KevinQianjin/ASRC_snake_body_design/simulations/u4m2/README.md

# 伸縮後端＋U/M前端：第一輪平面計算

## 結論

固定斜軸後端有穿過底孔及在箱內伸入的幾何空間；較大截面鋁管的理想梁撓度亦可控制在毫米量級。但目前不能確認整機可安裝並帶500 g工作。主要限制是柔性前端的重載下垂、極窄的靜態擺放窗口，以及尚未找到的進入路徑。

在這次有限搜尋中，通過局部穩定、≤5%軸向應變診斷、自包絡及CAD靜態間隙初篩的細網格案例只有U3/M7、20°、上繩8 N：

- 從A孔沿正長度方向送入，接口沿斜軸位置約883.45–884.28 mm；窗口僅0.83 mm。
- 前導向基準在入口沿軸後退200 mm，因此後端外露長約1084 mm，超出原先暫定1000 mm。
- 前端頭部低於接口約350 mm；最大軸向應變約4.55%。5%是診斷門檻，並非實測允許變形。
- 前端及頭部暫用32 mm膠囊包絡，與CAD實體要求5 mm間隙；該案例在最窄處只比此間隙要求多約0.1 mm。
- 保持同一已載荷形狀沿軸送入時會碰撞。沒有求解主動改變前端形狀的完整插入路徑，不能把這項失敗當成所有部署方式都不可行的證明。
- 此靜態幾何初篩先將後端視為剛性；另算的後段理想梁下垂約0.83 mm，尚未迭代耦合到前端與間隙，接頭與公差也未計入。因此不把該窄窗口當成可用設計。

若限制後端從前導向基準至接口最多1000 mm，本輪搜尋未找到通過上述低應變靜態診斷篩選的姿態。未證明全控制域無解。

## 輸入與假設

| 項目 | 本輪設定 |
|---|---|
| 油箱來源 | Google Drive `Fuel Tanke Setup 2nd design.step`，2026-10-22版本 |
| 原檔連結 | https://drive.google.com/file/d/1ddxQdy7Ntn-YRJYCHj-clbpXVldIivso/view |
| CAD處理 | 選取油箱子樹，剔除外部測試架；保留本體與五金 |
| 平面座標 | 長度=-原X，高度=原Y；寬度=-原Z，單位mm |
| 切面 | 寬度648 mm主截面；632/664 mm前端側切面；628/668 mm後端側切面 |
| 前端 | 10節×48 mm=480 mm柔性段＋20 mm無質量剛性接口；未縮放原模組物性 |
| 配比與排列 | U3/M7、U5/M5、U7/M3，U在近端，M在遠端 |
| U安裝 | 高剛度Y彎曲平面對應本輪垂直平面；未驗證左右能力 |
| 頭部 | 500 g集中力，幾何包絡暫按直徑32 mm，無偏心力矩 |
| 繩索 | 四繩、導孔半徑13 mm、原有PA6實心代理EA與線密度、無摩擦；錨定頭部 |
| 後端幾何 | 箱外固定套管50 mm；活動段採保守40 mm全長截面包絡；額外間隙5 mm |
| 後端結構 | 40×40×2與30×30×2鋁方管分段梁；另算單30×30×2對照 |
| 鋁材假設 | E=69 GPa，密度2700 kg/m³；240 MPa僅為未選定材料的強度假設，不作採購或額定依據 |
| 支承 | 最前導向基準在入口中心沿軸後退200 mm；箱外固定套管長暫300 mm |
| 伸縮接頭 | 梁計算先忽略接頭柔度與間隙；不是實際伸縮接頭驗證 |

實際頭部外形、質量分布、接頭重疊、電機、支架與線管尚未確定。五個離散寬度切面不是完整三維掃掠。

## 計算範圍與解讀

1. `cad_sections.py`以OCP對真實CAD零件與平面做Boolean交集，保留截面面域與孔。曲線離散弦高0.1 mm；皮板／孔框面積與原CAD面積核對。五截面沒有Boolean或離散失敗；中心面一個小五金件的0.007 mm端點誤差以明列0.02 mm容差連接。
2. 後端軸線幾何掃描兩個入口、兩個伸入方向、5–30°（1°步長）；孔內接口位置0–1000 mm。另列被強制保持直線的500 mm前端幾何，該直線不是500 g力學解。
3. 柔性前端採幾何非線性、可軸向伸縮桿及真實端盤導孔。10/15/20°完成612次力控制嘗試；25/30°另補60次上繩力控制。數值界限與力網格詳各程式／JSON，均不是硬體額定值或材料強度。
4. 15組穩定且≤5%應變的最大前伸代表狀態做同張力4→8單元／節加密；頭部最大差約0.106 mm。這是同張力比較，並非相同捲筒指令比較。
5. 初始10 mm位置網格之外，對低應變候選用連續高度優化與0.25 mm間隙補查，再以邊界求根核對窄窗口。最終以`adaptive_summary.json`及`study_validation.json`為準；`planar_summary.json`只記錄原粗網格。
6. 固定形狀的插入檢查另以2 mm位移步長檢查碰撞，沒有把靜態通過當成部署通過。
7. 端部固定繩長穩定性是局部平面診斷；另加1 m自由繩長只做不變姿態／張力下的切線剛度敏感性，沒有求解相同winch指令的新姿態。

## 圖片（全英文）

- `results/planar_installation.png`：強制幾何姿態與載荷平衡的實際CAD截面比較。
- `results/front_and_geometry_limits.png`：U/M重載形狀及不同斜角的幾何伸入限制。
- `results/rear_beam_screen.png`：理想後段管體的撓度與名義應力。
- `results/deployment_path.png`：保持載荷形狀送入時的碰撞檢查。

## 重算

保留原有模型與結果，本研究全部另存。主要入口：

```powershell
python simulations/u4m2/cad_sections.py
python simulations/u4m2/rear_beam.py
python simulations/u4m2/front_solver.py
python simulations/u4m2/refine_front.py
python simulations/u4m2/front_angle_extension.py
python simulations/u4m2/planar_clearance.py
python simulations/u4m2/adaptive_screen.py
python simulations/u4m2/verify_study.py
python simulations/u4m2/render_results.py
```

為節省空間，已按使用者要求移除大型隔離CAD執行庫與安裝暫存；已有結果、圖片、程式及STEP來源仍保留。重新擷取CAD截面或執行間隙／繪圖程式前，需重新安裝依賴：

```powershell
python -m pip install --target simulations/u4m2/_cad_runtime --no-deps -r simulations/u4m2/requirements-cad.txt
```

數值計算另需NumPy、SciPy、Matplotlib。原始STEP及原有力學kernel雜湊保存在驗證JSON中。

## 下一步應先驗證什麼

先釐清500 g頭部真實外形，以及插入時是否允許導向輔具或主動改變前端形狀。後續應先解部署路徑與帶載前端控制，再定後端行程與接頭設計。現階段不建議僅憑理想梁的小應力就製作整機。

## 補查：插入張力與增加U

依使用者新指示，`insertion_tension_study.py`另計U7/M3、U8/M2、U9/M1及全U對照，根部仰角15/20/25°，上繩差動張力0–200 N有限網格，四繩共同基準0或2 N。U的高剛度彎曲平面始終朝向重力造成的彎曲；此取向在前一輪也已採用。

912次嘗試中752筆收斂。未找到同時符合暫定接近直線條件（最大軸線偏差10 mm、切線誤差5°、軸向投影至少475 mm，以及5%應變診斷門檻）的案例；這些指標不是經使用者核准的正式驗收值。12個低應變代表姿態做8單元／節加密。大拉力下可能出現大壓縮或回折，不能將較小的軸線距離直接當成拉直。

此補查仍沿用四繩全部錨在頭部，沒有求解隨插入深度改變張力的完整避障軌跡，也沒有重算CAD間隙。結果於`results/insertion_tension_*`，圖中文字全英文；不需要重新安裝CAD依賴即可執行本項補查。

## 補查：分段錨定與局部路徑

`segmented_tendon_study.py`比較U8/M2、U9/M1，仰角20°、頭重500 g；單一頭部錨定、U/M交界兩組錨定、三組錨定及每節錨定對照。各組繩索均從基部經真實端盤到達自身錨點，沒有假設虛構的局部致動器或不受壓前端；遠端繩索仍壓縮近端模組。每組按四條繩索計質量，本平面只優化上繩。增加錨點需要改導孔與布線，既有四個導孔不能視為已能容納新增拉索。

最佳已找到局部解的8單元／節診斷（不是全域最優）：

| U9/M1架構 | 最大軸線偏差 mm | 沿軸投影 mm | 最大絕對軸向應變 | 局部穩定診斷 |
|---|---:|---:|---:|---|
| 單組 | 406.4 | 101.5 | 17.5% | 通過 |
| 兩組 | 245.1 | 310.2 | 7.4% | 未通過 |
| 三組 | 26.4 | 450.3 | 12.2% | 通過 |
| 每節一組（10組） | 2.44 | 459.3 | 13.9% | 通過 |

U9/M1每節錨定解的最大壓縮發生在第1節U；U8/M2對照最大壓縮則在第9節M，達28.3%。因此更多分段控制能改善曲線，卻沒有消除軸向承載問題。所有大應變結果仍是原線性EA外推，不是塑性、壓屈或實際模組耐久預測。10組錨定是複雜度對照，不是已選定的製作方案。

另以粗網格軸向應變≤5%作限制進行局部優化（`--low-strain`），未找到接近直線的解；同張力加密後應變約5.03–5.23%，因此也不能將粗網格邊界解當作嚴格5%通過。求解器的變形界限與每組250 N張力上限只是明示數值界限，並非材料／致動器額定能力。

`lightweight_path_check.py`直接用已保存的CAD多邊形及NumPy計算間隙，不需重新安裝CAD庫；與先前OCP/Shapely參考間隙的差小於1e-6 mm。U9/M1的10組錨定高應變診斷形狀，在頭部已先進入後，接口位置s=-180至400 mm（2 mm步長）的局部伸入路徑未碰撞，前端包絡最小間隙約24.52 mm。這沒有驗證最初將頭部送入、伸縮套管內部收納／布線、實際大應變行為或完整三維部署。

新圖：`results/segmented_tendon_comparison.png`及`results/segmented_insertion_path.png`，全部英文。新增程式與數據保持小型，未安裝新的CAD執行庫。
