KevinQianjin/ASRC_snake_body_design/simulations/u4m2/backbone_20261108/README.md

## Position-controlled round-trip study (11 November 2026)

See [the generated report](length_cycle_results/REPORT.md) for the forward-solved
12-rope length-control cycle, full-tank sampled clearance, consistent elastic-rope
stability and one-factor sensitivity cases. This extends the earlier force-based
sweeps; it does not establish hardware performance or continuous collision safety.

- `length_cycle.py`: straighten from a defined slackened equilibrium, enter,
  right/return, left/return and withdraw; 8 cells/module.
- `summarize_length_cycle.py`: acceptance failures, provenance and comparison plot.
- `test_length_cycle.py`: numerical energy/gradient/Hessian and mesh-query checks.
- `length_cycle_results/`: per-step CSV/JSON, states and aggregate report.

# M module with 1.8 mm NiTi backbone: straightening and steering

2026-11-08 · 63 mm · 24 mm tendon radius · 500 g head · follow-up to `../m_axial_sweep_20261108`

This study adds a central Ø1.8 mm NiTi rod to every M module, including its mass, and re-runs two of the 2026-11-06 studies:

- the planar active-straightening study (U4+M2, U6+M3 and U8+M4 at 15°, 20° and 25°);
- the spatial steering and held-elevation study (U4+M2).

The physical build and test plan is in [`M_BACKBONE_TEST_PLAN.md`](M_BACKBONE_TEST_PLAN.md).

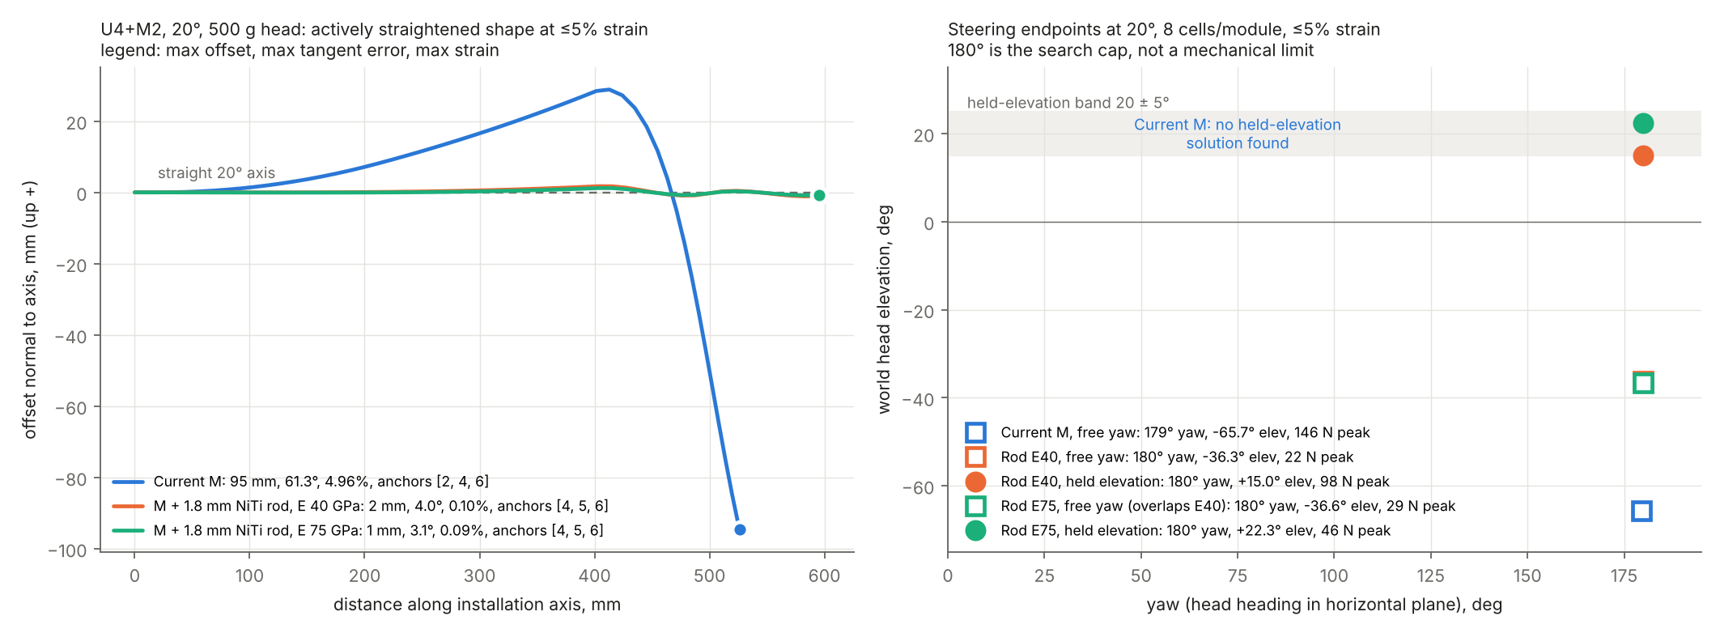
[picture p1: simulations/u4m2/backbone_20261108/results/backbone_results.png]
Backbone results


## Rod model

| | M (database) | + rod, E = 40 GPa | + rod, E = 75 GPa |
|---|---:|---:|---:|
| EA, N | 166.7 | 101,954 | 191,018 |
| EI, N·m² (both planes) | 0.0441 | 0.0647 | 0.0828 |
| Module torsion, N·m/rad | 0.437 | 0.599 | 0.740 |
| Mass per M module, g | 23.948 | 25.524 | 25.524 |

- The rod is modelled as central, bonded to the module end disks and bending with the module, so its stiffness adds to the module's.
- E = 40 GPa represents a martensite or low-modulus lower bound; 75 GPa represents austenite. Torsion uses ν = 0.33.
- Rod end fittings and guides are not included in the mass. Neither are friction, NiTi phase transformation or contact.
- All other inputs are identical to the 2026-11-06 studies. The kernels are reused through `backbone.py` and are not modified.

## 1. Planar active straightening (`backbone_planar.py`)

The best stable result at ≤5% strain at 8 cells per module is shown below. "Pass" means all straightness checks pass: offset ≤ 10 mm, tangent error ≤ 5°, axial projection ≥ 95%, strain ≤ 5%, and stable.

| Configuration | Pitch | Current M | Rod, E = 40 GPa | Rod, E = 75 GPa |
|---|---:|---|---|---|
| U4+M2 | 15° | 89.7 mm / 57.5° — fail | **1.8 mm / 4.1° / 0.10% — pass** | **1.2 mm / 3.2° — pass** |
| U4+M2 | 20° | 94.7 mm / 61.3° — fail | **1.7 mm / 4.0° / 0.10% — pass** | **1.2 mm / 3.1° — pass** |
| U4+M2 | 25° | 99.1 mm / 64.9° — fail | **1.7 mm / 3.7° / 0.09% — pass** | **1.2 mm / 3.0° — pass** |
| U6+M3 | 20° | 176.8 mm / 87.2° — fail | 10.5 mm / 15.1° — fail | 9.6 mm / 10.5° — fail |
| U8+M4 | 20° | 278.0 mm / 98.1° — fail | 135.2 mm / 102.5° — fail | 19.2 mm / 29.9° — fail |

- **U4+M2 passes at all three pitches**, with anchors [4,5,6]. At 20° and E = 40 GPa, the top-rope tensions are 91.5, 21.4 and 8.5 N.
- **U6+M3 and U8+M4 do not pass** with three or fewer anchor sets. A search of every three-set layout with one set at the head (28 for U6+M3 and 55 for U8+M4, each at both moduli, 20°, `--all-three`) found no passing case. The closest was U6+M3 with anchors [7,8,9], at 5.04° tangent error but a 24.5 mm offset. Their M sections are longer, and gravity bending between anchor disks grows with the length of each span.
- The current-M (no rod) column reproduces the 2026-11-06 report values, for example 94.68 mm at 20° for U4+M2.

## 2. Spatial steering and held elevation, U4+M2 (`backbone_steering.py`, `refine_backbone_steering.py`)

The procedure, bounds and acceptance rules follow 2026-11-06:

- tendon tension 0–250 N;
- coarse strain bound ±4.75%;
- 180° angle search cap;
- geometry, capsule and fixed-winch stability checks.

Candidates start at 2 cells per module and are refined to 4 and then 8. A candidate is reported only if it passes at 8 cells. "Held elevation" means yaw with the world head elevation within base pitch ± 5°.

| Variant | Pitch | Free yaw (elevation, peak N) | **Yaw with held elevation** (elevation, peak N) | Up / down |
|---|---:|---|---|---|
| Current M | 20° | 179.4° (−65.7°, 146.5 N) | **none found** | −56.6° / 113.8° |
| Rod, E = 40 GPa | 15° | 180°* (−33.3°, 24.4 N) | **165°** (+10.0°, 56.5 N)† | 180°* / 180°* |
| Rod, E = 40 GPa | 20° | 180°* (−36.3°, 22.2 N) | **180°*** (+15.0°, 98.3 N) | 180°* / 180°* |
| Rod, E = 40 GPa | 25° | 180°* (−39.5°, 21.1 N) | **180°*** (+30.0°, 246.9 N) | 180°* / 180°* |
| Rod, E = 75 GPa | 20° | 180°* (−36.6°, 29.3 N) | **180°*** (+22.3°, 46.2 N) | 180°* / 180°* |

\* Reaches the 180° search cap. This is not a demonstrated mechanical limit.
† At 15°, no 180° held state survived the 8-cell check: it was unstable at +10° elevation. The largest lower cap that passed was 165°.

- The no-rod control reproduces the 2026-11-06 results exactly at 8 cells: 179.42°, −65.67°, 146.48 N, and no held-elevation solution.
- **With the rod, the head can be swept through the full ±180° yaw search range while held near the working elevation**, at well under 1% strain. This was the main unsolved problem (priority 2) in the 2026-11-06 report.
- Strain is no longer limiting: it stays at or below 0.62% everywhere. The constraints that now decide the result are tension, stability and the elevation band.
- **The tensions are one allocation found by the optimizer, not minimum-force solutions.** The 8-cell re-optimization maximizes angle only, so tensions can rise during refinement: at 20° and E = 40 GPa, the 2-cell candidates needed about 33 N, while the 8-cell result needs 98 N. The 25° held case sits near the 250 N bound and at the edge of the elevation band. Minimum-tension allocation is a recommended next step.
- "Up 180° at elevation = −pitch" means the head has turned over the top and points back. Whether the intermediate postures form a continuous controllable path is not established.
- Full tension sets for every endpoint are in `results/steering_summary_8cell.json`. Each row is one anchor set, in the order [up, right, down, left], in N.

## 3. Tank entry screen with the straight low-strain shape (`entry_screen.py`, 2026-11-09)

This re-runs the 2026-11-06 front-only entry screen, reusing `path_check()` from `../stiffness_63mm_20261106/postprocess.py` unchanged. The best stable shape at ≤5% strain is held at fixed tension and translated along the installation axis through the bottom opening at x = 449 mm. The run starts with the whole front and head outside the tank and steps 4 mm, then 2 mm. Pass requires:

- the 63 mm envelope stays at least 5 mm clear of the five saved CAD width sections (628–668 mm) along the whole path;
- the front ends fully inside the sampled cavity.

Passing shapes are re-solved at 16 cells per module with the same tensions and re-checked. As a control, the 2026-11-06 U4+M2 20° shape-only result (62.06 mm) is reproduced exactly.

| U4+M2 | Pitch | Strain | Min gap, 8 cell | Min gap, 16 cell | Final clamp s | Result |
|---|---:|---:|---:|---:|---:|---|
| Current M | 15° / 20° / 25° | 4.96% | hits the tank at s ≈ −336 mm | — | — | fail |
| Rod, E = 40 GPa | 15° | 0.10% | 44.5 mm | 44.3 mm | 114 mm | **pass** |
| Rod, E = 40 GPa | 20° | 0.10% | 64.3 mm | 64.0 mm | 90 mm | **pass** |
| Rod, E = 40 GPa | 25° | 0.09% | 16.6 mm | 16.9 mm | 78 mm | **pass** (tight) |
| Rod, E = 75 GPa | 15° / 20° / 25° | 0.09% | 44.6 / 64.6 / 16.1 mm | 44.5 / 64.4 / 16.2 mm | 114 / 90 / 78 mm | **pass** |

- **This is the first low-strain shape to pass the entry screen.** On 2026-11-06, only shapes at 17% or more strain passed; every low-strain shape sagged into the tank.
- The margins match the 2026-11-06 high-strain straight shapes (44 / 62 / 20 mm), so the rod gives the same geometry at about 1/170 of the strain.
- **Where the limit is:**
  - At 15° and 20°, the tightest point is the distal M section passing internal structure just after the head enters, at clamp s ≈ −355 mm.
  - At 25°, crossing the opening is comfortable (about 50 mm), but at the final placement the head is only about 19 mm below the roof. 20° remains the preferred installation angle.
- U6+M3 with the E = 75 GPa rod passes only at 15° (40 mm). It fails at 20° and 25°, and every U8+M4 case fails. U4+M2 remains the development length.

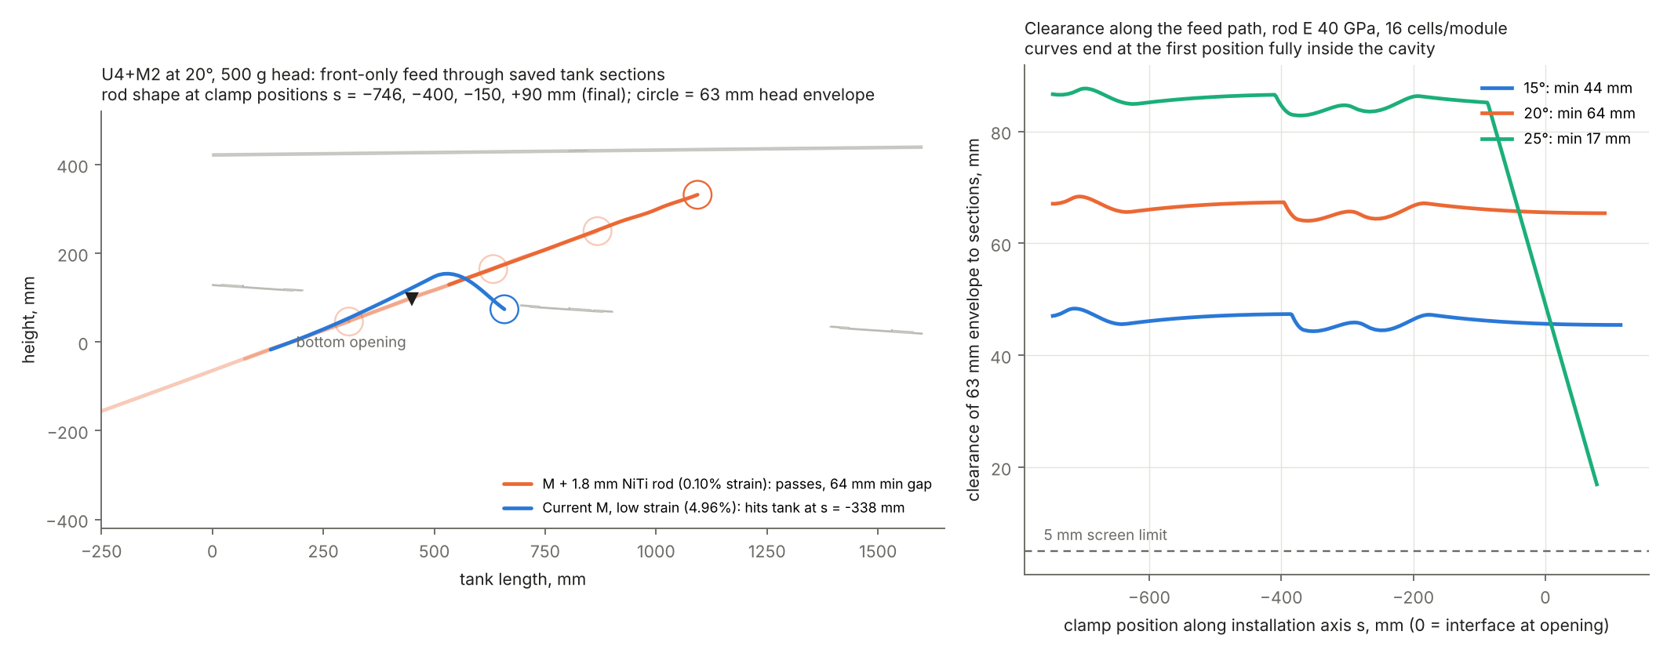
[picture p2: simulations/u4m2/backbone_20261108/results/entry_screen.png]
Entry screen


**Limits, unchanged from 2026-11-06:**

- Planar sweep of a fixed shape with a translating clamp.
- The five width planes do not cover the full 616.5–679.5 mm band of a 63 mm front.
- Not included: sleeve or guide contact, rear storage, rope take-up, retraction, tension changes during feed, and real head CAD.

This is a geometric screen, not a validated deployment.

## 4. 3D stability needs pretension on every rope (`pretension_recheck.py`, 2026-11-09)

The straightened states in sections 1 and 3 tension only the up ropes. They pass the planar stability check, but **in the 3D model they are laterally unstable** under the fixed-winch check (minimum eigenvalue −0.20 to −0.50), because the 2D model cannot see sideways buckling.

A **1 N pretension on all four ropes of every anchor set** stabilises every case. The straightening was then re-optimised with this pretension:

| U4+M2, anchors [4,5,6], +1 N on all ropes | 15° | 20° | 25° |
|---|---|---|---|
| E = 40 GPa: offset / tangent / strain | 1.86 mm / 4.2° / 0.11% | 1.82 mm / 4.0° / 0.11% | 2.00 mm / 3.5° / 0.10% |
| E = 40 GPa: top-rope tensions, N | 95.1, 21.8, 8.7 | 92.7, 21.2, 8.5 | 89.5, 20.5, 8.2 |
| E = 75 GPa: offset / tangent / strain | 1.28 mm / 3.3° / 0.10% | 1.25 mm / 3.1° / 0.10% | 1.21 mm / 3.0° / 0.10% |
| All straightness checks, 3D stable | yes | yes | yes |
| Tank entry minimum gap, E = 40 / 75 GPa | 44.6 / 44.7 mm | 64.2 / 64.6 mm | 17.2 / 16.1 mm |

The conclusions of sections 1 and 3 stand **with a minimum 1 N pretension on every rope**. This should become a control rule.

## 5. Minimum tendon force for held-elevation yaw (`min_force_sweep.py`, 2026-11-09)

**Method.** The yaw target is stepped from 0° to 180° by continuation, each step seeded from the previous solution. At each step the optimiser minimises the **largest single rope tension** subject to:

- equilibrium;
- yaw equal to the target;
- world head elevation within pitch ± 5°, or held exactly at pitch;
- the 2026-11-06 geometry and projection constraints;
- strain within ±4.75%;
- 1–250 N per rope.

Each state is solved at 4 cells per module, then re-solved at 8 cells (re-optimised if needed). It is accepted with the unchanged 2026-11-06 rules, including fixed-winch stability, and must be within 1° of the target yaw. An optional penalty on changing tensions between steps (`--smooth`) selects a smooth allocation among the many allocations with nearly the same peak.

| Run (elevation held exactly at pitch, 5° steps) | Passing states (8 cell) | Peak rope tension | Largest change per step |
|---|---|---|---|
| E = 40 GPa, 20°, anchors [4,5,6], smooth | 36/37 (0–175°) | **7.1–14.8 N** | 5.1 N |
| E = 40 GPa, 20°, anchors [4,5,6] | 37/37 (0–180°) | 7.0–14.8 N | 13.8 N (allocation jumps) |
| E = 40 GPa, 20°, anchors [4,6] | 36/37 (0–175°) | 13.3–22.0 N | 20.9 N |
| E = 75 GPa, 20°, anchors [4,5,6], smooth | 37/37 (0–180°) | 9.8–14.6 N | 4.4 N (10 N at the 180° step) |
| E = 40 GPa, 25°, anchors [4,5,6] | 37/37 (0–180°) | 6.7–13.3 N | 12.3 N |

Runs with the elevation anywhere in the ±5° band (15° steps) also pass at every step: E = 40 GPa at 15°, 20° and 25°, and E = 75 GPa at 20°; 7–21 N peak.

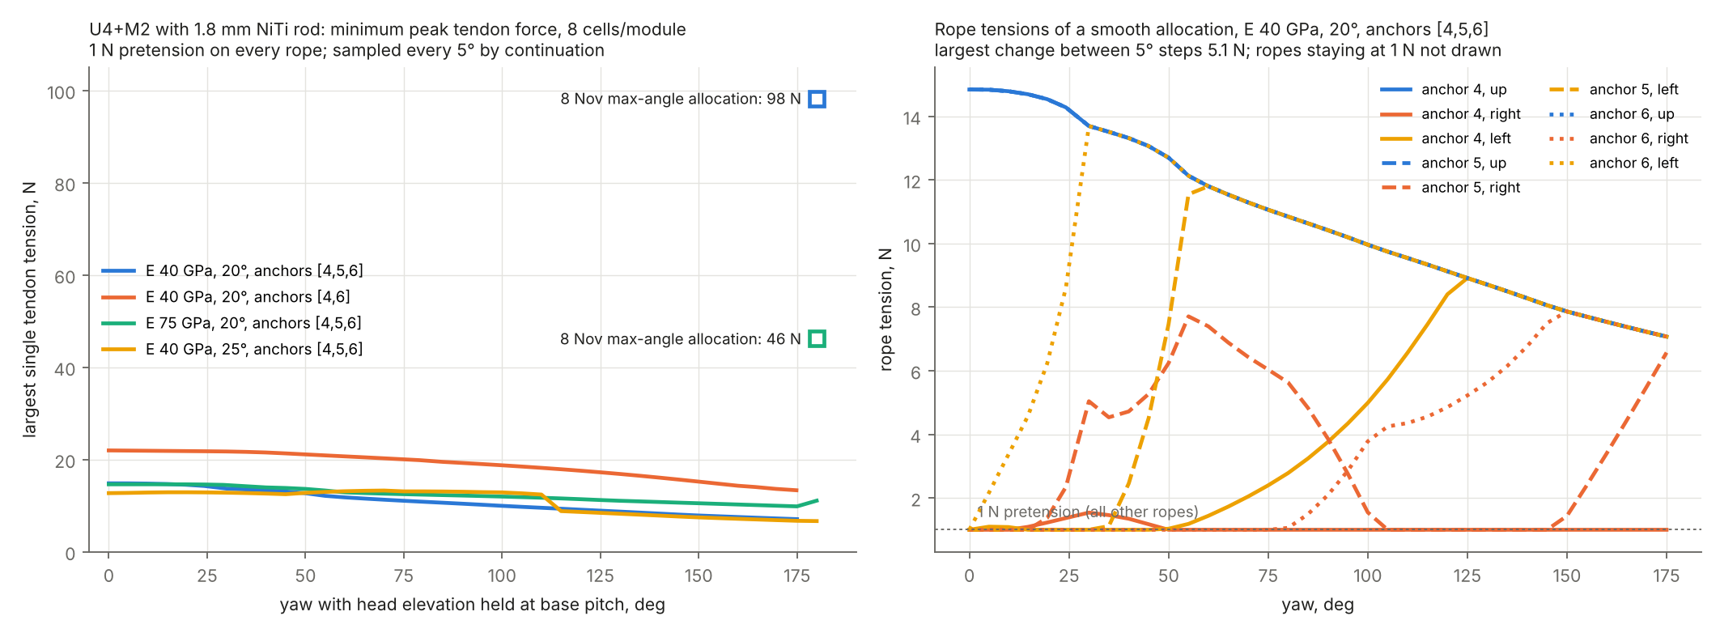
[picture p3: simulations/u4m2/backbone_20261108/results/minforce_results.png]
Minimum tendon force


- **Peak tendon force drops from 46–247 N (2026-11-08 allocations, which maximised angle only) to about 7–15 N** with anchors [4,5,6] and 13–22 N with [4,6]. Strain stays at or below 0.09%, and every reported state is stable.
- **Continuity.** With elevation held exactly at 20°, consecutive 5° states move the head at most 33–56 mm, consistent with yaw swept by the front. The smooth allocation changes no rope by more than 5.1 N per step (E = 40 GPa). This is strong evidence of a continuous quasi-static path from 0° to 175°, but sampled states do not prove one.
- **How the posture works.**
  - Mid-range yaw (30–90°) uses sideways M bending together with **30–55° of material twist** along the front.
  - Yaw near 180° is reached by curling M **up and back over itself** (about 140° of upward bend). The head ends up looking back toward the base at 20° elevation, about 270 mm above the interface.
  - Hardware must confirm that twist is acceptable, and the up-and-over posture must be checked against the tank roof, which was not part of this free-space study.
- The minimum-peak objective is degenerate: many allocations share the same peak. Without smoothing, the optimiser re-allocates freely between steps. Use the smooth allocation as the control reference.
- These are local optima, not proven global minima. The 1 N pretension and the 250 N bound are numerical choices, not hardware ratings.

## 6. Full 3D tank clearance (`tank3d_screen.py`, 2026-11-09)

**Method.**

- All 362 solids of the named tank subtree in `../../../cad/tank/tank-v2.step` (external frame excluded) are triangulated: 461,524 triangles at 0.5 mm deflection, cached in `_cache/`, not committed.
- Clearance is the exact distance from the front centreline to that surface, minus the 31.5 mm envelope radius. The minimum is found by a 20 mm pass refined at 2 mm near the closest region; this matches brute-force sampling exactly.
- The insertion plane is width 648 mm, the centre of the 2026-11-06 section band. The insertion point and axis are those of the 2D entry screen.
- Control: points on the boundaries of the five saved 2D sections lie within 0.23 mm of the 3D mesh.

**Entry path, full 3D, straight shape with 1 N pretension.** Minimum clearance up to the first fully-inside clamp position:

| Pitch | 2D sections (5 planes) | Full 3D |
|---:|---:|---:|
| 15° | 44.6 mm | 46.8 mm |
| 20° | 64.2 mm | 64.6 mm |
| 25° | 17.2 mm | 19.3 mm |

The full-width 3D result confirms the 2D screen. The 2D values were slightly conservative because they measured in-plane distance to planes up to 20 mm away sideways. **This closes the "5 planes do not cover the full 63 mm width" limitation of the 2026-11-06 entry screen.**

**Held-elevation yaw sweep in the tank.** The minimum-force states of section 5 were placed with the clamp held at depth s, yawing both right and left; the tank is not symmetric about the insertion plane.

| 20°, anchors [4,5,6], head held at 20° | s = 0 mm | s = 30 mm | s = 60 mm | s = 90 mm |
|---|---|---|---|---|
| E = 40 GPa, right (0–175°) | all clear, min 22.4 mm | all clear, min 12.6 mm | 33/36, min 2.8 mm | 26/36: clear to 130° |
| E = 40 GPa, left (0–175°) | all clear, min 30.9 mm | all clear, min 20.9 mm | all clear, min 11.0 mm | 33/36: clear to 160° |
| E = 75 GPa, right (0–180°) | all clear, min 23.5 mm | all clear, min 13.6 mm | 35/37, min 3.7 mm | 25/37 |
| E = 75 GPa, left (0–180°) | all clear, min 30.1 mm | all clear, min 20.1 mm | all clear, min 10.2 mm | 34/37 |

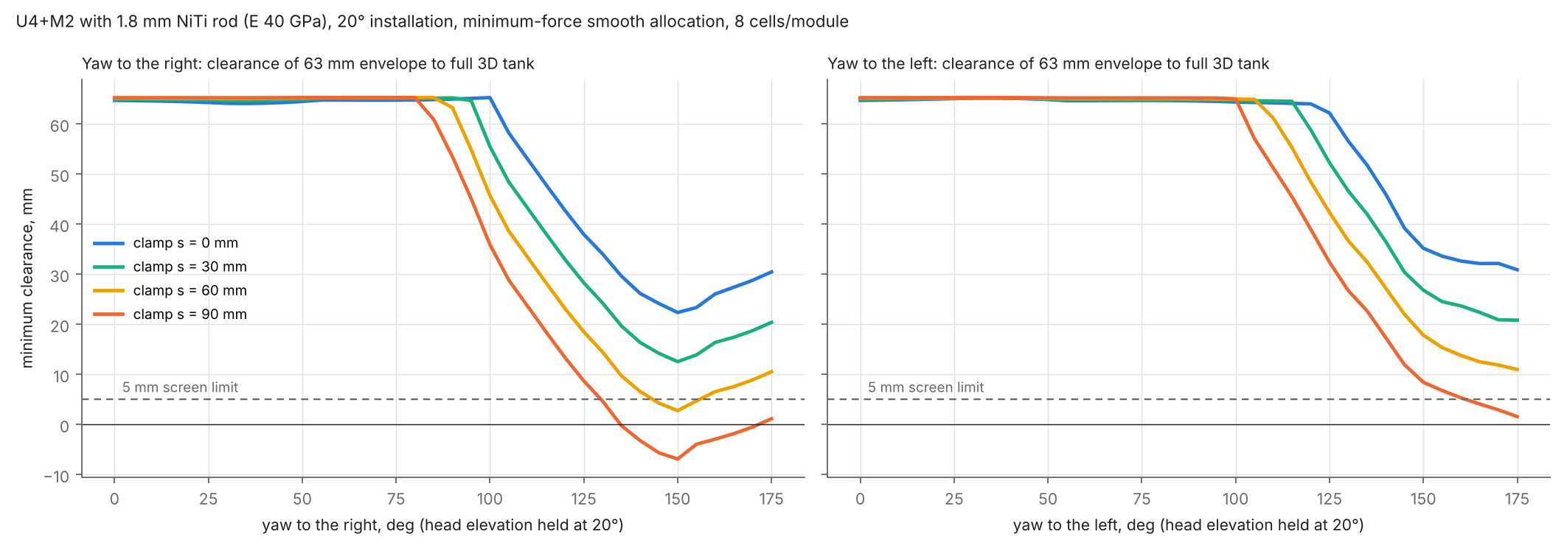
[picture p4: simulations/u4m2/backbone_20261108/results/tank3d_sweep.png]
3D tank clearance


- **At 20° with the clamp at s = 0–30 mm, the whole held-elevation sweep (0–175°/180°, both sides) clears the full 3D tank by at least 12.6 mm.** Clearance up to about 85° yaw stays at about 65 mm. It drops only for the up-and-over posture beyond about 100°, and the limit is always the **tank roof**, near height 365–430 mm.
- Pushing deeper (s ≥ 60 mm) raises the base and brings the curled M section into the roof. Recommended steering depth: **s ≈ 0–30 mm**, with the interface at or just past the opening.
- **25° fails** at every depth tested (s = 0–300 mm; at most 15 of 37 states clear). The front sits too close to the roof. **20° is the recommended installation angle.**
- Not included: the actual sensor head shape (a 63 mm envelope is assumed), cables and ropes outside the front, tolerances, dynamics, and contact with any sleeve. The steering states are free-space minimum-force equilibria placed in the tank, not tank-aware optimised postures.

## 7. Horizontal flexibility: yaw vs side-rope pull (`side_pull.py`, 2026-11-09)

**Start pose:** the straight held front at 20° (anchors [4,5,6], straightening tensions on the up ropes, 1 N on every rope).

**Test:** only the right rope is pulled — at anchor 6 (tip), 5, 4, or all three together. Each step is solved from the previous state at 8 cells per module, in free space; the left side is the mirror image.

**Two control modes:**

- **Tension control:** rope forces are prescribed.
- **Winch control** (realistic): rope lengths are set by the winches. Each rope is an elastic PA6 line (EA = 10.4 kN) with 1 m of free length, and the right rope is reeled in 0.25 mm per step.

**Finding 1: tension control is unsafe for the straight pose.**

- Under constant tensions the straight held front is laterally unstable (constant-tension eigenvalue −0.51 at E = 40 GPa, −0.28 at 75 GPa). Adding 0.5 N to the tip's right rope makes the head **snap 258 mm** to 124° yaw.
- Under winch control the same pose is stable (fixed-winch eigenvalue +0.73 / +0.76), because the elastic ropes resist the motion.
- **Rope length (position) control, or fast feedback, is required.** Tension-only control must not be used to hold the straight front.

**Finding 2: winch-controlled side pull**

| Pulled rope | Initial gain | Yaw while head stays in 20 ± 5° | Maximum yaw reached (head elevation) | Limit | Largest head jump per step |
|---|---|---|---|---|---|
| Anchor 6 right, E = 40 GPa | 1.27°/mm | **18.6°** (14 mm, 37 N) | 58.5° (−41°), 27 N | no further equilibrium | 1.0 mm |
| Anchor 6 right, E = 75 GPa | 1.23°/mm | **20.2°** (16 mm, 43 N) | 76.1° (−49°), 39 N | bend radius / capsule | 1.0 mm |
| All three right, E = 40 / 75 GPa | 1.36 / 1.35°/mm | 16.9° / 18.7° (65–71 N) | 27–30° (−17 to −25°), 142–163 N | bend radius / capsule | 4.3 mm |
| Anchor 5 right | 0.12–0.14°/mm | 8° | 34–39° (−34 to −40°) | bend radius / capsule | 1.6 mm |
| Anchor 4 right | ≈ 0 | 3–4° | 9–12° at 288–364 N | — | 1.3 mm |

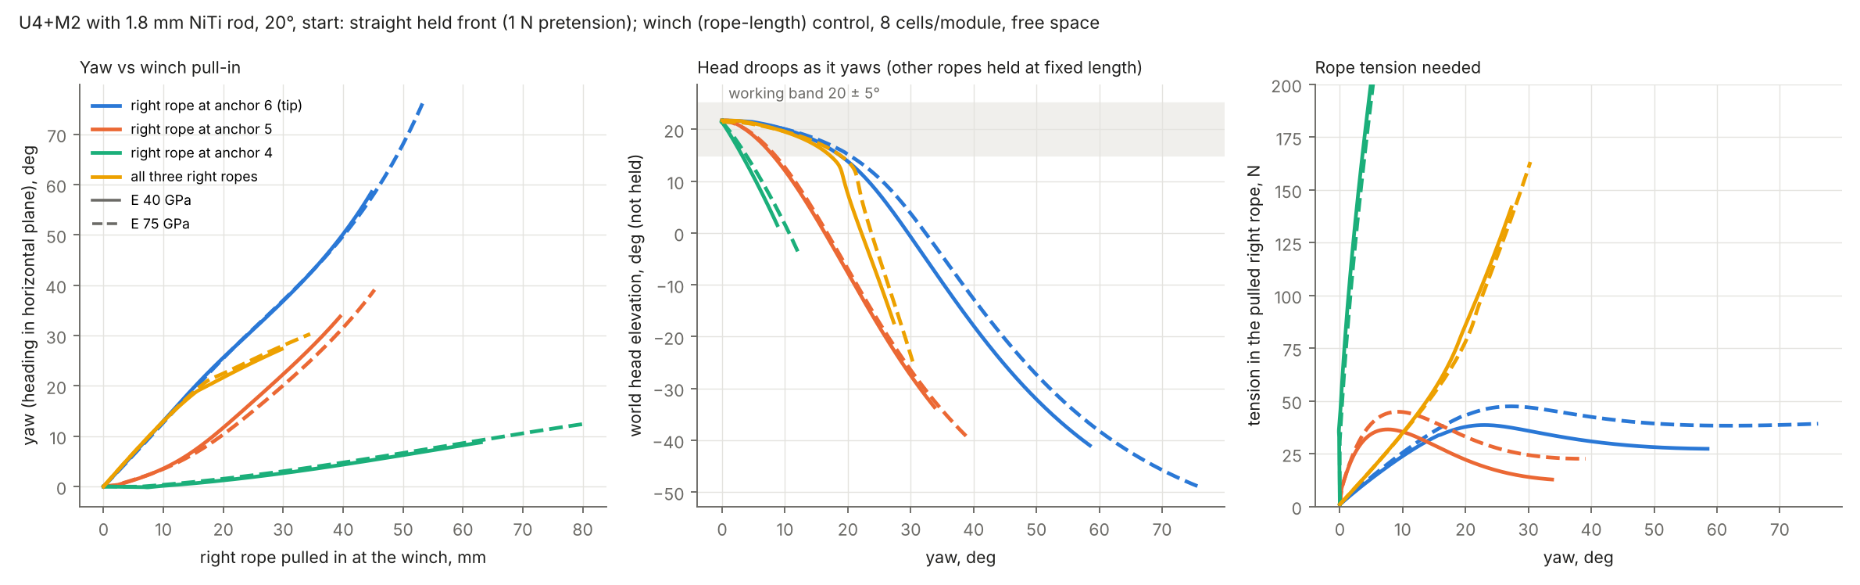
[picture p5: simulations/u4m2/backbone_20261108/results/sidepull.png]
Side pull


- **The tip rope (anchor 6) is the effective yaw actuator.** It gives about 1.25° of yaw per mm of pull-in, roughly 2 N per degree at small angles. The motion is smooth and stable at every step.
- Anchors 4 and 5 are ineffective for yaw. The U section barely bends sideways and the force goes into compressing the front: up to 364 N for 12° at anchor 4. Pulling all three right ropes adds force without adding yaw.
- **Pulling only the side rope makes the head droop.**
  - The head stays in the 20 ± 5° band only up to about **±19–20° yaw**. Beyond that the head drops below horizontal while the up-rope lengths stay locked; at the maximum yaw of 58–76° it points 41–49° downward.
  - To yaw further at the working elevation, the up ropes must be reeled in together with the side rope. Section 5 shows that coordinated tensions reach 0–175° at only 7–15 N; up to about 60° that motion stays close to a horizontal sweep (section 5 posture table).

**Not modelled:** the rope stiffness depends on the assumed 1 m free length (shorter ropes give a stiffer, more precise response). Rope friction, winch backlash, NiTi hysteresis and the tank are not included.

## 8. Coordinated winch control between poses (`coordinated_winch.py`, 2026-11-10)

This test combines sections 5 and 7. It settles the open question of what happens **between** the 5° poses when the ropes are driven by length.

**Method.**

- For every stored 8-cell minimum-force pose (head held at 20°, anchors [4,5,6], 1 N pretension), the winch length of each of the 12 ropes is computed with the fixed-winch rope model of section 7 (elastic PA6 line, 1 m free length).
- All 12 winch lengths are then moved **together**, linearly from one pose's values to the next, in 20 sub-steps per 5° segment. Each equilibrium is solved from the previous state. The result is the quasi-static motion a length-controlled drive would produce.
- The sweep is run forward and backward.

| Check | Rod E = 40 GPa (0–175°) | Rod E = 75 GPa (0–180°) |
|---|---|---|
| States solved, forward | 701, no failure | 721, no failure |
| Stable (fixed winch) and within geometry limits | all (minimum eigenvalue 0.148) | all (minimum eigenvalue 0.260) |
| World head elevation between poses | 19.15–20.08° | 19.82–20.10° |
| Yaw vs commanded (linear between poses) | monotonic, within 0.78° | monotonic, within 0.90° |
| Head movement per sub-step (0.25° of yaw) | median 0.62 mm, max 1.68 mm | median 0.62 mm, max 2.53 mm |
| Rope tension | 0.71–14.9 N, no slack rope | 0.90–14.7 N, no slack rope |
| Each segment ends on the stored pose | head within 0.00002 mm | head within 0.00002 mm |
| Backward sweep vs forward sweep | identical (head ≤ 0.00004 mm, tension ≤ 0.00001 N) | identical |
| 3D tank clearance of in-between states, clamp s = 0 / 30 mm | all clear, minimum 22.4 / 12.6 mm | all clear, minimum 23.2 / 13.4 mm |
| Strain / twist | ≤ 0.06% / ≤ 55° | ≤ 0.07% / ≤ 50° |

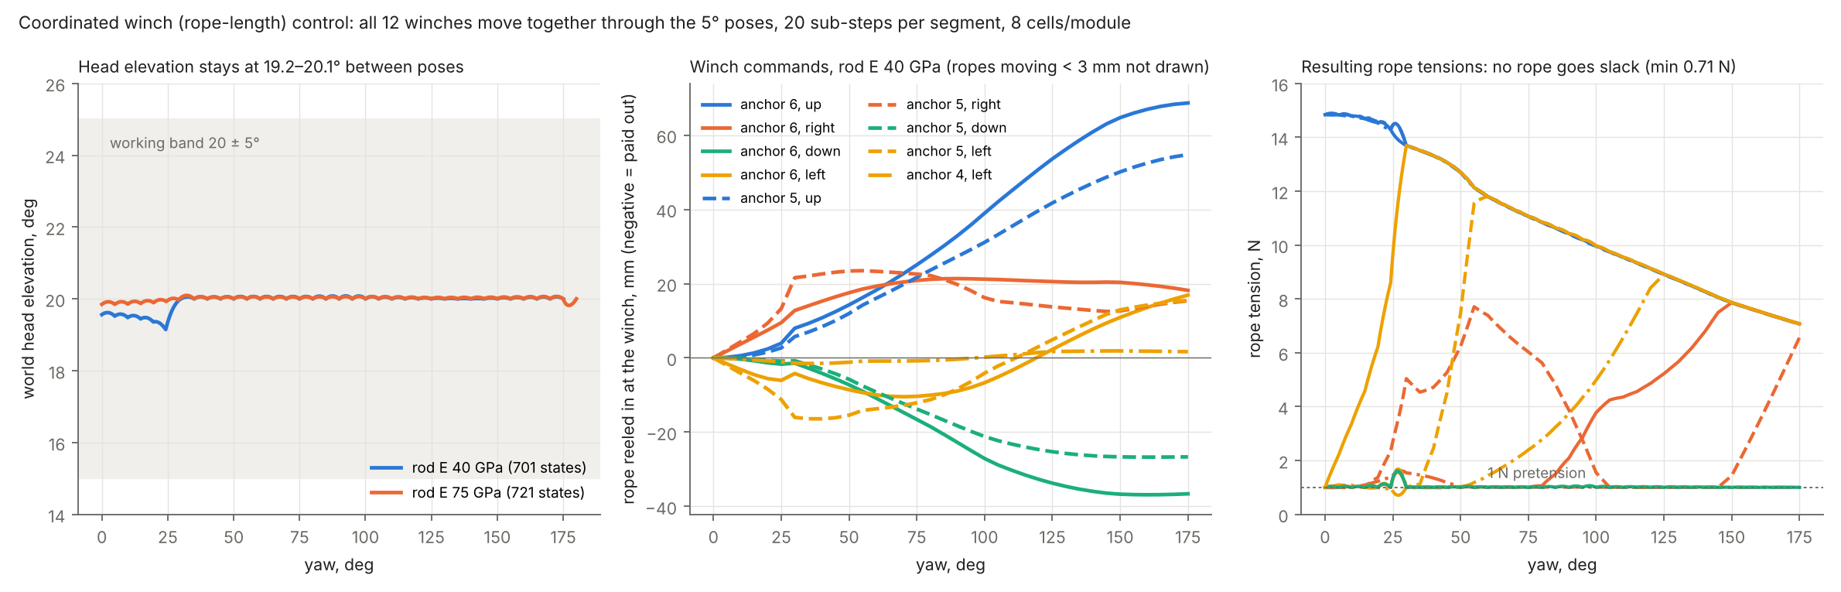
[picture p6: simulations/u4m2/backbone_20261108/results/coordwinch.png]
Coordinated winch


- **Under coordinated rope-length control the head moves smoothly and reversibly through the whole sweep at the 20° working elevation.** There is no snap, no unstable state and no slack rope at any of the 701 / 721 states, and the in-between states clear the 3D tank with the same margins as the poses. This closes the "motion between poses" question for the quasi-static model.
- **Winch requirements (E = 40 GPa).**
  - The largest travel is 68.6 mm, on the tip's up rope.
  - The fastest winch moves 1.67 mm per degree of yaw.
  - The anchor-4 ropes move less than 3.5 mm over the whole sweep. For steering they could be held at fixed length; they are only needed for straightening.
- The command table is saved in `results/coordwinch_E40_winch_table.csv` and `results/coordwinch_E75_winch_table.csv`: pull-in in mm for each rope at each 5° pose, relative to the straight pose, with the expected tension.
- **Not covered:**
  - winch position errors and rope stretch calibration, which are a sensitivity study still to do;
  - friction, dynamics and NiTi hysteresis;
  - the assumed 1 m free rope length; a different length rescales the pull-in values.

## 9. Winch position error and rope stretch sensitivity (`winch_sensitivity.py`, 2026-11-10)

**Method.** At seven poses of the coordinated sweep (yaw 0–175°, or 0–180° for E = 75 GPa; head held at 20°), using the full nonlinear model at 8 cells per module:

- Each of the 12 winch lengths was offset by ±0.5 and ±1 mm, one at a time, and the equilibrium re-solved: 336 solves per rod.
- From these, a sensitivity matrix (degrees and mm per mm of winch error) was built. It was used to predict 2,000 random cases with all 12 winches wrong at once (independent, uniform within ±e) and the worst case.
- The 10 worst predicted 1 mm cases per pose were re-solved with the full model; the linear prediction is within 1.2°.
- Rope stretch calibration: rope EA ±10% on all ropes, with the winch commands unchanged.

| Rod E = 40 GPa (E = 75 GPa similar or smaller) | yaw 0° | 60° | 120° | 150° | 175° |
|---|---|---|---|---|---|
| One winch off by 1 mm: largest head angle error | 1.7° | 1.8° | 1.4° | 2.3° | 3.2° |
| All 12 random ±1 mm (99%): yaw / elevation | 1.9° / 1.9° | 2.3° / 2.5° | 2.6° / 3.2° | 4.3° / 3.3° | 6.3° / 2.1° |
| All 12 random ±1 mm (99%): head position | 6 mm | 7 mm | 9 mm | 15 mm | 20 mm |
| **Winch accuracy for ±1° (99%)** | ±0.51 mm | ±0.41 mm | ±0.32 mm | ±0.23 mm | **±0.16 mm** |
| Winch accuracy for ±2° (99%) | ±1.03 mm | ±0.81 mm | ±0.63 mm | ±0.47 mm | ±0.32 mm |
| Winch accuracy for ±1° (worst case) | ±0.41 mm | ±0.22 mm | ±0.17 mm | ±0.13 mm | ±0.10 mm |

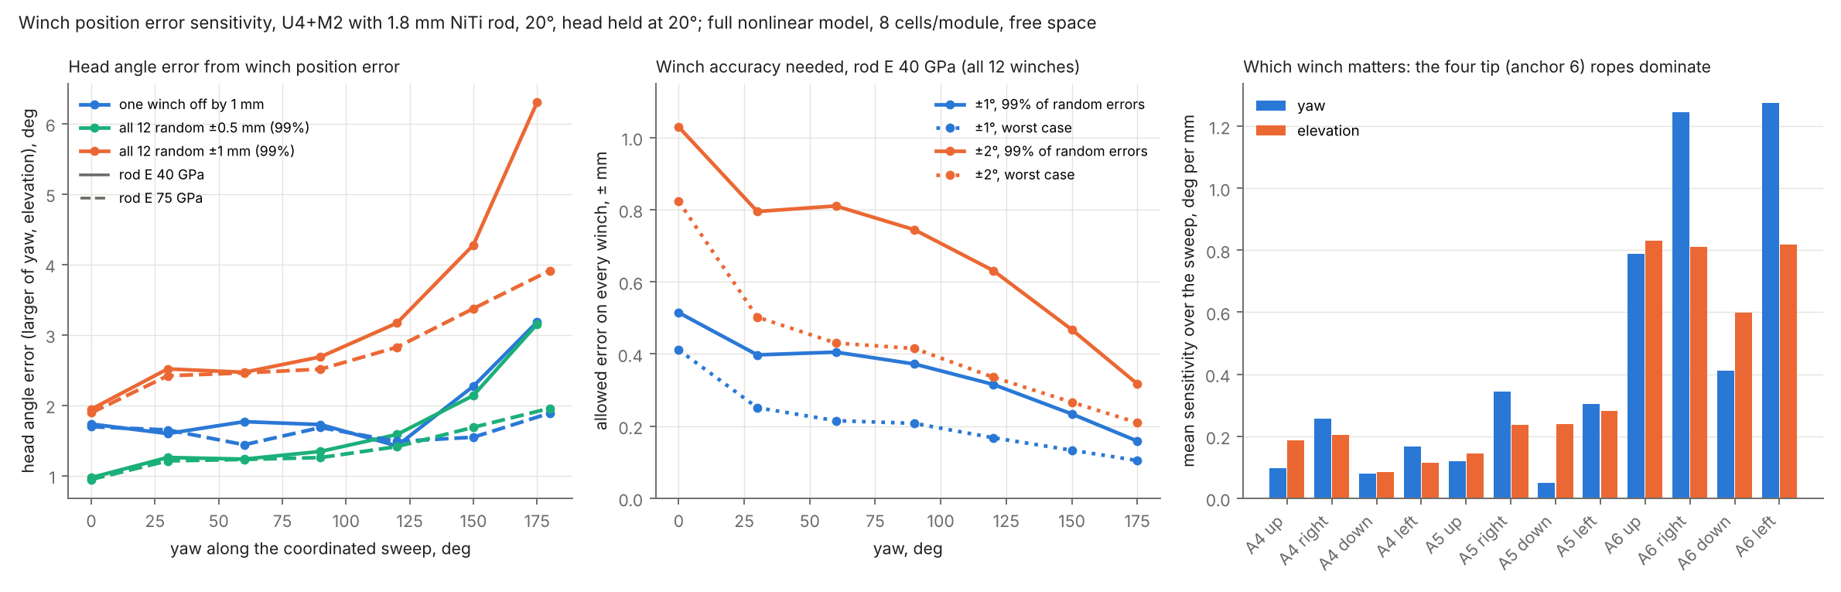
[picture p7: simulations/u4m2/backbone_20261108/results/winch_sensitivity.png]
Winch sensitivity


- **Required accuracy.** Open-loop length control needs about **±0.2–0.5 mm on every winch for ±1° of head angle**, tightening to ±0.16 mm near 175°, where the front curls up. ±2° roughly doubles these values. The 75 GPa rod is slightly less sensitive at large yaw (±0.26 mm at 180°).
- **The four tip ropes (anchor 6) dominate:** 0.4–1.3° per mm. Anchor 4 and 5 ropes are 0.05–0.35° per mm. Precision is needed mainly on the four tip winches.
- **Rope stretch calibration is not critical:** a ±10% error in rope EA moves the head by at most 0.42°.
- **Robustness.**
  - All 672 single-winch cases and all 140 combined-error checks (both rods) stay stable and within geometry limits; none fails to converge.
  - However, a rope at the 1 N pretension stretches only about 0.15 mm, so a payout error above that leaves it **slack**. This happened in 58 of 168 single 0.5 mm cases (E = 40 GPa) and in most combined cases. Stability held in every case tested, but the margin is small.
- **Recommendations.**
  1. Close the loop on head angle, for example with an IMU or encoder in the head, at least for the four tip winches; ±0.2 mm on rope length through guides is unlikely in open loop once friction and creep are included.
  2. Test a higher pretension (3–5 N) to keep ropes taut under winch error. This trades a few newtons of peak force for robustness and has not been simulated yet.
  3. Use winches with encoder resolution well below 0.1 mm. For a 10 mm drum radius, 0.1 mm is 0.6° of drum rotation.
- **Not covered:** friction and stick-slip in the guides, winch dynamics, rope creep and temperature, NiTi hysteresis, and the 1 m free-rope assumption (a shorter rope is stiffer, which reduces the slack problem).

## 10. Round-trip cycle with 3 N pretension and a stable startup (2026-11-11)

This repeats the 11 November length-controlled round trip (`length_cycle.py`; straighten, insert, sweep right and back, sweep left and back, withdraw) with **the same model parameters** (`model_data/MODEL_DATA.md`; continuous 96 mm modules, full-length 1.8 mm rod, E = 40 GPa, 500 g head, 1 m free rope). Only the rope-length commands change:

- **Pretension floor of 3 N on every rope** in the reference poses (`min_force_sweep.py --pretension 3 --seed-startup ...`), instead of 1 N.
- **Stable startup** (`startup_sweep.py`), instead of paying out the upper ropes 10 mm and reeling in. The front starts in natural sag with every rope at 3 N (head at −57°). The head is then raised in 2.5° steps to 20° through held states with all ropes ≥ 3 N. All 32 states are stable at 8 cells (minimum eigenvalue 0.685; peak rope 17.4 N).
- The yaw sweep starts from the startup's end state, so the two connect.

The acceptance checks are unchanged (rope 0.95–250 N, stable, clearance ≥ 5 mm after a 1.5 mm allowance, yaw error ≤ 1°, elevation 20 ± 5°), and so are the five sensitivity cases. Results are in `length_cycle_results_pre3/` (report: [`REPORT.md`](length_cycle_results_pre3/REPORT.md)).

| Case (identical open-loop commands) | 11 Nov: 1 N, 10 mm payout start | **3 N, stable startup** | Remaining failure type |
|---|---|---|---|
| Nominal | 56 of 1,033 fail (13 unstable, tension) | **0 of 1,069 fail**; 0–175° both sides | — |
| Rope EA −20% | all fail (tension, unstable) | **0 of 1,071 fail** | — |
| Free rope 1.5 m | all fail | 543 of 1,070 fail | rope tension 0.77–0.95 N, mainly insertion and withdrawal |
| Rod E = 75 GPa | all fail | 318 of 1,063 fail; clean to ±32.5° | yaw > 1°, elevation > 5° only |
| Head 550 g | all fail | 262 of 1,067 fail; clean to ±78° | yaw > 1°, elevation > 5° only |

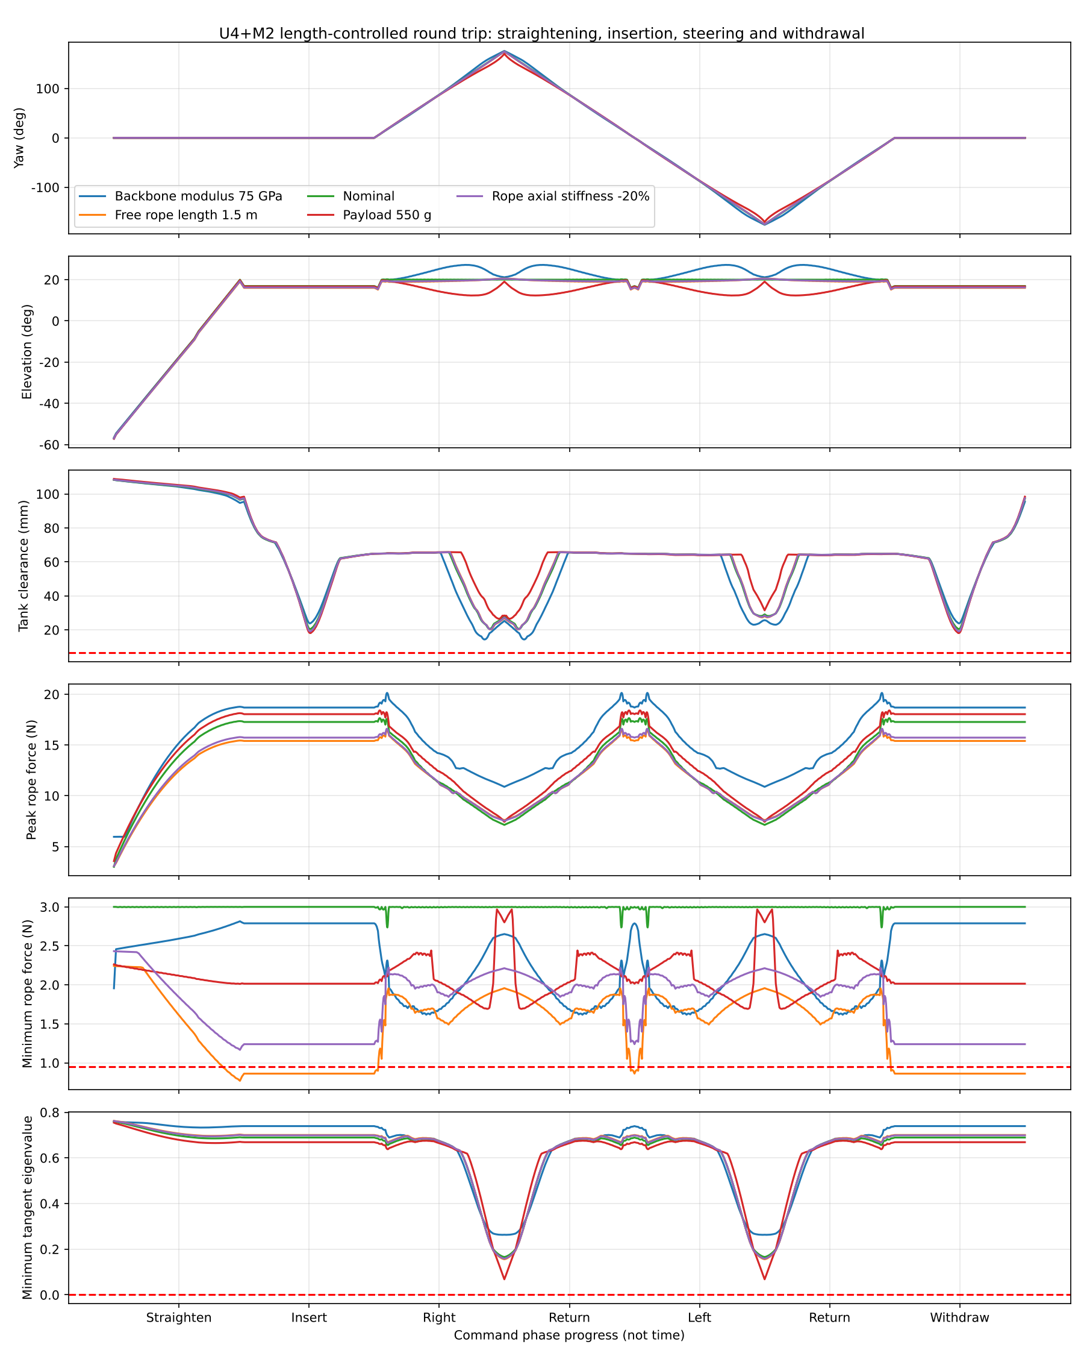
[picture p8: simulations/u4m2/backbone_20261108/length_cycle_results_pre3/cycle_comparison.png]
Cycle comparison, 3 N


- **Nominal cycle passes every check.**
  - Rope tension stays ≥ 2.74 N with a 17.6 N peak.
  - Minimum stability eigenvalue is 0.166, and tank clearance is ≥ 20.5 mm (19.0 mm after the allowance).
  - Yaw error is ≤ 0.24°, and the head returns to its start within 0.0001 mm.
- **No unstable state and no rope below 0.95 N** occurs in four of the five cases. The startup and stability problems of 11 November are removed.
- **What remains is open-loop calibration.**
  - A stiffer rod or heavier head moves the head off target (6.3° / 9.0° yaw at worst).
  - A longer free rope gives less tension for the same commands.
  - These need head-angle and rope-tension feedback, or commands recalibrated to the measured parameters, not more pretension.
- **More pretension is not automatically better.** With a 5 N floor (`length_cycle_results_pre5/`), the nominal cycle has 48 failures. All of them are between 51.9° and 53.9° yaw, where the 5 N pose sequence re-allocates 13.4 N between the 50° and 55° poses; linear length interpolation cannot follow that. The 3 N sequence changes at most 5.8 N between poses. The 5 N case could be fixed with finer pose spacing, but 3 N already passes, so **3 N is the recommended floor**.
- **Known imperfection.** During insertion and withdrawal the head sits at about 17°, not 20°. The 0° pose of the 3 N sweep was accepted on the 8-cell mesh within the ±5° band. This produces the 3.9° maximum elevation error in the nominal case, which is within the acceptance limit. Requiring exact elevation at 8 cells, as `startup_sweep.py` now does, would remove it.

Reproduction:

```bash
python startup_sweep.py --pretension 3
python min_force_sweep.py --exact --step 5 --smooth 1 --pretension 3 --variant niti18_E40 --pitch 20 --anchors 4 5 6 --seed-startup results/startup_niti18_E40_p20_pre3_states.npz
python length_cycle.py --source results/minforce_niti18_E40_p20_a456_pre3_exact_smooth1_fromstartup_states.npz --startup results/startup_niti18_E40_p20_pre3_states.npz --out length_cycle_results_pre3
python summarize_cycle_run.py length_cycle_results_pre3 --source results/minforce_niti18_E40_p20_a456_pre3_exact_smooth1_fromstartup_states.npz --startup results/startup_niti18_E40_p20_pre3_states.npz --pretension 3
```

## 11. Output-feedback round-trip study

The [closed-loop report](closed_loop_results/REPORT.md) compares open-loop replay
with nominal-model output feedback on the same 1,069 reference samples.
The controller uses ideal simulated head-angle and 12-rope tension measurements; plant
stiffness, payload and rope-response perturbations are not used in its gains.

All five cases complete 1,069 reference samples with zero failed settled-state
checks at the 1-degree angle tolerance. The worst settled angle error is 0.699
degrees (550 g payload); all other cases stay below 0.2 degrees. Output-based
step damping resolves the large-yaw failure of the initial undamped controller.
Some arrival states still fall below 0.95 N (minimum 0.568 N), and the corrected
path needs refinement to satisfy the earlier 5 mm displacement sampling bound.
These results do not establish a passing complete control sequence.

- `closed_loop_cycle.py`: nominal gain preparation and forward-solved feedback cycles.
- `render_closed_loop.py`: English comparison report, plots, MP4 and GIF animations.
- `test_closed_loop.py`: sensitivity, command-bound and solver-consistency checks.
- `validate_closed_loop_results.py`: exported-data and numerical-contract checks.

The exploratory feedback target is 1.5 N, below the preceding 3 N feedforward
pretension floor; maintaining a 3 N operating floor is not established here.

Reference and settled-state checks are reported separately from every applied
feedback correction. Animations show paired settled states, not physical
transients. This remains a quasi-static ideal-sensing study; it does not validate
sensor noise, latency, motor dynamics or continuous swept-volume safety.

## 12. Closed-loop round trip v2: operating pretension and refined path (`closed_loop_v2.py`, 2026-11-12)

This addresses the two open items of section 11: tension during command transitions, and node movement above the 5 mm sampling bound. It uses the **same model, reference cycle (3 N stable startup), nominal gains and five plant cases**. The controller still observes only head yaw/elevation and the 12 rope tensions, and plant parameters are not used. Only the control sequence changes:

1. **Operating tension.** The correction keeps every predicted rope tension at or above **3 N** (was 1.5 N). A sample is settled at an angle error ≤ 0.2° **and** a measured minimum tension ≥ **2.5 N**.
2. **Tension-aware arrival.** Before each new feedforward command, tensions are predicted from the **measured** tensions and the nominal tension gains. If any would fall below 3 N, a pre-correction (≤ 0.5 mm per rope, within the 5 mm offset budget) is added that disturbs the head angles as little as possible.
3. **Refined path.** Every transition, including feedforward command changes with clamp travel and every correction, is applied in sub-steps of ≤ 0.25 mm of rope. Each sub-step is halved until no centreline node moves more than **4.5 mm**. Every intermediate state is solved from the previous one and checked (stability, tension, geometry, strain, 3D tank clearance) and recorded, 3,600–4,100 states per case.

Intermediate states are checked against the angle target interpolated along the move, so commanded progress is not counted as error. The pre-control sag at the very start (before the first correction) is reported separately.

| Case | v1: min tension / states < 0.95 N / states < 2.5 N | **v2** | Largest node move v1 → v2 | Settled angle error v1 → v2 | v2 unstable | v2 min tank clearance | v2 peak tension | v2 max offset |
|---|---|---|---|---|---:|---:|---:|---:|
| Nominal | 0.93 N / 1 / 1577 of 1709 | **2.73 N / 0 / 0 of 3604** | 5.25 → **2.74** mm | 0.200° → **0.199°** | 0 | 21.7 mm | 27.1 N | 2.89 mm |
| Rod E 75 GPa | 0.57 N / 3 / 1321 of 1941 | **2.62 N / 0 / 0 of 3840** | 5.45 → **2.50** mm | 0.200° → **0.199°** | 0 | 19.7 mm | 27.3 N | 3.39 mm |
| Head 550 g | 0.84 N / 1 / 1896 of 2465 | **2.76 N / 0 / 0 of 4093** | 6.82 → **4.49** mm | 0.699° → **0.200°** | 0 | 20.7 mm | 27.1 N | 3.74 mm |
| Free rope 1.5 m | 0.91 N / 2 / 1493 of 1775 | **2.72 N / 0 / 0 of 3628** | 5.09 → **2.50** mm | 0.199° → **0.200°** | 0 | 22.3 mm | 25.1 N | 3.62 mm |
| Rope EA −20% | 0.96 N / 0 / 1493 of 1772 | **2.73 N / 0 / 0 of 3627** | 5.20 → **2.62** mm | 0.200° → **0.200°** | 0 | 21.9 mm | 26.3 N | 3.66 mm |

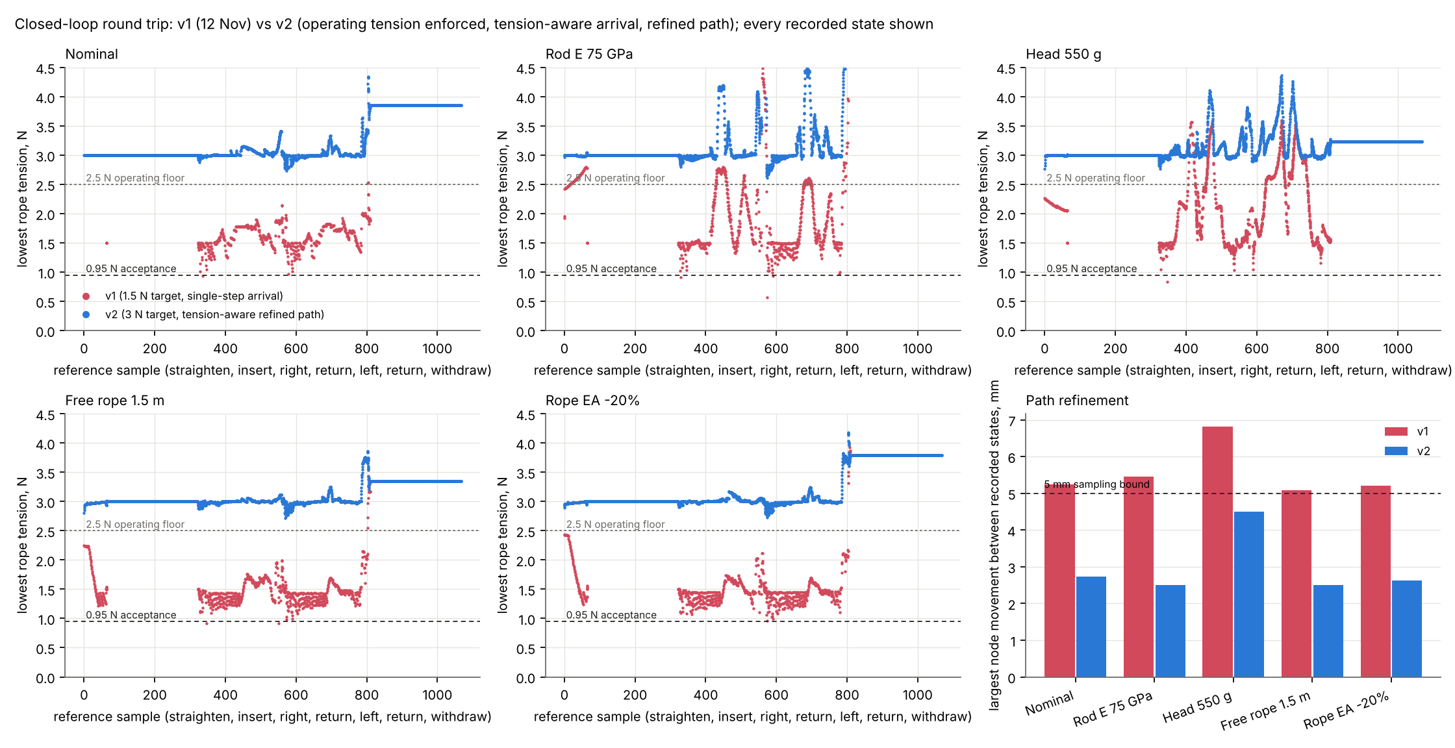
[picture p9: simulations/u4m2/backbone_20261108/closed_loop_v2_results/v1_v2_comparison.png]
v1 vs v2


- **Operating pretension is now held throughout the control sequence.**
  - Every recorded state of every case, including arrivals, intermediate sub-steps and corrections, stays at **≥ 2.62 N**.
  - In v1, 1,321–1,896 recorded states per case were below 2.5 N, and 0–3 arrivals were below 0.95 N (minimum 0.57 N).
- **The path is refined below the sampling bound.** The largest node movement between recorded states is 2.5–4.5 mm (v1: 5.1–6.8 mm).
- **No unstable state, and no geometry, strain or tank-clearance failure,** in any recorded state of any case. Every sample settles within 0.2° and at ≥ 2.5 N, including the 550 g head (v1: one sample at 0.70°).
- **Cost.** Peak rope tension is 25–27 N (v1: up to about 20 N), and the accumulated correction reaches 2.9–3.7 mm of the 5 mm budget.
- **What still fails a check: temporary angle error during motion only.**
  - **All cases:** 5–6 states at the straighten-to-insertion hand-off (sample 64, up to 3.3°). The 3 N reference holds about 17° during insertion while the target is 20° (known imperfection, section 10), so the controller corrects about 3° there.
  - **550 g head:** 83 states during steering at 155–175° yaw (up to 2.85°), where each new command arrives off target before the correction catches up.
  - Nominal steering stays within 1.03° during motion.
  - These states pass every tension, stability and clearance check; the settled samples all pass.
- **Not covered:** quasi-static (no motor dynamics, sensing noise or delay, friction, backlash, hysteresis). Results for the five cases are not an independent validation set. Positive static stiffness does not establish dynamic closed-loop stability.

Results: `closed_loop_v2_results/` (per-sample JSON/CSV, full trace of every recorded state, summaries, states, `comparison_v1_v2.json`). Tests: `test_closed_loop_v2.py` (QP tension and bounds, infeasibility reporting, arrival pre-correction, path subdivision).

```bash
python closed_loop_v2.py --case nominal     # also E75, payload550g, free1500mm, ropeEA80pct (about 20-25 min each)
python summarize_closed_loop_v2.py
python -m unittest test_closed_loop_v2.py -v
```

## 13. Exact 20° reference and correction during moves (closed loop v3, 2026-11-12)

This follows up the two remaining items of section 12.

**1. Exact 20° reference.**

- The 0° and 5° poses of the 3 N yaw sweep had been accepted on the 8-cell mesh at 16.9° and 16.1°: the acceptance allowed ±5°, and the same-tension re-solve had sagged.
- `min_force_sweep.py --elev-tol 1` now requires the 8-cell elevation to be within 1° of 20°, forcing an 8-cell re-optimisation. All 36 poses (0–175°) are now at 20.0°.
- The open-loop reference cycle was rebuilt from them (`length_cycle_results_pre3_tol1/`). The nominal case passes all 1,072 samples, and the largest elevation error falls from 3.93° to 0.18°.
- The nominal gains were recomputed for this reference (`closed_loop_v2.py --prepare-gains`).

**2. Correction during moves** (`closed_loop_v2.py --mid-tol 0.5`).

- After each feedforward sub-step, if the head is more than 0.5° from the target interpolated along the move, up to 4 corrections are applied before the next sub-step.
- A correction is kept only if the measured error decreases; otherwise the rope lengths are returned and correction stops for that move.
- The first version without this guard oscillated at 159–175° yaw with the 550 g head (872 states above 1°, up to 6.8°). It is kept in `closed_loop_v3_results/first_attempt_no_revert/`.

**Results** (every recorded state; states above 1° during motion / largest angle error during motion):

| Case | v2 | **v3** | Lowest tension v2 → v3 | Peak tension v2 → v3 | Accumulated correction v2 → v3 | v3 largest node move |
|---|---|---|---|---|---|---:|
| Nominal | 5 / 3.08° | **0 / 0.18°** | 2.73 → 2.98 N | 27.1 → 17.7 N | 2.89 → 0.05 mm | 2.50 mm |
| Rod E 75 GPa | 6 / 3.18° | **0 / 0.61°** | 2.62 → 2.92 N | 27.3 → 22.5 N | 3.39 → 3.00 mm | 2.50 mm |
| Head 550 g | 87 / 3.01° | **202 / 3.79°** | 2.76 → 2.76 N | 27.1 → 23.7 N | 3.74 → 3.26 mm | 4.49 mm |
| Free rope 1.5 m | 6 / 3.26° | **0 / 0.25°** | 2.72 → 2.81 N | 25.1 → 18.0 N | 3.62 → 0.90 mm | 2.50 mm |
| Rope EA −20% | 6 / 3.10° | **0 / 0.28°** | 2.73 → 2.89 N | 26.3 → 17.9 N | 3.66 → 0.72 mm | 2.50 mm |

| Head 550 g, three versions | States above 1° during motion | Largest |
|---|---:|---:|
| v2 (old reference) | 87 | 3.01° |
| v3: fixed reference only (`closed_loop_v3_results/fixed_reference_only/`) | 115 | 3.13° |
| v3: fixed reference + guarded correction during moves | 202 | 3.79° |

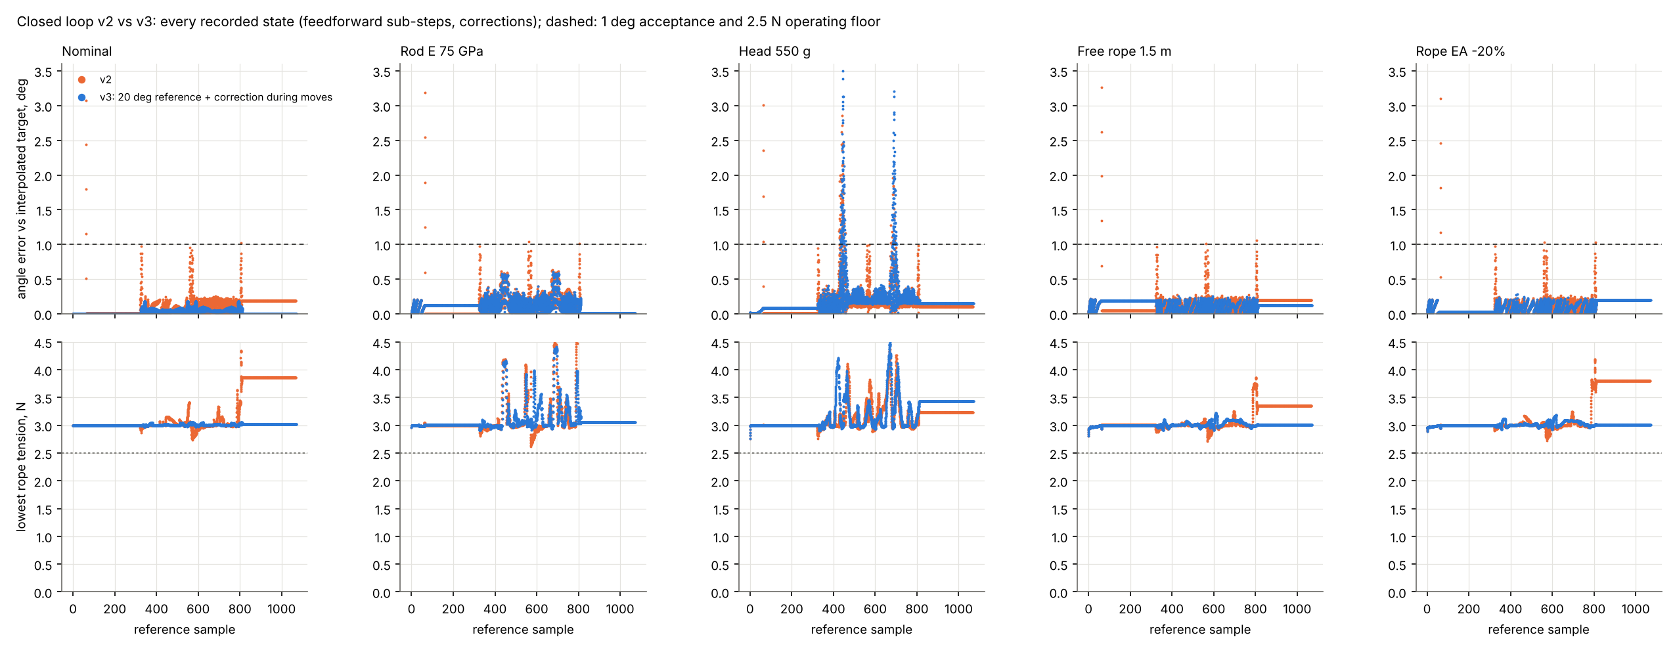
[picture p10: simulations/u4m2/backbone_20261108/closed_loop_v3_results/v2_v3_comparison.png]
v2 vs v3


- **The exact 20° reference fixes four of the five cases completely.** Nominal, 75 GPa rod, 1.5 m free rope and rope EA −20% pass **every check in every recorded state**:
  - angle error during motion ≤ 0.18–0.61°;
  - rope tension ≥ 2.81 N;
  - node move ≤ 2.5 mm per step;
  - no unstable, geometry, strain or clearance failure.

  Because the controller no longer fights a wrong reference, peak rope tension falls from 25–27 N to 17.7–22.5 N, and the accumulated correction from 2.9–3.7 mm to 0.05–3.0 mm.
- **The 550 g head still has temporary angle error at 155–175° yaw** (87–202 states above 1°, up to 3.1–3.8°), whichever version is used. Every one of these states passes the tension, stability, geometry and clearance checks, and every sample settles within 0.2°.
  - The cause is that the nominal gains have the wrong sign in this region for the heavier head: a correction sized for a 0.2° error moves the head about 1° the other way.
  - Correcting more often does not help, so **correction during moves is not recommended**. The fixed reference without it is the preferred configuration.
- **Suggested next step:** update the controller gains online from measured responses (compare the measured head-angle change after each command with the predicted change, for example with a Broyden rank-one update). This uses only measured data and targets the large-yaw, off-nominal-payload region.

```bash
python min_force_sweep.py --exact --step 5 --smooth 1 --pretension 3 --variant niti18_E40 --pitch 20 --anchors 4 5 6 --seed-startup results/startup_niti18_E40_p20_pre3_states.npz --elev-tol 1
python length_cycle.py --cases nominal --source results/minforce_niti18_E40_p20_a456_pre3_exact_smooth1_fromstartup_tol1_states.npz --startup results/startup_niti18_E40_p20_pre3_states.npz --out length_cycle_results_pre3_tol1
python closed_loop_v2.py --case nominal --prepare-gains --ref length_cycle_results_pre3_tol1 --out closed_loop_v3_results
python closed_loop_v2.py --case nominal --ref length_cycle_results_pre3_tol1 --gains closed_loop_v3_results/nominal_gains.npz --out <folder>   # add --mid-tol 0.5 for correction during moves
python summarize_closed_loop_v2.py v3
```

## 14. Separate rope lanes — moved

The rope-lane study (13 November 2026) now has its own folder: [`../lanes_20261113/`](../lanes_20261113/README.md). It reuses the scripts in this folder unchanged.

## Conclusions

1. A Ø1.8 mm NiTi backbone in M resolves both blocking problems for **U4+M2** in the simulation: straightening within the strain limit, and loaded head recovery at the working elevation. This holds at 15–25° and for both moduli. The straight low-strain shape also passes the front-only tank entry screen at 15–25° (2026-11-09).
2. **U4+M2 remains the only viable length** with three or fewer anchor sets. Longer fronts would need more anchor sets inside M, or a stiffer M again.
3. **Every rope needs at least about 1 N pretension** for 3D lateral stability (section 4). With that, holding the head near 20° while sweeping yaw needs only about 7–15 N peak tendon force (section 5).
4. With separate rope lanes ([`../lanes_20261113`](../lanes_20261113/README.md)) everything still passes, at about 1 N lower peak tension. However, the M5 rope chords exceed the strip clearance beyond about 15° yaw unless the M modules get intermediate rope guides.
5. The conclusions now depend on the rod's real EI, its end attachment and its buckling between guides. Run the physical tests in `M_BACKBONE_TEST_PLAN.md` before any further simulation refinement.

## Limitations

- Linear-elastic constant EA and EI.
- Frictionless tendons.
- No contact, NiTi hysteresis or fatigue.
- Local optimization only.
- Free-space steering with no tank geometry.
- The rod is assumed perfectly bonded and guided.

The 5% strain value, 250 N bound and 180° cap are numerical diagnostics, not hardware ratings.

## Reproduction

The commands below take about 10 minutes in total on 4 cores.

```bash
python backbone_planar.py --u 4 --m 2
python backbone_planar.py --u 6 --m 3
python backbone_planar.py --u 8 --m 4
python backbone_planar.py --u 6 --m 3 --all-three --pitches 20 --variants niti18_E40 niti18_E75
python backbone_planar.py --u 8 --m 4 --all-three --pitches 20 --variants niti18_E40 niti18_E75
python summarize_planar.py
python backbone_steering.py validate
python backbone_steering.py run --variant niti18_E40 --pitch 20
# repeat for: --variant niti18_E75 --pitch 20 ; --variant none --pitch 20 ; --variant niti18_E40 --pitch 15 / 25
python refine_backbone_steering.py --variant niti18_E40 --pitch 20
# same set; for 15 deg add: --top 4 --maxiter8 150
python plot_backbone.py
python entry_screen.py   # tank entry screen (needs ../results/cad_sections.json)
python plot_entry.py
python pretension_recheck.py
python min_force_sweep.py --exact --step 5 --smooth 1 --variant niti18_E40 --pitch 20 --anchors 4 5 6   # ~10 min; see summarize_minforce.py for all runs
python summarize_minforce.py
python plot_minforce.py
python tank3d_screen.py entry          # needs cadquery-ocp + vtk + trimesh + rtree; builds _cache/ mesh
python tank3d_screen.py sweep --run 0  # runs 0-2; add --depths 0 30 60 for shallower clamp positions
python plot_tank3d.py
python side_pull.py --pull a6               # winch control; --pull a5/a4/all, --variant niti18_E75, --mode tension
python summarize_sidepull.py
python plot_sidepull.py
python coordinated_winch.py --case E40            # also --case E75, --reverse
python coordinated_winch_tank.py --case E40       # 3D tank clearance of in-between states
python coordinated_winch_table.py                 # winch command tables (CSV)
python plot_coordwinch.py
python winch_sensitivity.py --case E40          # also --case E75 --yaws 0 30 60 90 120 150 180
python summarize_winch_sensitivity.py
python plot_winch_sensitivity.py
```
