KevinQianjin/ASRC_snake_body_design/reports/weekly/Weekly_report_2026_11_10.pptx

## A NiTi backbone makes the U4+M2 front work

ASRC fuel tank inspection robot · Simulation results, 6–9 November 2026

Notes: This deck summarises three days of simulation work on the flexible front of the fuel tank inspection robot. The headline: adding a thin NiTi rod down the centre of the soft M modules turns a front that could not hold itself straight into one that straightens, enters the tank and steers at the working angle with small rope forces. Everything shown is simulation; the physical module tests are next.

## One design change fixes both blocking problems

0.1%

axial strain to hold the front straight (was 17%)

180°

yaw with the head held at the 20° working angle (was none)

7–15 N

peak rope force for that sweep, smooth 5° steps

≥ 12.6 mm

clearance to the full 3D tank during the sweep

The change: a 1.8 mm superelastic NiTi rod down the centre of each M module (+1.6 g per module).

Rules that come with it: install at 20°, keep ≥ 1 N on every rope, control rope length (not tension). All results are simulations with calculated rod properties; module tests are next.

Notes: Four numbers summarise the result. Before the change, the front needed 17 percent axial strain to straighten, far beyond the 5 percent diagnostic, and it could not hold the head near the working angle at all. With the rod, straightening needs about 0.1 percent strain; the head can be swept through 180 degrees of yaw while held at 20 degrees; the largest rope force in that sweep is 7 to 15 newtons; and the whole sweep stays at least 12.6 mm clear of the real 3D tank. Three operating rules come with it, which I will explain.

## Concept: a tendon-driven front fed through the tank floor

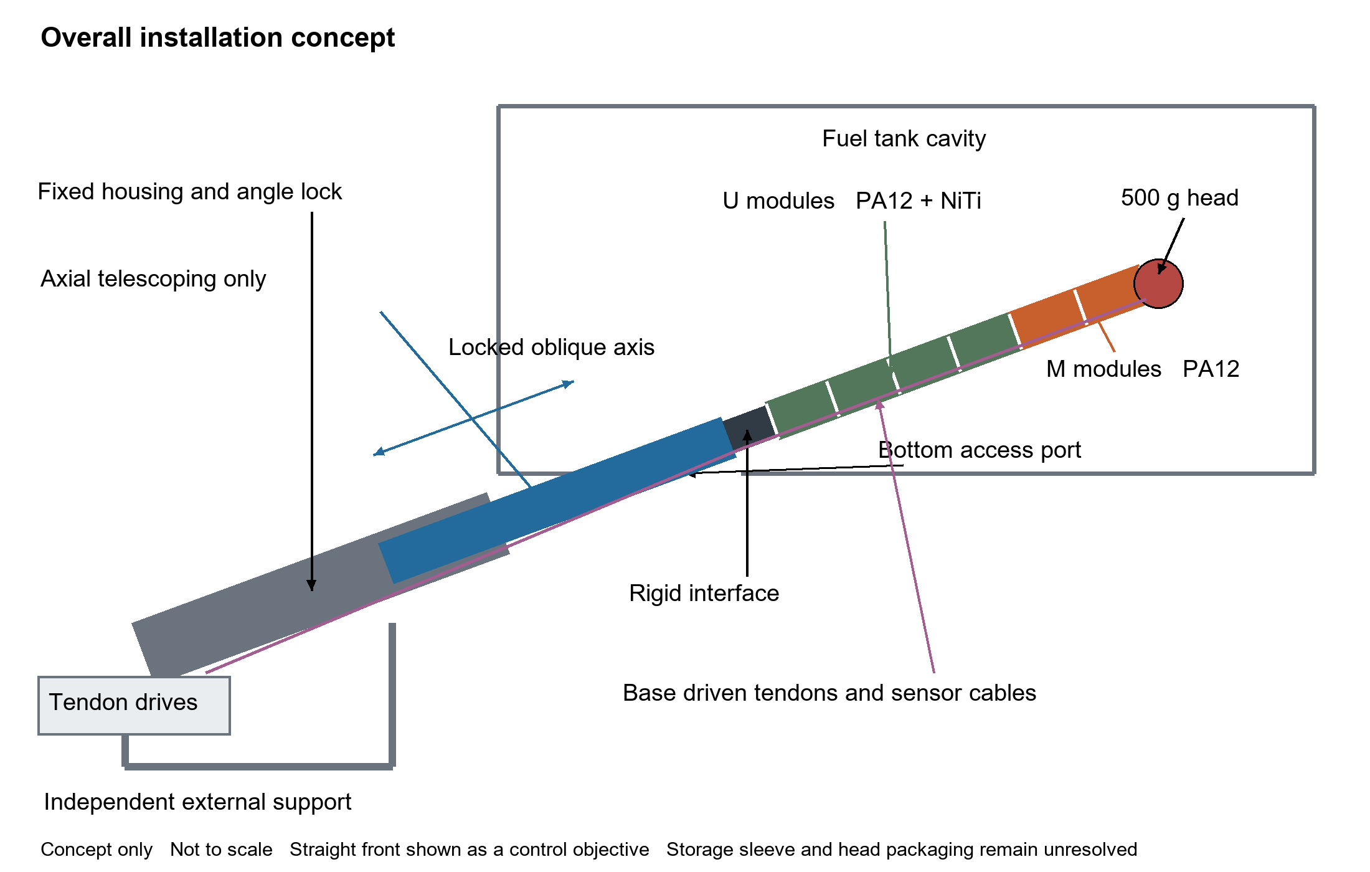
[picture p21: figure]
installation concept

- Targets: 500 g camera + thermography head, ~1.5 m reach, Ø < 100 mm
- Front: U4+M2, Ø63 mm, 96 mm modules
- U modules: PA12 + NiTi, stiff against gravity
- M modules: PA12, compliant for steering
- Actuation: up to 3 anchor sets × 4 ropes, 24 mm from the axis, driven from the base
- Rear: telescopic, axial motion only, locked angle

Notes: The robot is mounted outside the tank on an independent stand. A telescopic rear feeds the flexible front through a bottom access opening along a locked oblique axis. The front is four stiff U modules followed by two compliant M modules, 63 mm diameter, steered by ropes anchored at module ends and driven from the base. The head is a 500 g sensor package.

## 6 November: the front could not hold the head up

17%

axial strain needed to straighten the front; the diagnostic limit is 5%

−66°

head elevation at maximum yaw: the head points down, not at the target

770×

U module axial stiffness relative to M (128,122 N vs 167 N)

Why: ropes that lift the head also compress the M modules. At 5% strain an M module carries only about 8 N, while holding the head up needs about 39 N of rope force. Every lifting rope compress M instead of lifting the head.

Source: Report 6 November 2026, U4+M2 at 20°, 500 g head.

Notes: On 6 November we found two blocking problems. Straightening the front needed 17 percent axial strain, and when steering, the best low-strain pose had the head pointing 66 degrees down. Both trace to one number: the M module is about 770 times softer axially than the U module. Ropes pull along the outside of the modules, so lifting the head also compresses M, and M simply collapses.

## Stiffening M axially alone is not enough

EA EI sweep figure

- Axial stiffness alone straightens the front but leaves a 7° angle error: between anchors, the head weight bends each soft M module.
- First combination that passes: M axial stiffness ×5 (≈ 830 N) and bending stiffness ×1.25 (≈ 0.055 N·m²), anchors at modules 4, 5, 6.

Notes: To find what M actually needs, we scaled only the M module stiffness in the existing solver. Raising axial stiffness alone gets the offset down to 3 mm but leaves a 7 degree angle error that never goes away, because between anchor points the head weight bends the soft M module. A hand calculation gives the same 7 degrees. The first combination that passes every check is five times the axial stiffness plus 25 percent more bending stiffness.

## The fix: a 1.8 mm NiTi rod down the centre of each M module

Property (per M module) | Current M | M + rod, E 40 GPa | M + rod, E 75 GPa | Needed
Axial stiffness EA, N | 167 | 101,954 | 191,018 | ≥ 833
Bending stiffness EI, N·m² | 0.044 | 0.065 | 0.083 | ≥ 0.055
Mass, g | 23.9 | 25.5 | 25.5 | —

E 40–75 GPa brackets the uncertain NiTi phase (martensite to austenite). Values calculated, not measured.

The rod raises axial stiffness about 600× while adding only 50–90% bending stiffness, so M stays steerable.

Guides every 24 mm

Rod buckles at 353 N (40 GPa) vs a 248 N design load

Rod ends carry load

End fittings must pass 250 N into the anchor disks without slip

Small penalty

+1.6 g per module; surface strain 1.5% at a 180° bend

Notes: The proposed implementation is a superelastic NiTi rod of 1.8 mm diameter down the centre of each M module, fixed to the module end disks. It meets both requirements with margin: hundreds of times the needed axial stiffness and 50 to 90 percent more bending stiffness. It needs internal guides every 24 mm to stop it buckling, and the rod end joints become critical parts. A 1.5 mm rod would be marginal at the low modulus.

## Straight at 0.1% strain, and it now enters the tank

entry screen figure

1–2 mm

offset from the straight axis at 15–25°

0.1%

axial strain (current M: 17%)

47 / 65 / 19 mm

entry clearance in full 3D tank at 15 / 20 / 25°

Notes: With the rod, the front holds itself straight with 1 to 2 mm offset at only 0.1 percent strain, at all three installation angles. Fed through the bottom opening, the straight shape now clears the tank; every low-strain shape on 6 November hit the tank. The left plot shows the rod shape at four feed positions in orange and the old shape hitting the tank in blue. The clearances were confirmed against the full 3D tank model.

## Two control rules from the 3D stability checks

Keep ≥ 1 N on every rope

With only the up ropes pulled, the straight front can buckle sideways in 3D; the 2D model could not see this. A 1 N pretension on all ropes makes every case stable, and straightening and entry still pass.

unstable → stable

with 1 N pretension

Control rope length, not tension

With fixed rope tensions the straight front is unstable: adding 0.5 N to one rope makes the head snap 258 mm. With winch (length) control the ropes act as springs and the same pose is stable.

258 mm

snap under tension control

Notes: Two operating rules came out of the 3D checks. First, the straight front with only the up ropes tensioned is laterally unstable in 3D, a mode the 2D model cannot show. One newton of pretension on every rope fixes it. Second, if the drives control rope tension directly, the straight pose is unstable: half a newton on one rope makes the head snap 258 mm. Under winch length control the same pose is stable. So the drives must be position-controlled, or use fast feedback.

## Full yaw at the working angle needs only 7–15 N

7–15 N

peak rope force with anchors at modules 4, 5, 6 (8 Nov allocation: 46–98 N)

- Yaw 0° → 175° in 5° steps, each solved from the previous pose
- Rope changes ≤ 5 N and head moves ≤ 56 mm per step: no jumps
- Up to ~60° the head pans almost horizontally; beyond ~90° the front curls up and over

Notes: Holding the head at exactly 20 degrees while stepping yaw from 0 to 175 degrees needs a largest rope force of only 7 to 15 newtons with anchors at modules 4, 5 and 6. Yesterday's allocations needed 46 to 98 newtons only because they maximised angle without minimising force. Each pose is solved from the previous one; rope tensions change by at most 5 newtons per step and the head moves smoothly. Up to about 60 degrees the head pans nearly horizontally; larger yaw is reached by curling the M section up and over.

## The whole sweep fits inside the real 3D tank

≥ 12.6 mm

clearance on both sides with the clamp 0–30 mm past the opening

- All 362 tank solids meshed from the STEP model (461,524 triangles)
- Deeper clamping lifts the curled front into the tank roof
- 25° installation hits the roof at every depth: use 20°

Notes: We then placed every pose of that sweep inside the full 3D tank model, all 362 solids from the STEP file, and measured the gap to the 63 mm envelope. With the base clamp 0 to 30 mm past the opening, every pose clears by at least 12.6 mm on both sides. Clamping deeper lifts the curled front into the roof, which is the only limiting surface. At 25 degrees installation the sweep hits the roof at every depth, so 20 degrees is the angle to use.

## Side ropes: the tip rope steers, but alone the head droops

side pull figure

1.25°/mm

yaw per mm of tip rope reeled in, smooth and stable

±20°

yaw before the head leaves 20 ± 5° when only one rope moves

≈ 0

useful yaw from anchors 4 and 5 (they just compress the front)

Notes: Here we started from the straight front and reeled in only one right-side rope with a winch. The rope at the tip is the effective actuator: about 1.25 degrees of yaw per millimetre, smooth and stable. But with the other ropes locked, the head droops; it leaves the working band after about 20 degrees. Larger yaw at the working angle needs the up ropes reeled in together, which is exactly what the coordinated sweep on the previous slides does. Ropes at modules 4 and 5 hardly turn the head.

## What is not yet proven

Rod properties

Stiffness, buckling and joint strength are calculated. NiTi phase state, hysteresis and fatigue are not modelled.

Motion between poses

Poses are checked every 5°. States in between and real winch dynamics are not yet simulated.

Head and cables

The 500 g head is a point mass with a 63 mm envelope. Real head CAD and cable routing are missing.

Twist and friction

Mid-range yaw uses 30–55° of twist along the front. Rope friction is not modelled.

Notes: To be clear about the evidence: everything is simulation with calculated rod properties. We have checked poses every 5 degrees but not the transitions or the winch dynamics. The head is a point mass with a provisional envelope, and mid-range yaw relies on 30 to 55 degrees of twist that hardware must confirm.

## Decisions and next steps

Decisions

- Develop U4+M2 with a 1.8 mm NiTi rod in each M module
- Install at 20°; steer with the clamp 0–30 mm past the opening
- Keep ≥ 1 N on every rope; drive ropes by length (winch position)
- Longer fronts (U6+M3, U8+M4) are not viable with ≤ 3 anchor sets

1

Build and test the rod M module

stiffness, buckling, joint slip

2

Coordinated winch-control test

smooth 0–175° at 20° between poses

3

Tank-aware steering, twist limits

optimise poses with the tank as a constraint

4

Head CAD, entry, storage, rear

then integrated validation

Notes: We propose to adopt the NiTi rod design for U4+M2, install at 20 degrees, keep pretension on every rope and use length-controlled winches. Longer fronts are off the table for now. The physical rod module tests are the gate: if measured bending stiffness falls short, the fallback is a 2 mm rod or closer guides. In parallel we will simulate the coordinated winch motion between poses and add the tank as a constraint on steering.
