KevinQianjin/ASRC_snake_body_design/ASRC_kevin/four_rope_inverse_5_to_11/METHODS.md

四繩計算方法

本程式計算垂直對稱平面的幾何非線性靜力，根部位置與方向固定。模組長48 mm，模組類型的順序固定為high、uni-d、directional、low；前兩類有鋼芯，後兩類無鋼芯。模組的EI、EA與質量直接讀取inputs/craft_data.py，不作全PLA或尺寸換算。

單元未知量為端點絕對轉角及軸向應變。中心線滿足 r′=(1+ε)[cosθ,sinθ]，每單元以4點Gauss積分。總勢能為彎曲能、軸向能、均布自重位能，以及ΣTᵢLᵢ。對所有自由度取一階導數為零，聯立頭尾同高或前端轉角條件，解出形狀及上下繩張力差。沒有加入使圓弧保持形狀的支撐反力。

導孔只設在真實模組端盤，沿機身的間隔為48 mm。端盤相對中心偏移半徑13 mm，各繩在相鄰導孔間沿直線行進；增加有限元網格不會增加導孔。無摩擦時同一根繩全長張力相同。零張力繩可鬆弛；繩索自重依原長均勻轉移到機身，不模擬鬆繩懸鏈線。

在垂直對稱平面，使用三個控制參數：上下張力差D、上下共同張力A≥0、左右共同張力S≥0。按上／右／下／左順序，T=[max(D,0)+A/2,S/2,max(-D,0)+A/2,S/2]。實際直線繩段的上下共同模式與左右共同模式不假定等價。主要掃描先搜尋A=0分支；check_opposing_pairs.py再對全部配置補查A>0及A、S共同作用。這是有限範圍內找到的最低值，沒有完整三維或所有分支的全域最小證明。

主要掃描採每節4單元，選定狀態再加密至每節8單元；對拉補查及相鄰配置延續在每節8單元進行。主要網格與搜尋上限見results/run_settings.json，上下對拉網格見check_opposing_pairs.py。數值應變及張力上限是搜尋界限，不是實物承載額定值。

頭尾同高只要求末端高度為0及側向偏移為0，不要求整機水平或頭部朝向水平。半圓則還要求前端相對轉角±180°及中心線最大圓弧偏差≤1 mm。圓弧從實際後段／前段界面出發，使用該處實際切線；半徑是變形後前端中心線長度除以π。沿變形後弧長比例比較相同進度的中心線點。僅滿足180°轉角的狀態存作診斷，不能視作成功半圓。

張力轉換為一組繩長指令：受拉繩原長L₀=L/(1+T/EA)。零張力繩另放出1 mm，這只是非唯一的鬆繩指令。固定繩長的局部平面穩定性，使用幾何剛度加受拉繩EA/L₀乘繩長雅可比外積，檢查最小縮放特徵值。未驗證扭轉、平面外失穩與實際控制系統穩定性。

鋼芯參考應力包含軸向及彎曲，並由端盤處的遠端重量與切斷繩索力矩平衡回復截面作用力，避免以第一單元平均曲率低估根部應力。205 MPa僅為既有材料目錄參考值。模組使用線性EA，超過5%應變另設旗標；5%不是論文給出的失效界限。尼龍EA與線密度來自既有PA6實心材料代理值，仍需實際繩索量測。

驗證包括非零四繩張力下的能量梯度與Hessian、頭部雅可比、導孔與繩索虛功、零繩索極限對原自重程式、原論文參數與後段鋼芯質量、繩長回代，以及最終全部保存狀態的平衡殘差核對。H8/U12代表狀態另由8加密至16單元／節。最終檢查保存在results/final_numerical_audit.json。

有限元／幾何非線性建模方法參考：[Li等（2022）Geometrically Exact Finite Element Formulation for Tendon-Driven Continuum Robots](https://yuan.mae.sustech.edu.cn/pdf/2022Li-acta-mechanics.pdf)。本程式為獨立的平面實作，沒有宣稱重現該文完整三維模型。
