KevinQianjin/ASRC_snake_body_design/cad/simulation_reference/u4m2_500g/nominal_reference.png

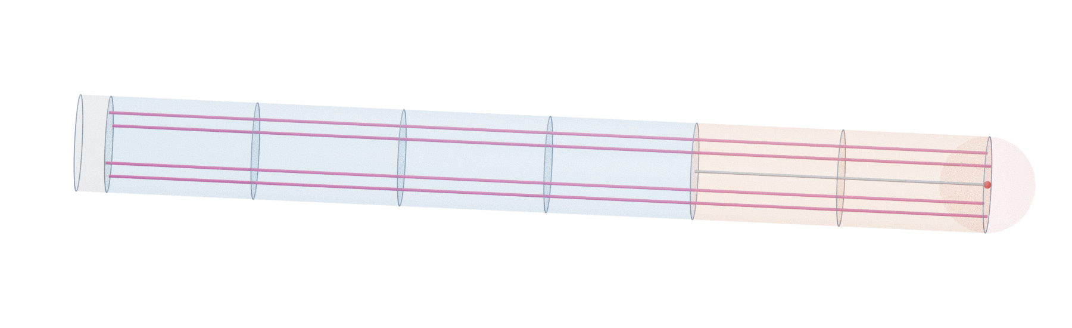
cad/simulation_reference/u4m2_500g/nominal_reference.png
