KevinQianjin/ASRC_snake_body_design/cad/simulation_reference/u4m2_500g/simulation_reference.png

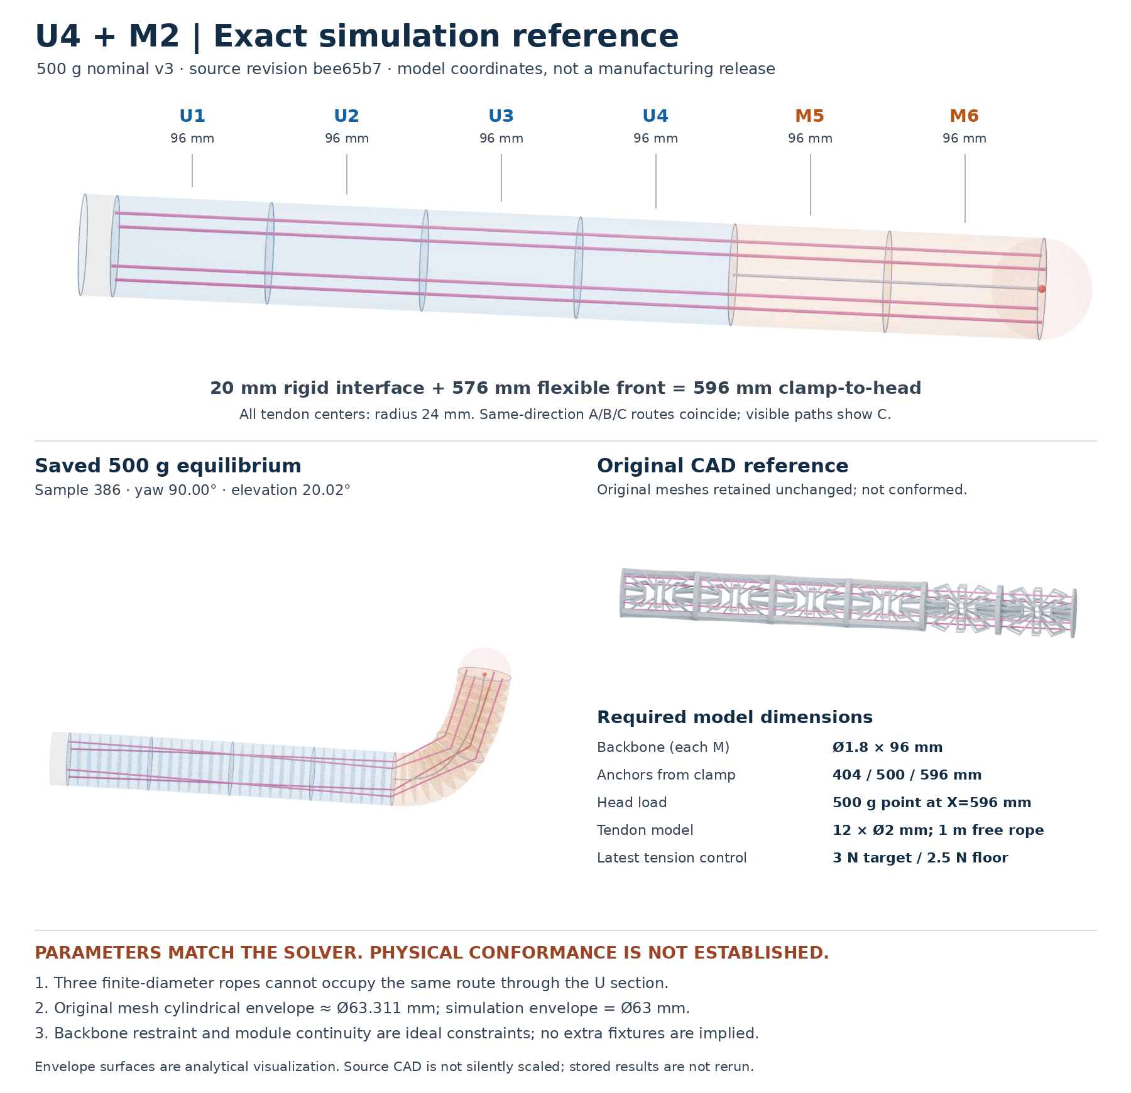
cad/simulation_reference/u4m2_500g/simulation_reference.png
