KevinQianjin/ASRC_snake_body_design/cad/tank/reference_images/tank-access-plan.png

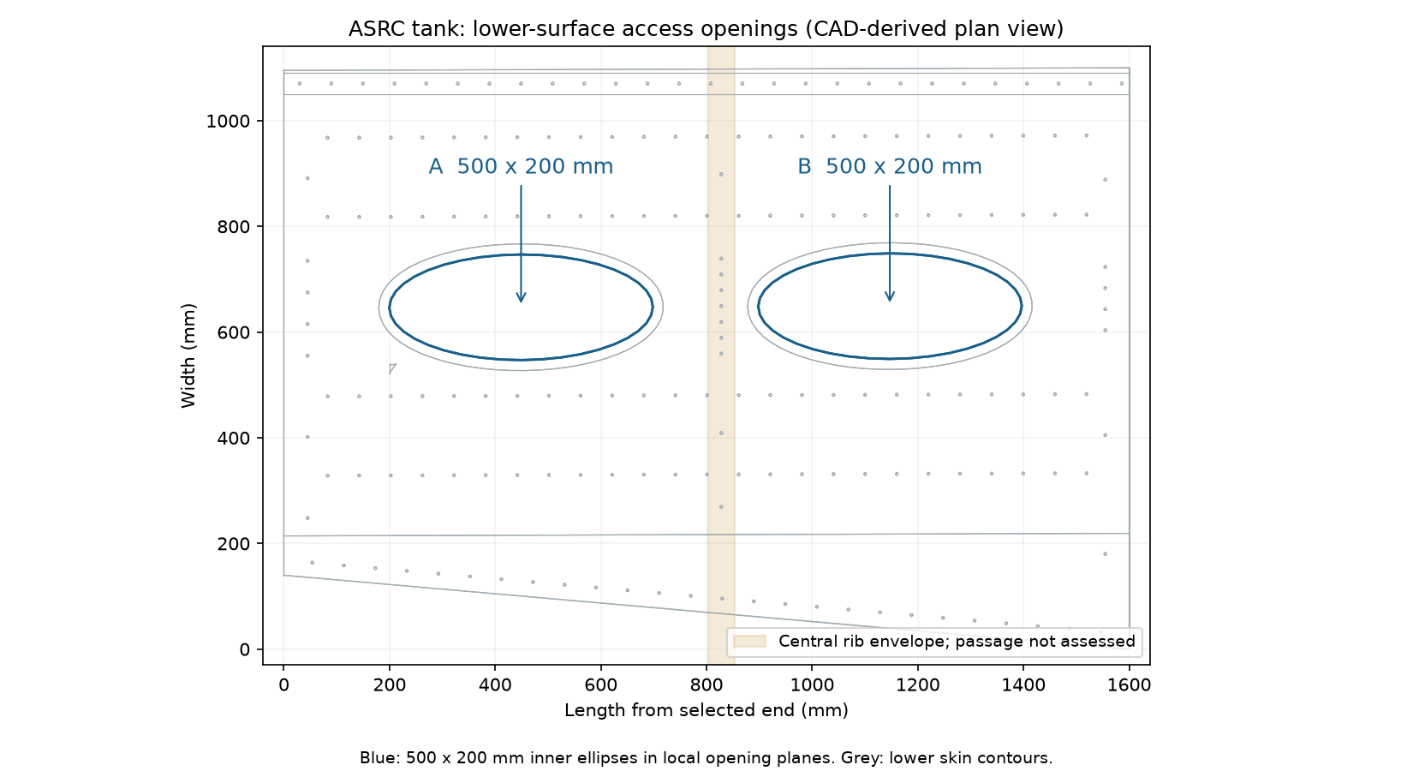
cad/tank/reference_images/tank-access-plan.png
