KevinQianjin/ASRC_snake_body_design/cad/tank/reference_images/tank-cad-views.png

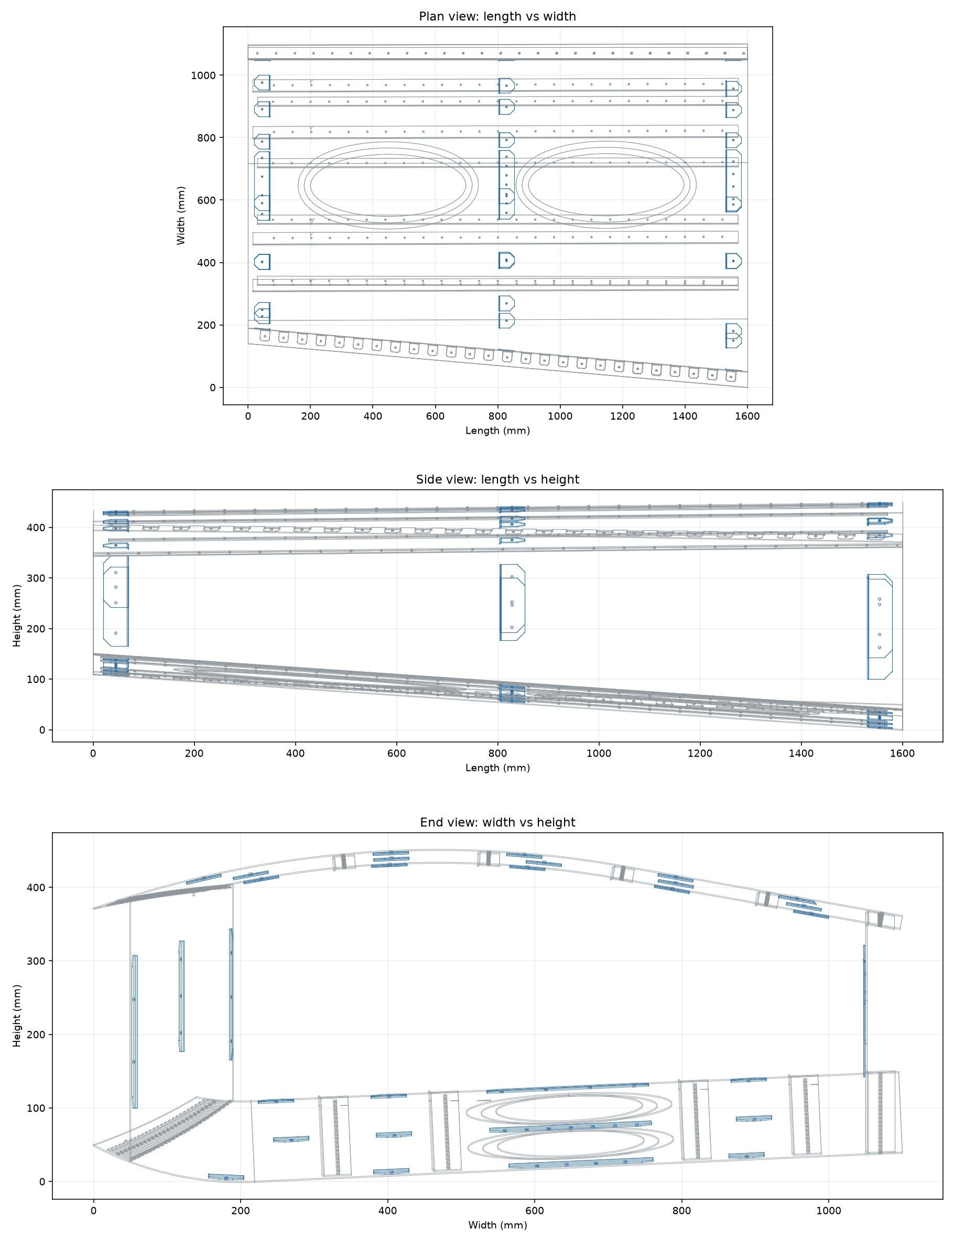
cad/tank/reference_images/tank-cad-views.png
