KevinQianjin/ASRC_snake_body_design/cad/tank/reference_images/tank-entry-details.png

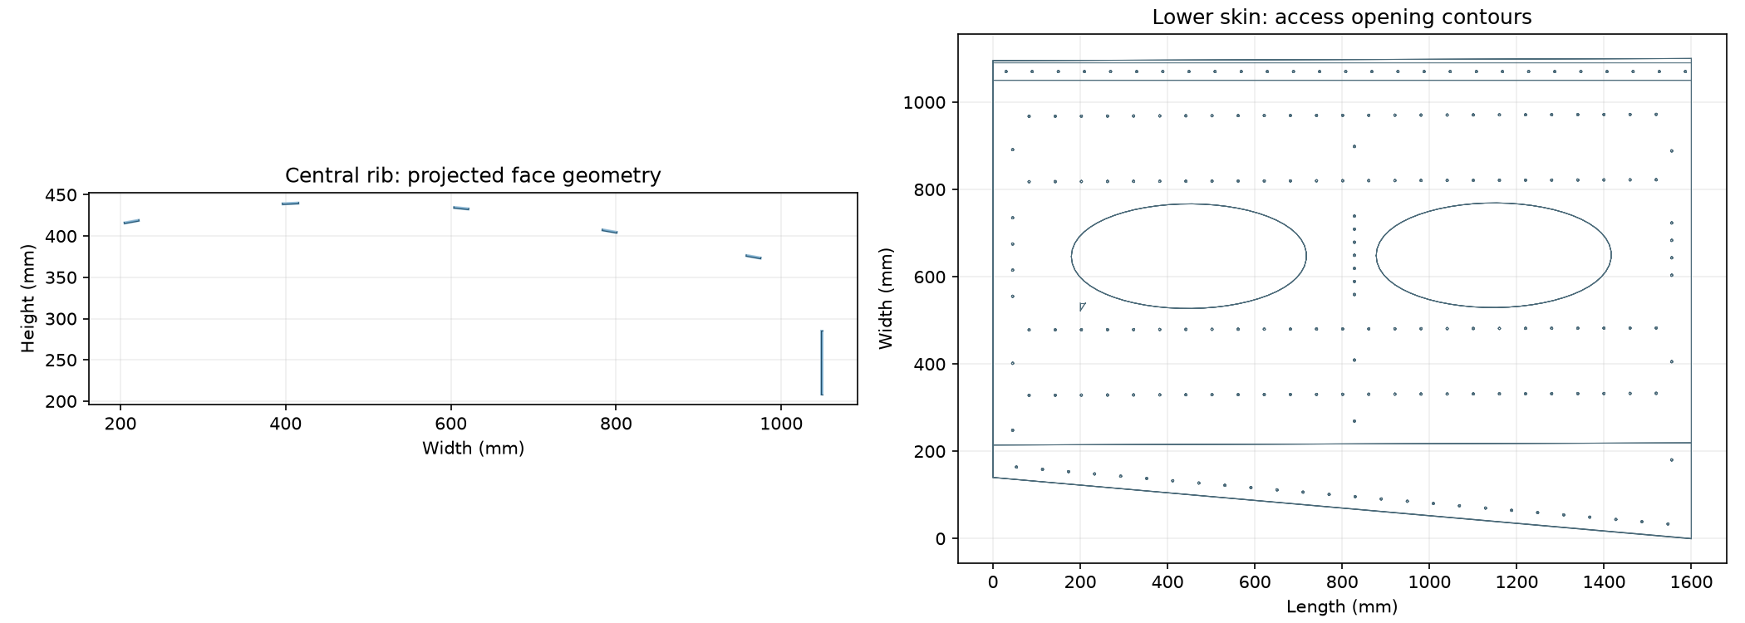
cad/tank/reference_images/tank-entry-details.png
