KevinQianjin/ASRC_snake_body_design/reach_extension_results/reference_stack_candidates.csv

combination | n_high | n_uni | n_directional | n_low | rear_modules | front_modules | total_modules | rear_length_mm | front_length_mm | total_length_mm | module_mass_g | backbone_mass_g | total_mass_g | tip_drop_mm | tip_x_mm | converged | residual_nm | module_data_mode | cells_per_module | front_compliance_gravity_deg_per_nmm | rear_compliance_gravity_deg_per_nmm | front_compliance_zero_g_deg_per_nmm | rear_compliance_zero_g_deg_per_nmm | rear_interface_angle_deg | rear_drop_mm | front_relative_angle_deg | root_reaction_moment_nm | max_core_stress_mpa | core_reference_yield_ratio | passes_reference_yield_screen | capsule_horizontal_span_mm | capsule_vertical_span_mm | capsule_width_mm | passes_empty_box_envelope_screen | passes_combined_screen | passes_reach_target_screen | backbone_diameter_mm | tip_payload_g | total_system_mass_g | envelope_length_mm | envelope_width_mm | envelope_height_mm | tendons_included | reference_front_stack | reference_rear_split | extended_reference_stack
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
H8-U19-D8-L3 | 8 | 19 | 8 | 3 | 27 | 11 | 38 | 1296.0 | 527.9999999999999 | 1823.9999999999998 | 157.70000000000002 | 514.6381155922197 | 672.3381155922198 | 655.2208927523099 | 1320.3922577327394 | True | 3.1731561822567755e-13 | paper_original | 8 | 0.532466954016709 | 2.7257407779921596e-12 | 9.72391229450597 | 0.0018442296653023802 | -9.040392542827403 | 139.3425934085701 | -80.95960734541111 | 10.971685066608373 | 218.1228594754017 | 1.064013948660496 | False | 1352.3922577327392 | 687.2208927523102 | 32.0 | False | False | False | 8.0 | 500.0 | 1172.3381155922198 | 1600.0 | 830.0 | 300.0 | False | True | True | True
