KevinQianjin/ASRC_snake_body_design/ASRC_kevin/rope_results_level/inverse_summary.csv

material | scenario_name | target_mode | search_parameterization | status | target_reached | within_reference_model_range | hardware_limits_calibrated | stop_reason | accepted_control_steps | forward_trial_count | payload_kg | reference_length_mm | target_tip_y_mm | target_tip_z_mm | target_tip_x_mm | target_tolerance_mm | target_angle_tolerance_deg | minimum_tip_x_mm | initial_tip_x_mm | initial_tip_y_mm | tip_x_mm | tip_y_mm | tip_z_mm | forward_ratio | target_error_mm | max_rope_strain_fraction | max_joint_angle_deg | max_centerline_height_mm | max_centerline_transverse_mm | rms_centerline_transverse_mm | max_link_tilt_from_horizontal_deg | tip_tilt_from_horizontal_deg | equilibrium_moment_residual_nm | equilibrium_axial_residual_n | min_stability_eigenvalue | warnings | tension_top_n | take_up_top_mm | tension_right_n | take_up_right_mm | tension_bottom_n | take_up_bottom_mm | tension_left_n | take_up_left_mm
al1100_o | D_tip500g_inverse_level | level_tip | winch_length | target_not_reached | False | False | False | trial budget exhausted | 22 | 400 | 0.5 | 1488.0000000000005 | 0.0 | 0.0 |  | 1.0 |  | 1339.2000000000005 | 190.40227562678862 | -1437.0389725635703 | 198.50676116088414 | -1207.0532225326278 | -2.1240630630368405e-06 | 0.13340508142532534 | 1660.7704679333854 | 0.007471015743926587 | 65.38157970343917 | 1295.7037897931625 | 1295.7037897931625 | 835.7264804082424 | 145.04906323455623 | 145.04906323455623 | 2.551340578804684e-07 | 0.00025338109903763465 | 0.0252490077723677 | large bending per module: refine discretization / verify guide geometry | 77.45393098071237 | 37.99999999999999 | 0.0 | -5.063213490633358 | 24.88925571962915 | -22.86555005423047 | 0.0 | -5.063213490633358
cu110_o60 | D_tip500g_inverse_level | level_tip | winch_length | target_not_reached | False | False | False | trial budget exhausted | 27 | 400 | 0.5 | 1488.0000000000005 | 0.0 | 0.0 |  | 1.0 |  | 1339.2000000000005 | 316.35424221274445 | -1447.2849525875426 | 324.9622904954381 | -1140.0896004287501 | 2.697062147601646e-05 | 0.2183886360856438 | 1525.9365741690738 | 0.012232147764182572 | 66.33713654693331 | 1244.261797498098 | 1244.2617974980985 | 821.5786998086318 | 152.55606879517723 | 152.55606879517723 | 4.5482625610215877e-07 | 0.0006793752499097339 | 0.043246115695502844 | large bending per module: refine discretization / verify guide geometry | 126.81380432681657 | 49.999999999999986 | 0.0 | -4.817308512943103 | 20.564320979311173 | -29.896487625505703 | 0.0 | -4.817308512943103
ss304_annealed | D_tip500g_inverse_level | level_tip | winch_length | target_not_reached | False | False | False | trial budget exhausted | 34 | 400 | 0.5 | 1488.0000000000005 | 0.0 | 0.0 |  | 1.0 |  | 1339.2000000000005 | 596.8466390632993 | -1356.1374013080874 | 751.5244617451469 | -864.7353349756195 | -4.516524763439875e-06 | 0.5050567619255019 | 1045.5284490718216 | 0.024180105241971093 | 49.86410421261107 | 1007.431875219476 | 1007.431875219476 | 681.8405134241806 | 152.71317626284758 | 152.71317626284758 | 3.8547581096559647e-07 | 0.0007594617925605414 | 0.07137882810280168 | rope strain exceeds the configured small-strain screening threshold; large bending per module: refine discretization / verify guide geometry | 250.68133527097459 | 67.99999999999999 | 0.0 | -7.285115236596375 | 10.967501844753635 | -31.468497083218175 | 0.0 | -7.285115236596375
