KevinQianjin/ASRC_snake_body_design/ASRC_kevin/rope_results_target_position/inverse_summary.csv

material | scenario_name | target_mode | search_parameterization | status | target_reached | within_reference_model_range | hardware_limits_calibrated | stop_reason | accepted_control_steps | forward_trial_count | payload_kg | reference_length_mm | target_tip_y_mm | target_tip_z_mm | target_tip_x_mm | target_tolerance_mm | target_angle_tolerance_deg | minimum_tip_x_mm | initial_tip_x_mm | initial_tip_y_mm | tip_x_mm | tip_y_mm | tip_z_mm | forward_ratio | target_error_mm | max_rope_strain_fraction | max_joint_angle_deg | max_centerline_height_mm | max_centerline_transverse_mm | rms_centerline_transverse_mm | max_link_tilt_from_horizontal_deg | tip_tilt_from_horizontal_deg | equilibrium_moment_residual_nm | equilibrium_axial_residual_n | min_stability_eigenvalue | warnings | tension_top_n | take_up_top_mm | tension_right_n | take_up_right_mm | tension_bottom_n | take_up_bottom_mm | tension_left_n | take_up_left_mm
al1100_o | D_tip500g_inverse_target_xyz | tip_position | winch_length | target_not_reached | False | False | False | trial budget exhausted | 18 | 400 | 0.5 | 1488.0000000000005 | 0.0 | 0.0 | 1488.0 | 1.0 |  |  | 190.40227562678862 | -1437.0389725635703 | 212.59692061023742 | -1220.7477462131696 | 2.4642414584911668e-05 | 0.14287427460365412 | 1765.468231037144 | 0.0067220107324954 | 65.01259752927318 | 1304.354922731522 | 1304.3549227315223 | 839.1099443528591 | 128.66548770847436 | 128.66548770847436 | 1.758760082015698e-08 | 1.6151236808213936e-05 | 0.02525559494491447 | large bending per module: refine discretization / verify guide geometry | 69.68880446404566 | 34.0 | 0.0 | -2.0264161193935024 | 11.41027772111359 | -22.026416119393915 | 0.0 | -2.0264161193939048
cu110_o60 | D_tip500g_inverse_target_xyz | tip_position | winch_length | target_not_reached | False | False | False | trial budget exhausted | 23 | 400 | 0.5 | 1488.0000000000005 | 0.0 | 0.0 | 1488.0 | 1.0 |  |  | 316.35424221274445 | -1447.2849525875426 | 340.8484110347385 | -1155.0091259931778 | -2.989767685384757e-06 | 0.22906479236205537 | 1627.8829347324238 | 0.01148687709963139 | 66.47529116985754 | 1260.988531908944 | 1260.988531908944 | 826.2165331062876 | 137.02934150322656 | 137.02934150322656 | 2.6665270957959564e-07 | 0.00025875685707563433 | 0.040601081999832776 | large bending per module: refine discretization / verify guide geometry | 119.08739273933963 | 45.99999999999999 | 0.0 | -1.5754445926958387 | 6.82141314491522 | -28.96892633383218 | 0.0 | -1.5754445926963208
ss304_annealed | D_tip500g_inverse_target_xyz | tip_position | winch_length | target_not_reached | False | False | False | trial budget exhausted | 22 | 400 | 0.5 | 1488.0000000000005 | 0.0 | 0.0 | 1488.0 | 1.0 |  |  | 596.8466390632993 | -1356.1374013080874 | 847.4992210568212 | -1122.4967960257754 | 4.178723821316553e-06 | 0.569555928129584 | 1292.377771750563 | 0.024636055215674756 | 50.12341520633392 | 1148.90439677688 | 1148.90439677688 | 740.3823954892412 | 63.05949830956375 | 32.61600247027614 | 1.8356964989255212e-07 | 0.00025709184404899523 | 0.07204506613561601 | rope strain exceeds the configured small-strain screening threshold; large bending per module: refine discretization / verify guide geometry | 255.40828526068785 | 43.999999999999986 | 0.0 | -7.541091700476801 | 0.0 | -9.402242640402669 | 0.0 | -7.5410917004776135
