KevinQianjin/ASRC_snake_body_design/cad/lanes_u4m2/guides_v2/M5_lane_anchorB.stl

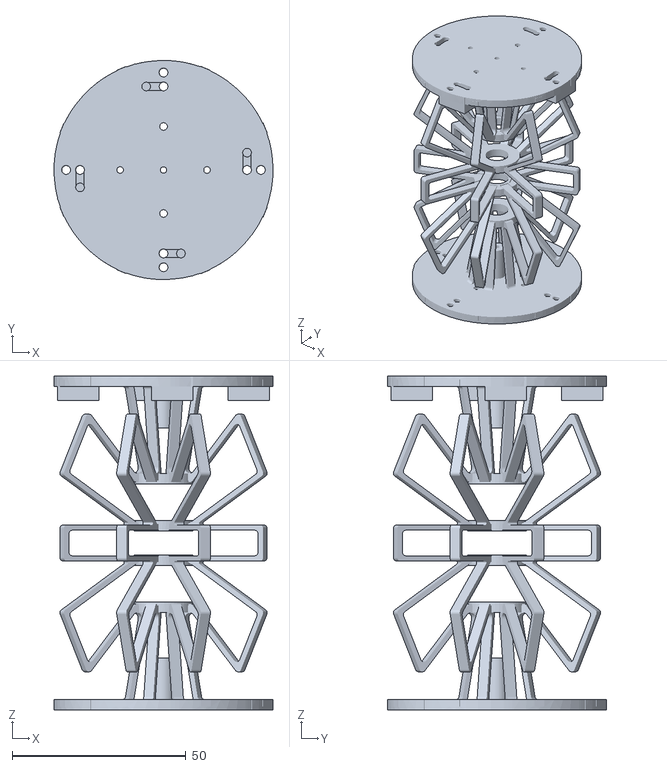
[picture p51: CAD file, 2026-11-14]
cad/lanes_u4m2/guides_v2/M5_lane_anchorB.stl
62.9 x 62.9 x 96.0
