KevinQianjin/ASRC_snake_body_design/cad/lanes_u4m2/U_lane_pass.stl

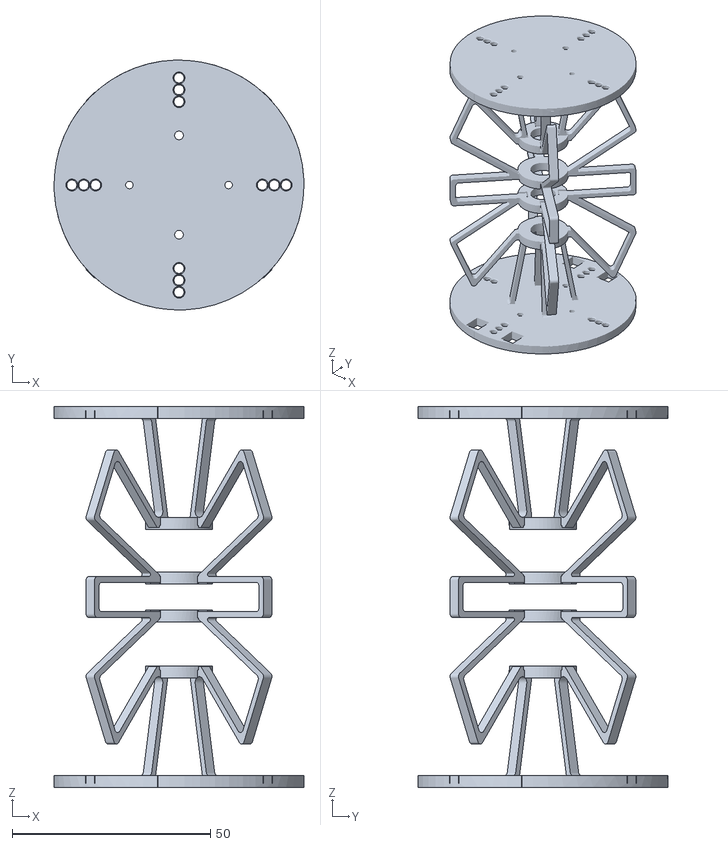
[picture p52: CAD file, 2026-11-13]
cad/lanes_u4m2/U_lane_pass.stl
63.0 x 63.0 x 96.0
