KevinQianjin/ASRC_snake_body_design/cad/modules/UniDirectional_96.step

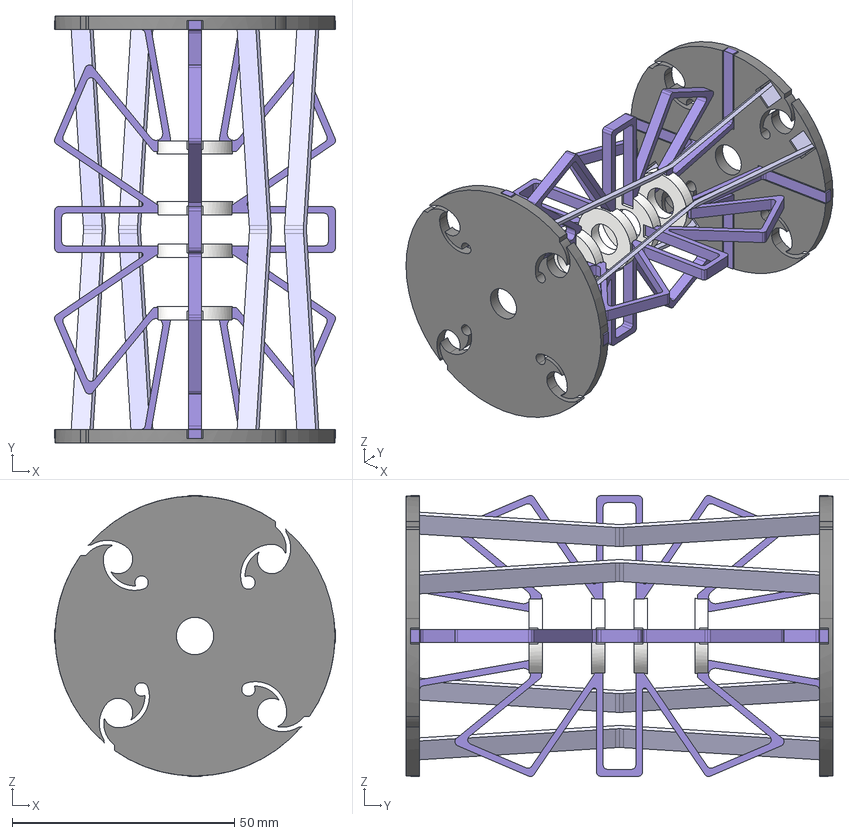
[picture p53: CAD file, 2026-11-10]
cad/modules/UniDirectional_96.step
63.2 x 96.0 x 63.2 mm
Inner Ring:1
NPJ_Wing v7:1
NPJ_Wing v7:2
NPJ_Wing v7:3
NPJ_Wing v7:4
Disk (1):1
Leaf Spring:1
