KevinQianjin/ASRC_snake_body_design/cad/previews/u4m2/UniDirectional_96_part_05.stl

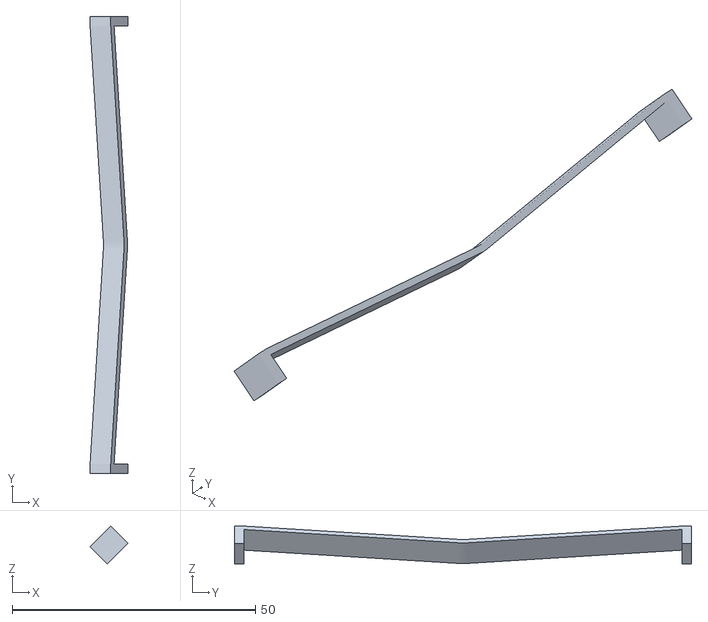
[picture p54: CAD file, 2026-11-10]
cad/previews/u4m2/UniDirectional_96_part_05.stl
7.78 x 94.0 x 7.78
