KevinQianjin/ASRC_snake_body_design/cad/tank/tank-v2.step

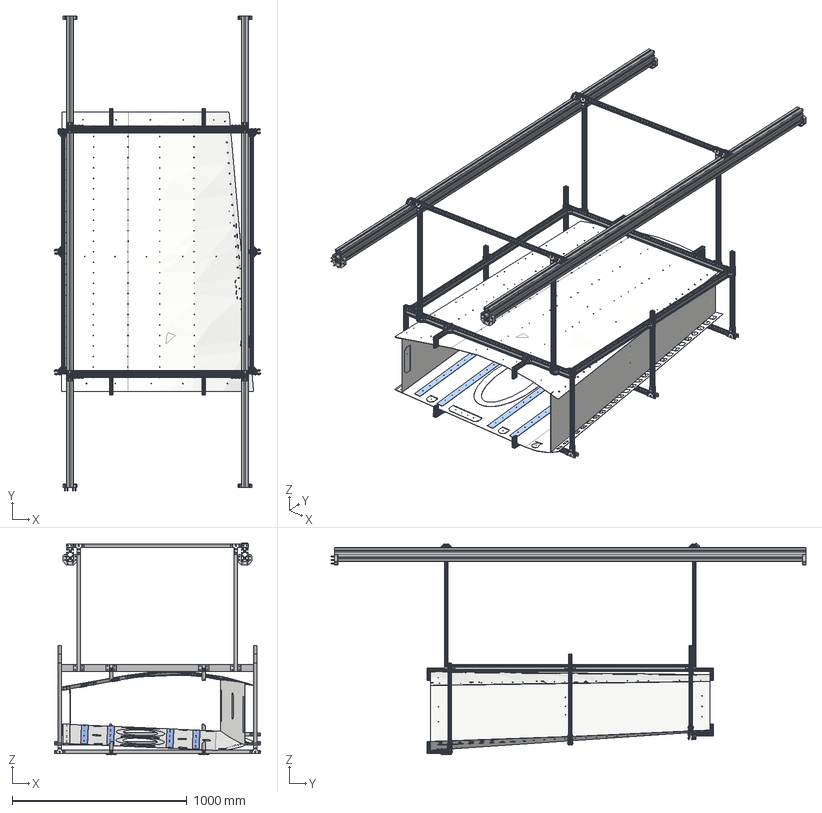
[picture p55: CAD file, 2026-11-05]
cad/tank/tank-v2.step
1180.2 x 2720.4 x 1211.7 mm
6575N413_T-Slotted Framing Rail x 2
ISO 10642 - M6 x 40 Steel 8.8 Plain x 6
FT P1
FT P5 x 2
FT P4 x 2
HL NUT x 381
FT P2
FT P3 x 2
FT P6 x 4
5537T9_T-Slotted Framing x 8
5537T9_T-Slotted Framing_1 x 8
6575N409_T-Slotted Framing Rail_1 x 2
6575N409_T-Slotted Framing Rail x 2
5537T9_T-Slotted Framing_2 x 3
5537T9_T-Slotted Framing_3 x 6
5537T9_T-Slotted Framing_4
6575N401_T-Slotted Framing Rail
5537T663_T-Slotted Framing
5537T663_T-Slotted Framing_1 x 5
5537T663_T-Slotted Framing_2
5537T663_T-Slotted Framing_3 x 11
5537T663_T-Slotted Framing_4 x 3
5537T663_T-Slotted Framing_5 x 4
5537T663_T-Slotted Framing_6 x 4
5537T663_T-Slotted Framing_7 x 11
6575N401_T-Slotted Framing Rail_1
3136N917_Silver Flush Tee Bracket for 20mm High Rail T-Slotted Framin g
3136N917_Silver Flush Tee Bracket for 20mm High Rail T-Slotted Framin g_1
3136N917_Silver Flush Tee Bracket for 20mm High Rail T-Slotted Framin g_2 x 14
3136N917_Silver Flush Tee Bracket for 20mm High Rail T-Slotted Framin g_3
3136N917_Silver Flush Tee Bracket for 20mm High Rail T-Slotted Framin g_4 x 4
3136N917_Silver Flush Tee Bracket for 20mm High Rail T-Slotted Framin g_5
3136N917_Silver Flush Tee Bracket for 20mm High Rail T-Slotted Framin g_6
3136N917_Silver Flush Tee Bracket for 20mm High Rail T-Slotted Framin g_7
5537T9_T-Slotted Framing_5
6575N401_T-Slotted Framing Rail_2
6575N401_T-Slotted Framing Rail_3
