KevinQianjin/ASRC_snake_body_design/simulations/u4m2/lanes_20261113/guided_validation_20261114/candidate/mount_audit/bent_M5_z-12_overlap.stl

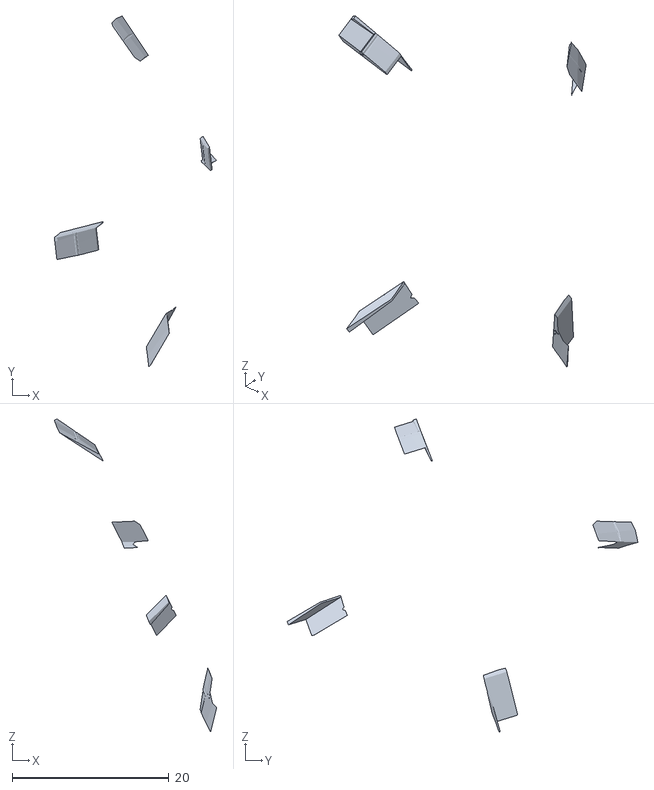
[picture p56: CAD file, 2026-11-14]
simulations/u4m2/lanes_20261113/guided_validation_20261114/candidate/mount_audit/bent_M5_z-12_overlap.stl
20.7 x 44.8 x 40.0
