KevinQianjin/ASRC_snake_body_design/cad/lanes_u4m2/guides_v2/M6_z+24_guide.stl

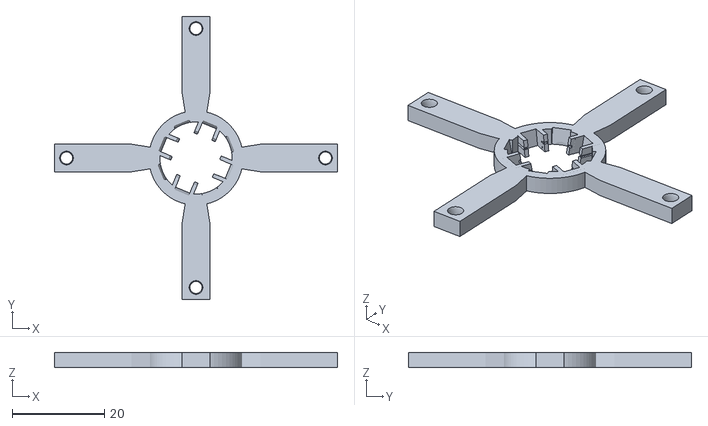
[picture p57: CAD file, 2026-11-14]
cad/lanes_u4m2/guides_v2/M6_z+24_guide.stl
61.2 x 61.2 x 3.24
