KevinQianjin/ASRC_snake_body_design/cad/lanes_u4m2/U4_lane_anchorA.stl

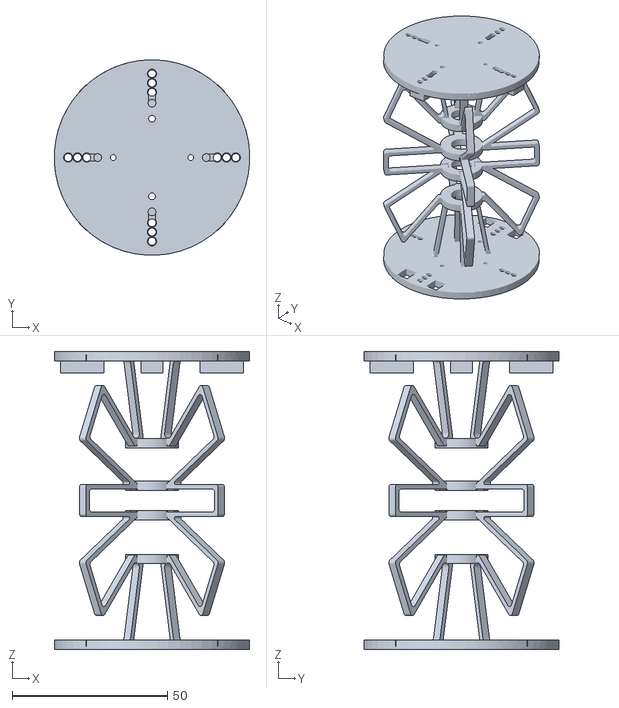
[picture p58: CAD file, 2026-11-13]
cad/lanes_u4m2/U4_lane_anchorA.stl
63.0 x 63.0 x 96.0
