KevinQianjin/ASRC_snake_body_design/cad/modules/Medium_Stiffness_96.step

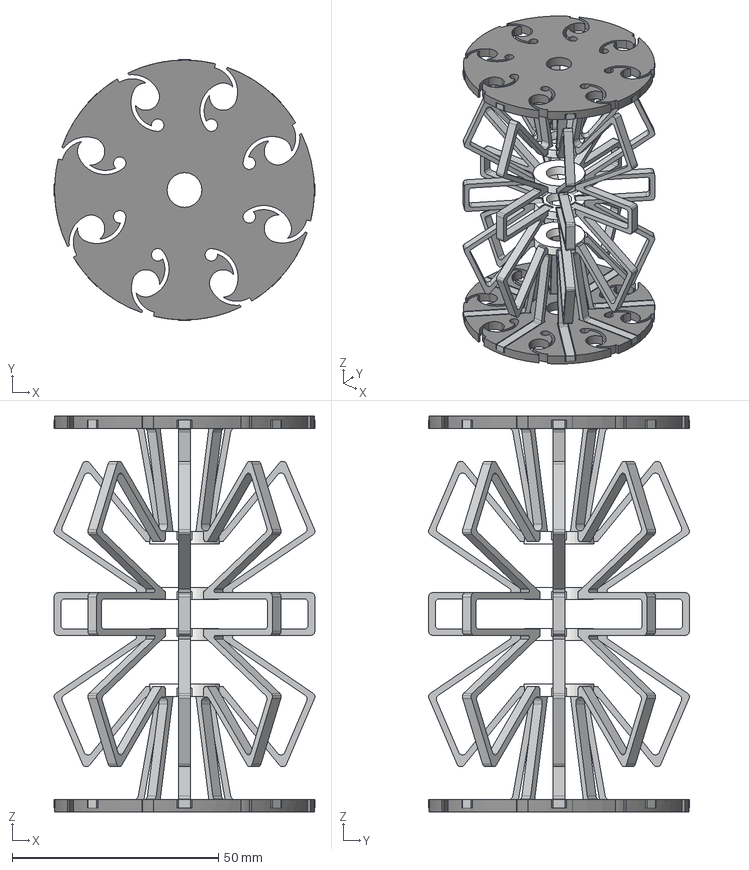
[picture p59: CAD file, 2026-11-10]
cad/modules/Medium_Stiffness_96.step
63.2 x 63.2 x 96.0 mm
NPJ_Wing v7:1
NPJ_Wing v7:2
NPJ_Wing v7:3
NPJ_Wing v7:4
NPJ_Wing v7:5
NPJ_Wing v7:6
NPJ_Wing v7:7
NPJ_Wing v7:8
Inner Ring:1
Disk (1):1
