KevinQianjin/ASRC_snake_body_design/simulations/u4m2/lanes_20261113/guided_validation_20261114/candidate/mount_audit/bent_M5_body.stl

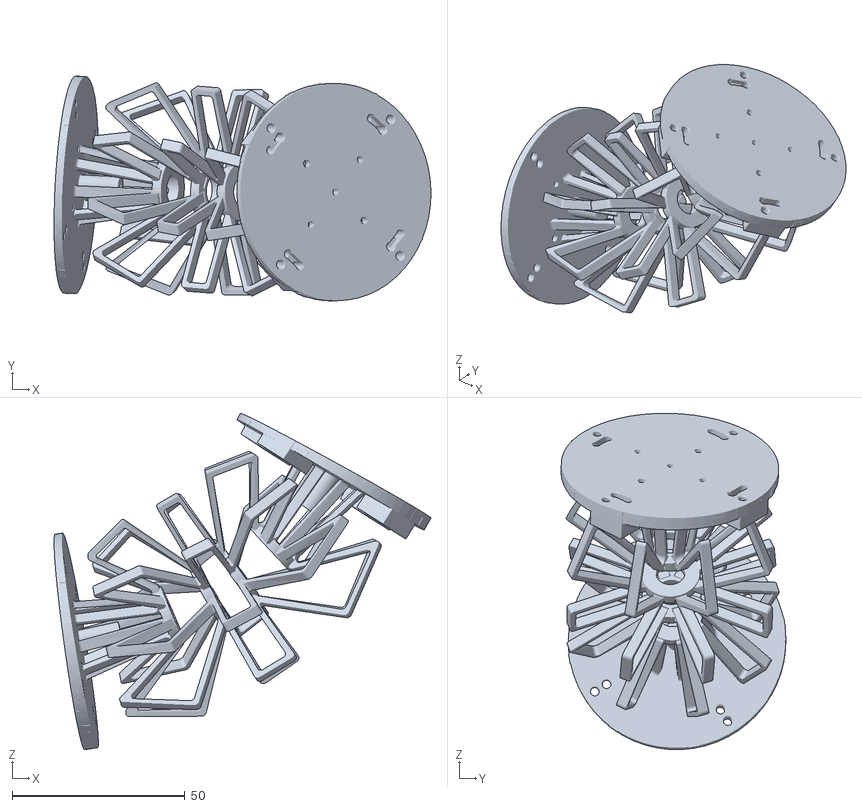
[picture p60: CAD file, 2026-11-14]
simulations/u4m2/lanes_20261113/guided_validation_20261114/candidate/mount_audit/bent_M5_body.stl
109.2 x 65.1 x 97.4
