KevinQianjin/ASRC_snake_body_design/simulations/u4m2/lanes_20261113/guided_validation_20261114/candidate/mount_audit/bent_M5_z-12_guide.stl

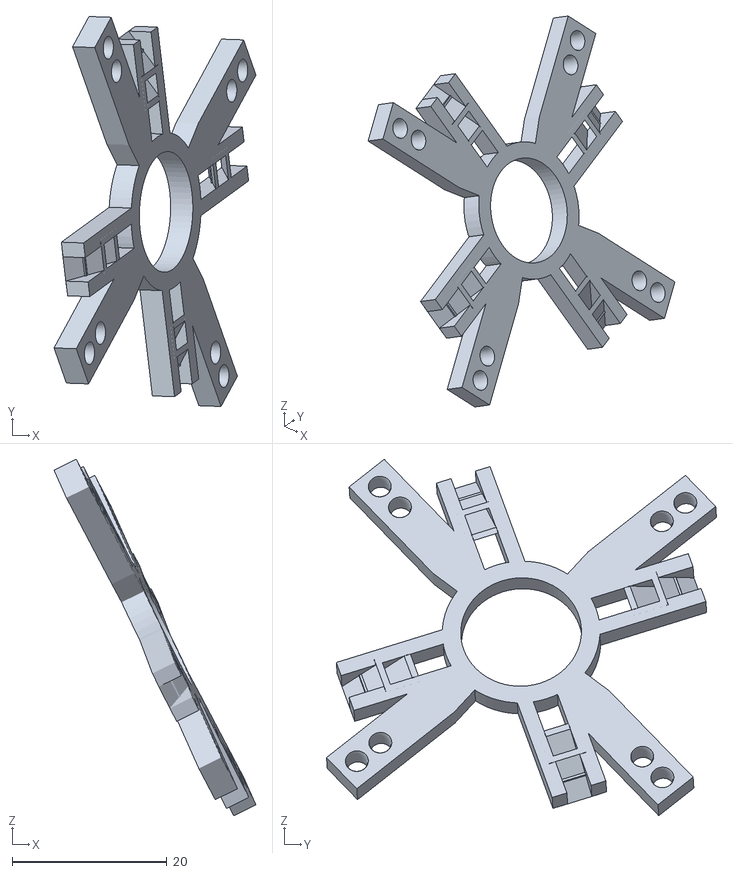
[picture p62: CAD file, 2026-11-14]
simulations/u4m2/lanes_20261113/guided_validation_20261114/candidate/mount_audit/bent_M5_z-12_guide.stl
26.1 x 50.4 x 46.0
