KevinQianjin/ASRC_snake_body_design/cad/lanes_u4m2/base_interface.stl

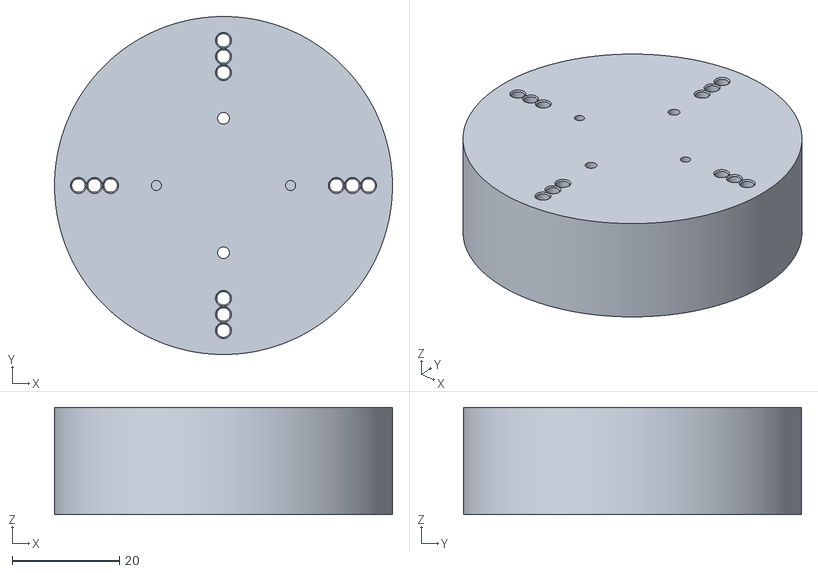
[picture p63: CAD file, 2026-11-13]
cad/lanes_u4m2/base_interface.stl
62.9 x 62.9 x 20.0
