KevinQianjin/ASRC_snake_body_design/cad/lanes_u4m2/guides_v2/M6_z+24_wire_envelope.stl

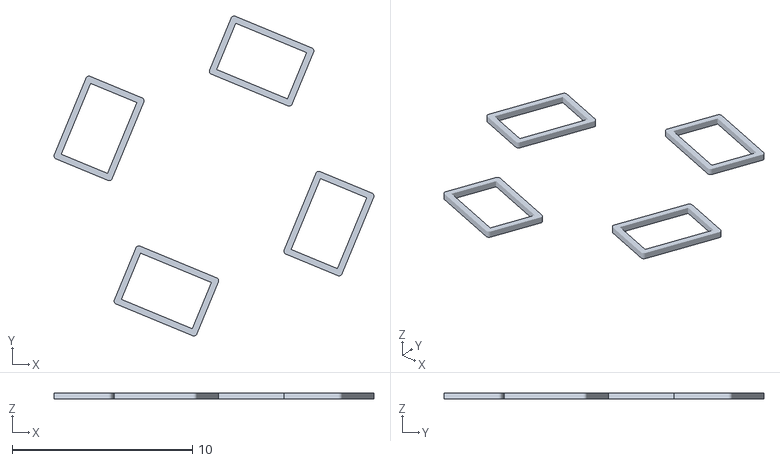
[picture p64: CAD file, 2026-11-14]
cad/lanes_u4m2/guides_v2/M6_z+24_wire_envelope.stl
17.7 x 17.7 x 0.35
