KevinQianjin/ASRC_snake_body_design/cad/lanes_u4m2/guides_v2/M6_z+12_wire_envelope.stl

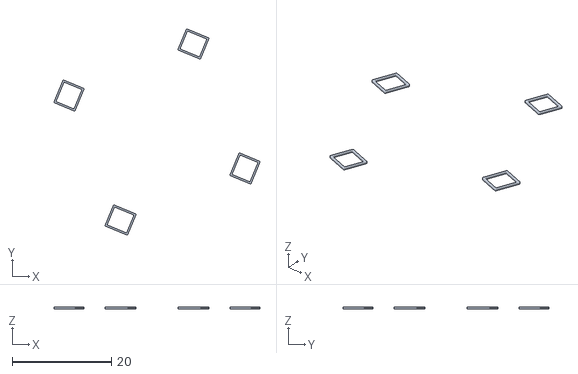
[picture p65: CAD file, 2026-11-14]
cad/lanes_u4m2/guides_v2/M6_z+12_wire_envelope.stl
41.6 x 41.6 x 0.35
