KevinQianjin/ASRC_snake_body_design/cad/lanes_u4m2/guides_v2/M6_z+12_caps.stl

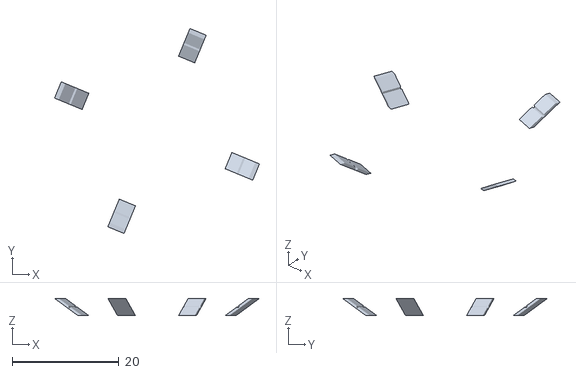
[picture p66: CAD file, 2026-11-14]
cad/lanes_u4m2/guides_v2/M6_z+12_caps.stl
38.5 x 38.5 x 3.24
