KevinQianjin/ASRC_snake_body_design/cad/lanes_u4m2/guides_v2/M5_preview_cutaway.stl

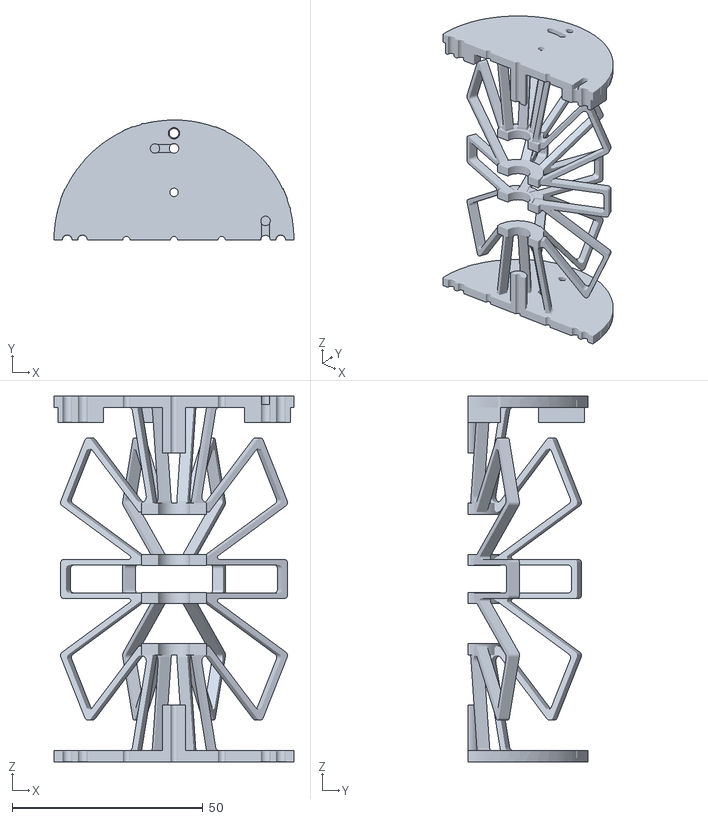
[picture p67: CAD file, 2026-11-14]
cad/lanes_u4m2/guides_v2/M5_preview_cutaway.stl
62.9 x 31.5 x 96.0
