KevinQianjin/ASRC_snake_body_design/cad/lanes_u4m2/guides_v2/M6_z+24_caps.stl

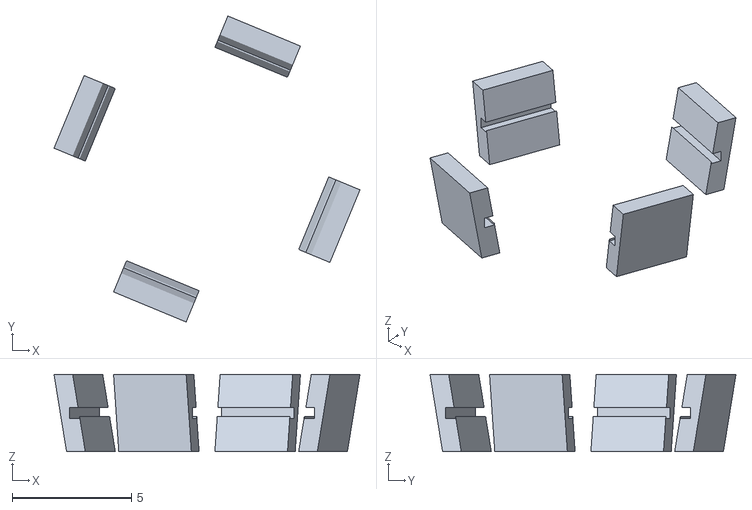
[picture p68: CAD file, 2026-11-14]
cad/lanes_u4m2/guides_v2/M6_z+24_caps.stl
12.8 x 12.8 x 3.24
