KevinQianjin/ASRC_snake_body_design/cad/lanes_u4m2/guides_v2/head_adapter.stl

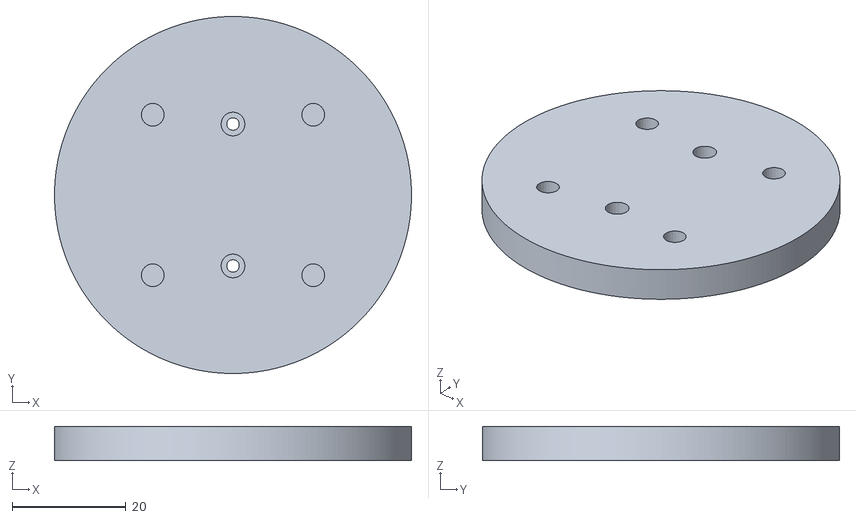
[picture p70: CAD file, 2026-11-13]
cad/lanes_u4m2/guides_v2/head_adapter.stl
62.9 x 62.9 x 6.00
