KevinQianjin/ASRC_snake_body_design/cad/lanes_u4m2/guides_v2/U_leaf_springs.stl

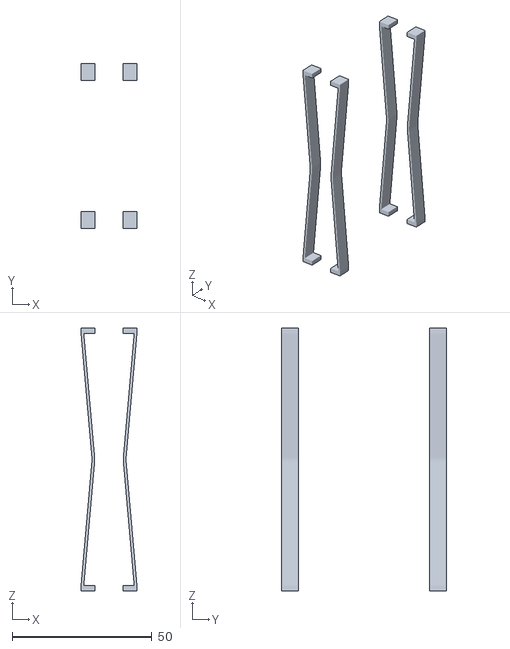
[picture p71: CAD file, 2026-11-13]
cad/lanes_u4m2/guides_v2/U_leaf_springs.stl
20.0 x 58.8 x 94.0
