KevinQianjin/ASRC_snake_body_design/(list of files, cad)

Other CAD files:
cad/previews/u4m2/UniDirectional_96_part_04.stl
cad/lanes_u4m2/M6_lane_anchorC.stl
cad/previews/u4m2/UniDirectional_96_part_03.stl
cad/lanes_u4m2/guides_v2/U4_lane_anchorA.stl
cad/previews/u4m2/UniDirectional_96_part_01.stl
cad/lanes_u4m2/guides_v2/M6_lane_anchorC.stl
cad/lanes_u4m2/M5_lane_anchorB.stl
cad/previews/u4m2/UniDirectional_96_part_02.stl
cad/lanes_u4m2/guides_v2/U_lane_pass.stl
cad/previews/u4m2/Medium_Stiffness_96.stl
cad/lanes_u4m2/guides_v2/base_interface.stl
cad/lanes_u4m2/guides_v2/M5_z+12_guide.stl
ASRC_kevin/moving_prototype/full_length/01_U1_base.scad
ASRC_kevin/moving_prototype/full_length/02_U2.scad
ASRC_kevin/moving_prototype/full_length/03_U3.scad
ASRC_kevin/moving_prototype/full_length/04_U4.scad
ASRC_kevin/moving_prototype/full_length/05_M1.scad
ASRC_kevin/moving_prototype/full_length/06_M2_tip.scad
ASRC_kevin/moving_prototype/full_length/07_base_interface.scad
ASRC_kevin/moving_prototype/full_length/08_head_placeholder.scad
ASRC_kevin/moving_prototype/full_length/module_common.scad
ASRC_kevin/moving_prototype/full_length/U4M2_backbone_assembly.scad
archive/superseded_cad/full_length/01_U1_base.scad
archive/superseded_cad/full_length/02_U2.scad
archive/superseded_cad/full_length/03_U3.scad
archive/superseded_cad/full_length/04_U4.scad
archive/superseded_cad/full_length/05_M1.scad
archive/superseded_cad/full_length/06_M2_tip.scad
archive/superseded_cad/full_length/07_base_interface.scad
archive/superseded_cad/full_length/08_head_placeholder.scad
archive/superseded_cad/full_length/U4M2_backbone_assembly.scad
archive/superseded_cad/full_length/module_common.scad
cad/lanes_u4m2/guides_v2/M5_z-12_caps.stl
cad/lanes_u4m2/guides_v2/M5_z-12_guide.stl
cad/lanes_u4m2/guides_v2/M5_z-24_caps.stl
cad/lanes_u4m2/guides_v2/M5_z-24_guide.stl
cad/lanes_u4m2/guides_v2/M6_z-12_caps.stl
cad/lanes_u4m2/guides_v2/M6_z-12_guide.stl
cad/lanes_u4m2/guides_v2/M6_z-24_caps.stl
cad/lanes_u4m2/guides_v2/M6_z-24_guide.stl
cad/simulation_reference/u4m2_500g/simulation_reference.blend
