KevinQianjin/ASRC_snake_body_design/ASRC_kevin/front_sweep_5_to_11/front_sweep_results/RESULTS.md

5 至 11 節前端完整自重模擬（2026-11-04）

已完成前端 5、6、7、8、9、10、11 節，每種模組至少一節，排列固定為 high → uni-d → directional → low。
後段 high + uni-d 有 Ø4.2 mm 304 實心圓棒，前段 directional + low 沒有骨架。模組 EI 與質量沿用原論文，未做 PLA 或尺寸換算。

固定條件：每節 48 mm、外徑 32 mm、根部水平夾持、僅自重。前端長度依序為 240、288、336、384、432、480、528 mm。沒有繩索張力、頭部附件載荷或壁面接觸。
有效檢查區依使用者確認為 1600 × 830 × 300 mm。

本次保留兩種比較，並分開保存數據：

- 原程序後段掃描：後段 2–20 節，每種前端節數掃描所有 high/uni-d 與 directional/low 正整數組合，共 9,310 組。
- 固定總長比較：整機 31 節、1488 mm，後段為 31 減去前端節數，共 1,050 組。
- 兩組比較有 190 組重疊；合計 10,170 個不重複配置。H8-U12 固定後段比較是完整掃描的一部分。

固定後段 H8-U12（960 mm）的比較；範圍涵蓋全部 directional/low 組合：

| 前端節數 | 前端長 mm | 整機長 mm | 頭部下垂 mm | 水平伸達 mm | 載重平衡附近前端柔順度 deg/(N·mm) |
|---:|---:|---:|---:|---:|---:|
| 5 | 240 | 1200 | 191.0–197.5 | 1164.3–1169.0 | 3.859–4.669 |
| 6 | 288 | 1248 | 259.6–268.8 | 1170.6–1181.2 | 4.082–4.914 |
| 7 | 336 | 1296 | 332.9–341.2 | 1160.5–1176.7 | 4.125–4.936 |
| 8 | 384 | 1344 | 402.7–408.4 | 1143.1–1161.7 | 4.107–4.905 |
| 9 | 432 | 1392 | 466.8–471.6 | 1124.5–1143.2 | 4.084–4.880 |
| 10 | 480 | 1440 | 526.6–532.1 | 1107.8–1124.9 | 4.069–4.866 |
| 11 | 528 | 1488 | 583.5–589.8 | 1093.8–1108.8 | 4.061–4.860 |

柔順度為自重平衡附近、施加微小末端彎矩時，前端相對後端的轉角響應。它不等於最大可控彎角、最小轉彎半徑或檢查能力。上下限是組合最小／最大值，不是置信區間或材料誤差界限。

原後段 2–20 節掃描中的簡化空間與鋼芯參考屈服篩選：

| 前端節數 | 掃描組合 | 同時通過組合 | 掃描範圍內最長可通過後段 | 通過組合的最大水平伸達 mm |
|---:|---:|---:|---:|---:|
| 5 | 760 | 760 | 20 節 / 960 mm | 1169.3 |
| 6 | 950 | 929 | 20 節 / 960 mm | 1181.5 |
| 7 | 1140 | 612 | 15 節 / 720 mm | 950.3 |
| 8 | 1330 | 0 | 無 | 無 |
| 9 | 1520 | 0 | 無 | 無 |
| 10 | 1710 | 0 | 無 | 無 |
| 11 | 1900 | 0 | 無 | 無 |

此處機身以直徑 32 mm 的連續膠囊包絡近似，檢查整體水平、垂直包絡能否放入空的有效檢查區，並假定可選擇最有利垂直位置。這是保守的幾何篩選；沒有核對指定入口、真實內部障礙、碰撞路徑、攝影視場或線圈距離。通過不是任務可行或強度認證。
5 節在此次後段範圍全部通過；6 節在後段 20 節時有部分組合超出高度；7 節的可通過後段最長為 15 節。8–11 節在此次掃描均未通過包絡篩選。20 節是原程序掃描上限，不能據此宣稱是全域最大可行後段。

固定整機 31 節、1488 mm 的比較：

| 前端節數 | 後段節數 | 鋼芯應力/參考屈服範圍 | 通過參考屈服／組合總數 | 同時通過空間與參考屈服 |
|---:|---:|---:|---:|---:|
| 5 | 26 | 1.1157–1.2380 | 0/100 | 0 |
| 6 | 25 | 1.0710–1.1882 | 0/120 | 0 |
| 7 | 24 | 1.0261–1.1384 | 0/138 | 0 |
| 8 | 23 | 0.9811–1.0883 | 41/154 | 0 |
| 9 | 22 | 0.9361–1.0382 | 132/168 | 0 |
| 10 | 21 | 0.8912–0.9882 | 180/180 | 0 |
| 11 | 20 | 0.8466–0.9384 | 190/190 | 0 |

固定總長的 1,050 組沒有組合同時通過兩項簡化篩選。參考屈服值為目前材料目錄採用的 205 MPa，並非這根鋼棒的實測值。超過此值的計算只保留作線彈性外推與篩選警示，不視為有效彈性形狀或塑性變形預測。
保留的 N31 Pareto 曲線僅比較水平伸達與微小彎矩柔順度，先排除超過參考屈服者；檔名與圖例均標明 yield-only。另存的 empty-box Pareto 同時要求空箱包絡與參考屈服通過。兩者不可混為已滿足實際檢查需求的最優解。

結果圖：

- [下垂與前端節數](head_drop_vs_front_modules.png)
- [伸達、柔順度、下垂與應力總覽](front_5_to_11_overview.png)
- [後段／前段組合空間與參考屈服篩選](rear_front_envelope_screen.png)
- [七種參考形狀](reference_shapes_5_to_11.png)

- [5 節前端的四項詳細圖](front_05/simulation_summary.png)
- [6 節前端的四項詳細圖](front_06/simulation_summary.png)
- [7 節前端的四項詳細圖](front_07/simulation_summary.png)
- [8 節前端的四項詳細圖](front_08/simulation_summary.png)
- [9 節前端的四項詳細圖](front_09/simulation_summary.png)
- [10 節前端的四項詳細圖](front_10/simulation_summary.png)
- [11 節前端的四項詳細圖](front_11/simulation_summary.png)

每個 front_05 至 front_11 資料夾均包含完整組合表、固定總長表、固定 H8-U12 表、兩種 Pareto 表、參考配置有／無骨架形狀座標，以及 summary.json。數值欄位名稱含單位。

驗證：全部算例收斂；既有 5 項力學單元測試通過。各前端節數均做 8/16/32 cells 網格比較、重力步數加倍、零重力解析柔順度比對，以及獨立連續梁邊值解比對。另對每種節數最接近高度或參考屈服邊界的 14 個算例加密至 64 cells，分類沒有改變。
16 → 32 cells 的參考下垂最大變化 0.00973 mm；32 cells 與獨立連續解的下垂最大差 0.00326 mm。與上一輪資料重疊的 4,396 個數值逐項相同。
數值收斂不表示原論文參數已在這個整機上由實物校準。原論文模組包含 PC 柔性元件與 PLA 結構；本次依指示使用原始數據，沒有把它們換成全 PLA 參數。
專案文件中的 0.5 kg 載荷目標沒有當作實際頭部質量加入本次自重算例。實際相機、感應線圈與線材重量仍待提供。

主要資料：[彙總 CSV](front_count_summary.csv)、[原後段掃描 CSV](all_rear_sweep_combinations.csv)、[固定 N31 CSV](all_fixed_N31_combinations.csv)、[數值驗證](validation.json)、[邊界加密與舊結果比對](boundary_and_prior_result_checks.json)。
