KevinQianjin/ASRC_snake_body_design/ASRC_kevin/rope_results_target_position/test_output.txt

test_backbone_small_bend_recovers_ei (test_snake_model_ropes.RopeModelTests.test_backbone_small_bend_recovers_ei) ... ok
test_database_can_be_reseeded_without_losing_sources_or_runs (test_snake_model_ropes.RopeModelTests.test_database_can_be_reseeded_without_losing_sources_or_runs) ... ok
test_equal_four_rope_takeup_only_compresses_centerline (test_snake_model_ropes.RopeModelTests.test_equal_four_rope_takeup_only_compresses_centerline) ... ok
test_full_energy_gradient_including_plastic_fibers_and_rope_geometry (test_snake_model_ropes.RopeModelTests.test_full_energy_gradient_including_plastic_fibers_and_rope_geometry) ... ok
test_invalid_guide_radius_is_rejected (test_snake_model_ropes.RopeModelTests.test_invalid_guide_radius_is_rejected) ... ok
test_modules_only_planar_solution_matches_original (test_snake_model_ropes.RopeModelTests.test_modules_only_planar_solution_matches_original) ... ok
test_opposing_tendon_commands_mirror_and_two_planes_are_active (test_snake_model_ropes.RopeModelTests.test_opposing_tendon_commands_mirror_and_two_planes_are_active) ... ok
test_plastic_backbone_leaves_residual_after_complete_external_unload (test_snake_model_ropes.RopeModelTests.test_plastic_backbone_leaves_residual_after_complete_external_unload) ... ok
test_rope_is_tension_only_and_pretension_is_correct (test_snake_model_ropes.RopeModelTests.test_rope_is_tension_only_and_pretension_is_correct) ... ok
test_rotation_derivatives_and_orthogonality (test_snake_model_ropes.RopeModelTests.test_rotation_derivatives_and_orthogonality) ... ok
test_section_area_and_second_moments (test_snake_model_ropes.RopeModelTests.test_section_area_and_second_moments) ... ok
test_tip_payload_force_and_attachment_node (test_snake_model_ropes.RopeModelTests.test_tip_payload_force_and_attachment_node) ... ok
test_folded_tip_at_root_height_is_not_reported_as_horizontal_success (test_snake_model_ropes_level.LevelInverseTests.test_folded_tip_at_root_height_is_not_reported_as_horizontal_success) ... ok
test_force_inverse_lengths_reproduce_requested_tensions (test_snake_model_ropes_level.LevelInverseTests.test_force_inverse_lengths_reproduce_requested_tensions) ... ok
test_partial_loading_is_never_reported_as_requested_load_success (test_snake_model_ropes_level.LevelInverseTests.test_partial_loading_is_never_reported_as_requested_load_success) ... ok
test_progressive_loading_holds_a_reachable_requested_payload (test_snake_model_ropes_level.LevelInverseTests.test_progressive_loading_holds_a_reachable_requested_payload) ... ok
test_reachable_level_target_is_forward_verified (test_snake_model_ropes_level.LevelInverseTests.test_reachable_level_target_is_forward_verified) ... ok
test_rejected_trial_does_not_commit_plastic_history (test_snake_model_ropes_level.LevelInverseTests.test_rejected_trial_does_not_commit_plastic_history) ... ok
test_slack_tendon_is_probed_past_its_zero_response_interval (test_snake_model_ropes_level.LevelInverseTests.test_slack_tendon_is_probed_past_its_zero_response_interval) ... ok
test_three_dimensional_target_reproduces_a_reachable_forward_case (test_snake_model_ropes_level.LevelInverseTests.test_three_dimensional_target_reproduces_a_reachable_forward_case) ... ok
test_tip_at_root_height_does_not_imply_horizontal_shape (test_snake_model_ropes_level.LevelInverseTests.test_tip_at_root_height_does_not_imply_horizontal_shape) ... ok

----------------------------------------------------------------------
Ran 21 tests in 1.817s

OK
