KevinQianjin/ASRC_snake_body_design/ASRC_kevin/four_rope_inverse_5_to_11/results/RESULTS.md

四繩逆靜力計算結果（2026-11-04）

完成前端 5–11 節、10,170 個不重複配置；每配置計算頭尾同高、前端向上半圓、前端向下半圓三項目標，共 30,510 列。
本次找到 7,616 個頭尾同高平衡解，其中 5,441 個通過空箱、自包絡、平面穩定與鋼芯參考屈服篩選；較大軸向應變仍須另查。固定總長31節（1488 mm）的組合均未找到同高解。11節前端沒有組合同時通過上述四項篩選。這些都是本次有限平面搜尋的結果，未證明全域無解。

四繩順序為上／右／下／左。模組原論文 EI、EA 與質量不做材料換算；後段 Ø4.2 mm 304 實心圓棒，前段沒有骨架；四條 Ø2 mm 尼龍繩沿真實端盤 13 mm 半徑導孔走線，均錨定於頭部。僅自重，包含繩索原長質量，附件載荷 0。

頭尾同高目標只要求末端與固定根部的高度、側向坐標相同，並非整機伸直，也沒有最低前伸比例。四根繩皆可鬆弛；搜尋以總非負張力最小為目標，輸出是記錄範圍內找到的最低值，不宣稱已證明所有空間姿態的全域最小。

半圓目標同時檢查前端相對轉角 180°（容許 1°）及與要求圓弧的最大中心線偏差 ≤1 mm。未通過圓弧誤差者，目標張力欄留空，另存角度 180° 的診斷拉力。不存在強制形狀的外加支撐反力。

固定 H8-U12 後段（960 mm）的代表配置：

| 前端 | D/L | 頭尾同高：上/右/下/左 N | 180°向上診斷：上/右/下/左 N | 180°向下診斷：上/右/下/左 N | 向上/下圓弧最大誤差 mm |
|---:|---:|---|---|---|---|
| 5 | 4/1 | 2.036 / 0.000 / 0.000 / 0.000 | 2.993 / 0.000 / 0.000 / 0.000 | 0.000 / 0.000 / 2.848 / 0.000 | 36.72 / 18.37 |
| 6 | 4/2 | 2.114 / 0.000 / 0.000 / 0.000 | 2.585 / 0.000 / 0.000 / 0.000 | 0.000 / 0.000 / 2.280 / 0.000 | 78.52 / 25.31 |
| 7 | 5/2 | 2.429 / 0.000 / 0.000 / 0.000 | 2.583 / 0.000 / 0.000 / 0.000 | 0.000 / 0.000 / 2.054 / 0.000 | 131.65 / 28.09 |
| 8 | 6/2 | 2.770 / 0.000 / 0.000 / 0.000 | 2.749 / 0.000 / 0.000 / 0.000 | 0.000 / 0.000 / 1.902 / 0.000 | 214.66 / 34.20 |
| 9 | 7/2 | 未找到解 | 2.945 / 0.000 / 0.000 / 0.000 | 0.000 / 0.000 / 1.802 / 0.000 | 310.85 / 43.88 |
| 10 | 7/3 | 未找到解 | 2.890 / 0.000 / 0.000 / 0.000 | 0.000 / 0.000 / 1.649 / 0.000 | 412.53 / 54.81 |
| 11 | 8/3 | 未找到解 | 2.963 / 0.000 / 0.000 / 0.000 | 0.000 / 0.000 / 1.615 / 0.000 | 499.20 / 69.56 |

整體搜尋找到符合半圓誤差的狀態共 0 個；最佳已找到的圓弧最大偏差為 3.346 mm，仍大於1 mm。上表兩個 180° 欄位是角度診斷，不能解讀為已形成半圓。
由於零預緊、垂直平面對稱且目標採最低總張力，代表同高解通常只需上繩，其他繩可以是 0 N。上表的同高欄先列數學平衡解，適用性須另查空箱、自包絡、平面穩定與鋼芯參考屈服旗標。若加入共同收緊力，上下／左右分配可能有多解；本模型保存其中一組非負分配。

| 前端 | 配置總數 | 找到同高解 | 通過空箱/自包絡/平面穩定/鋼芯參考屈服 | 同高解軸向壓縮超過5% | 固定N31找到同高解 |
|---:|---:|---:|---:|---:|---:|
| 5 | 860 | 760 | 760 | 0 | 0 |
| 6 | 1070 | 950 | 950 | 24 | 0 |
| 7 | 1278 | 1140 | 1140 | 215 | 0 |
| 8 | 1484 | 1245 | 1245 | 886 | 0 |
| 9 | 1688 | 1202 | 1026 | 1198 | 0 |
| 10 | 1890 | 1153 | 320 | 1137 | 0 |
| 11 | 1900 | 1166 | 0 | 1156 | 0 |

重要的解讀範圍：

- 四繩張力在無摩擦路徑中各自保持一致。模型使用實際端盤之間的直線繩段，網格加密不會增加虛構導孔。
- 以垂直對稱平面求解，右左張力相等；平面外彎曲、獨立扭轉及空間失穩沒有驗證。因此不宣稱完整三維全域最優或三維穩定。
- 主要搜尋使用有符號上下差值 D 及左右共同張力 S；另外對所有配置補查上下共同對拉 A 與混合對拉。四繩分配為 [max(D,0)+A/2, S/2, max(-D,0)+A/2, S/2]。實際導孔直線繩段的上下共同模式與左右共同模式不假定等價；A、S 採有限網格，未對所有可能值作全域證明。缺失同高解再以相鄰已收斂配置延續重試，最終都重新滿足自身參數的平衡。
- uni-d 和 directional 使用原表的 Y 向 EI；原表沒有獨立的負 Y 測值，向上／向下沿用同一 Y 向數值是對稱性假設。
- 模組軸向壓縮使用原論文線性 EA。超過 5% 只是明確標示較大應變外推，5% 並非實測允許變形或破壞界限；這些列仍保留數學計算值，不能據此認證實物能力。
- 繩索 PA6 的 E、密度是既有實心材料代理值，並非實際編織繩的有效參數。繩索自重按原長均勻轉移至機身，不求鬆繩懸垂曲線。零張力繩選擇額外放出1 mm作為一組鬆弛指令；該指令不是唯一值。
- 鋼芯應力包含軸向及彎曲，以 205 MPa 目錄參考值篩選，並非實際鋼棒實測屈服。超過參考值不作有效線彈性設計。
- 空間檢查為實際形狀加32 mm膠囊包絡能否放入1600×830×300 mm空箱，並檢查保守自包絡干涉；不包含實際入口、油箱障礙及接觸力。
- 未找到同高解只代表此次分支與有限範圍搜尋沒有得到解，不是全域無解證明。角度診斷達180°亦不代表半圓目標達成。

數值檢查：能量一階／二階導數、頭部位置雅可比、繩索虛功、真實導孔數量、零張力極限、原模組參數與後段骨架質量、固定繩長回代均有獨立檢查。主要搜尋使用4 cells/module，保存結果再加密至8；補查與延續在8進行。最終所有已保存狀態均重新檢查平衡殘差、非負張力、固定繩長回代及目標標記；21個代表目標中的已找到狀態另加密至16。數值與加密誤差保存在 [最終數值檢查](final_numerical_audit.json)。

檔案：

- [全部目標與狀態 CSV](all_targets.csv)
- [同高目標所有配置](head_level_all_configurations.csv)
- [半圓目標與180°診斷](semicircle_targets_and_angle_diagnostics.csv)
- [H8-U12參考四繩張力](reference_H8_U12.csv)
- [前端節數彙總](front_count_summary.csv)
- [同高拉力與半圓誤差比較圖](reference_force_and_circle_error.png)
- [180°轉角診斷力圖](reference_180_angle_diagnostic_forces.png)
- [完整後段組合圖](head_level_configuration_map.png)

- [5節參考形狀](front_05_reference_shapes.png)、[5節所有配置的同高張力](front_05_configuration_tensions.png)
- [6節參考形狀](front_06_reference_shapes.png)、[6節所有配置的同高張力](front_06_configuration_tensions.png)
- [7節參考形狀](front_07_reference_shapes.png)、[7節所有配置的同高張力](front_07_configuration_tensions.png)
- [8節參考形狀](front_08_reference_shapes.png)、[8節所有配置的同高張力](front_08_configuration_tensions.png)
- [9節參考形狀](front_09_reference_shapes.png)、[9節所有配置的同高張力](front_09_configuration_tensions.png)
- [10節參考形狀](front_10_reference_shapes.png)、[10節所有配置的同高張力](front_10_configuration_tensions.png)
- [11節參考形狀](front_11_reference_shapes.png)、[11節所有配置的同高張力](front_11_configuration_tensions.png)

final_groups/ 保存每個前端／後段組合的最終CSV及8 cells/module角度／軸向應變狀態NPZ，可重建逐組形狀。groups/ 是主要搜尋與鄰近配置延續的中間資料；opposing_pair_trials/ 保存上下對拉與混合對拉補查。失敗列對應NaN，不能當作零張力成功解。
欄位 target_tension_* 僅在目標達成時填入；diagnostic_tension_* 是半圓未達標時的180°診斷。是否通過鋼芯、空間和穩定性請同時檢查相關旗標。
方法參考：[Li 等（2022）幾何非線性索驅連續體模型](https://yuan.mae.sustech.edu.cn/pdf/2022Li-acta-mechanics.pdf)。原論文性質仍是 PC 柔性元件與 PLA 結構，依指示未換成全PLA參數。
