KevinQianjin/ASRC_snake_body_design/simulations/shared/h8u12_front5to8_payload500g/results/RESULTS.md

H8U12、前端5–8節、頭部500 g：計算結果

後段固定high 8節＋uni-d 12節（960 mm），只有此後段加Ø4.2 mm 304 backbone。前端directional＋low完全沒有backbone。各類至少1節，前端5、6、7、8節共22配置。保留原論文EI、EA與質量，不作全PLA換算。四條Ø2 mm尼龍繩、13 mm導孔半徑、無摩擦、零預緊，全部錨定頭部。500 g為頭部中心的向下4.905 N集中力。

完成原有66個目標（同高、向上半圓、向下半圓），另算22個鬆繩自重狀態；空間模型共作11,880次四繩控制嘗試，其中5,335次取得收斂診斷平衡。控制嘗試包含重複控制點，不表示同數量的不重複姿態。

找到頭尾同高目標0個、符合1 mm半圓誤差目標0個。上／下／左／右共88項最大彎曲請求，符合靜力平衡、無自包絡干涉、鋼芯≤205 MPa及穩定性條件的最大值共0個。未找到合格狀態的最大角度與對應拉力留空，不填成0°或0 N，也不將過載診斷值冒充合格最大值。

原來四個代表配比的鬆繩診斷：

|前端|D/L|頭部下垂 mm|鋼芯最大應力 MPa|205 MPa篩選|
|---:|---:|---:|---:|---|
|5|4/1|704.66|708.19|超標|
|6|4/2|760.23|711.89|超標|
|7|5/2|814.27|715.93|超標|
|8|6/2|868.32|719.94|超標|

180°轉角診斷（不是成功半圓，也未通過鋼芯應力篩選）：

|前端|方向|上／右／下／左 N|圓弧最大偏差 mm|鋼芯應力 MPa|
|---:|---|---|---:|---:|
|5|向上|未找到轉角平衡解|—|—|
|5|向下|0.000／4.000／10.024／4.000|95.80|705.17|
|6|向上|4.000／0.000／13.752／0.000|269.52|708.94|
|6|向下|0.000／4.000／9.899／4.000|119.31|708.90|
|7|向上|0.000／4.000／9.900／4.000|319.16|712.98|
|7|向下|0.000／4.000／9.907／4.000|145.74|712.95|
|8|向上|0.000／4.000／9.907／4.000|377.43|716.99|
|8|向下|0.000／4.000／9.914／4.000|172.39|716.99|

診斷表的「向上／向下」僅標記前端淨轉角+180°／−180°，不表示整段維持單向曲率。重載下的診斷形狀可局部反彎、壓縮及回折；因此不能只按上線／下線的名稱判斷淨轉角。這些狀態均未滿足所要求的半圓與應力條件。

最大彎曲與油箱空間：

- 最大值條件採使用者確認的靜力平衡、無自碰撞、鋼芯低於205 MPa；是否能放入1600×830×300 mm另列，不以油箱尺寸截斷搜尋。
- 所有最大彎曲欄位都使用null／空白表示未找到合格解；各配置、四個方向的最低已找到應力診斷及四繩拉力另列，這些不是最大彎曲的成功值。
- 空間方向測試同時保留重力、四繩獨立作用、雙向彎曲、軸向變形及扭轉。沒有把側向問題直接當作無重力的垂直平面。directional正／負側向EI分別用0.0037／0.0030，uni-d側向EI用0.0057，垂直用0.061。
- 安裝方向沿用上一輪：uni-d／directional的論文+X方向對應機身右側，Y方向對應垂直。若實物安裝翻轉，directional左右剛度的對應需一併交換。
- 側向診斷同時保存相對界面的連續投影轉角與前端累積彎曲角。空間多軸姿態下二者不同，不將它們混寫為同一角度。
- 油箱檢查為實際中心線加32 mm膠囊包絡的軸向外包尺寸；不含入口、肋板、障礙物及接觸力。未找到合格最大狀態時，不能給出該最大狀態的油箱通過結果，CSV另列診斷形狀結果。

數值方法與解讀：

- 垂直目標以4單元／節搜尋，再保存8單元／節；另從8單元直接解及零載荷狀態逐步增加至500 g重試。上下／左右共同收緊模式獨立補查。
- 空間搜尋以每節2段常曲率／扭轉單元與Gauss積分，導孔仍只在真實48 mm模組端盤；代表保存狀態以相同固定繩長指令再加密至4，回報加密後張力與形狀的改變。上下／左右搜尋包含四繩共同收緊與側向時的上下偏置。控制網格見run_directional.py。
- 模組扭轉係數按craft_data標示的T/θ模組轉動剛度保存，細分後總模組剛度不變。鋼芯額外扭轉參考G=77 GPa（[製造商參考資料](https://www.htpipe.com/product-material/stainless-steel/304.html)），只用於空間扭轉，不更改原模組EI、EA或質量。
- 搜尋數值界限為每條主動拉力網格0–64 N、共同力與偏置見程式；軸向應變絕對值≤0.85、空間單元各旋轉分量≤1.5 rad。這些是明示的數值搜尋界限，不是材料額定力、容許應變或物理最大彎曲角。沒有證明完整控制域全域無解。
- 超過205 MPa的鋼芯結果是線彈性外推。程式不把應力截到205 MPa，也不宣稱已模擬塑性變形後的真實姿態。原論文線性EA下較大應變亦僅作診斷；5%是標示門檻，不是實測失效值。
- 繩索剛度與線密度沿用既有PA6實心材料代理值，仍未量測編織繩；繩索自重均布到機身，不求鬆繩懸鏈線。
- 最大值只在找到合格平衡後才有意義。這次合格集為空，不能把最後收斂角、最後掃描力或自碰撞前一格稱為合格最大值。

六項獨立力學檢查通過。已保存狀態回代146個，最大殘差1.1e-06。代表狀態加密中有3項過載診斷未找到加密後平衡，這些診斷不可作有效角度或拉力結論；已收斂加密狀態的最大頭部位置變化5.231 mm、應力變化0.870 MPa。所有未收斂項和原始數值保存在validation.json，沒有將其標成加密通過。

檔案：

- [全部垂直目標與鬆繩狀態](vertical_targets_and_free_sag.csv)
- [22配置、四方向最大彎曲結果](maximum_bending_by_configuration.csv)
- [空間四繩控制／角度／應力診斷](directional_force_sweep.csv)
- [全部11880次控制嘗試，含未收斂記錄](directional_all_attempts.csv)
- [原四個代表配置](reference_H8U12.csv)
- [0g與500g對比](free_sag_0g_vs_500g.csv)
- [載荷影響圖](payload_effect.png)
- [數值核對](validation.json)

- [5節負載形狀](front_05_loaded_shapes.png)、[5節四方向診斷](front_05_directional_diagnostics.png)
- [6節負載形狀](front_06_loaded_shapes.png)、[6節四方向診斷](front_06_directional_diagnostics.png)
- [7節負載形狀](front_07_loaded_shapes.png)、[7節四方向診斷](front_07_directional_diagnostics.png)
- [8節負載形狀](front_08_loaded_shapes.png)、[8節四方向診斷](front_08_directional_diagnostics.png)

材料／方法來源：[既有原論文模組數據](../inputs/craft_data.py)、[304額外剪切模數來源](https://www.htpipe.com/product-material/stainless-steel/304.html)、[幾何非線性索驅模型方法參考](https://yuan.mae.sustech.edu.cn/pdf/2022Li-acta-mechanics.pdf)。
