KevinQianjin/ASRC_snake_body_design/reach_extension_results/summary_by_length_front_core.csv

total_modules | reference_length_mm | flexible_front_modules | rear_modules | backbone_diameter_mm | tip_payload_g | combinations | converged | yield_screen_passes | yield_and_cross_section_passes | combined_screen_passes | reach_target_screen_passes | lightest_target_configuration | lightest_target_mass_g | lightest_target_tip_x_mm | lightest_target_drop_mm | max_reach_any_mm | max_reach_any_drop_mm | max_reach_any_stress_mpa | max_reach_any_configuration | max_reach_yield_screened_mm | max_reach_yield_screened_drop_mm | max_reach_yield_screened_stress_mpa | max_reach_yield_screened_configuration | max_reach_yield_and_cross_section_mm | max_reach_yield_and_cross_section_drop_mm | max_reach_yield_and_cross_section_stress_mpa | max_reach_yield_and_cross_section_configuration | max_reach_combined_screened_mm | max_reach_combined_screened_drop_mm | max_reach_combined_screened_stress_mpa | max_reach_combined_screened_configuration
31 | 1488 | 2 | 29 | 4.2 | 0.0 | 28 | 28 | 0 | 0 | 0 | 0 |  |  |  |  | 1447.3945155651734 | 322.97073824755125 | 256.73763796179526 | H1-U28-D1-L1
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
