KevinQianjin/ASRC_snake_body_design/ASRC_kevin/rope_results/backbone_properties.csv

material | label | young_modulus_gpa | yield_strength_mpa | density_kg_m3 | bending_rigidity_nm2 | first_yield_moment_nm | fully_plastic_moment_nm | first_yield_curvature_per_m | linear_mass_g_m
al1100_o | Al 1100-O | 69.0 | 20.0 | 2700.0 | 1.0539406394883248 | 0.14547144782447544 | 0.2469600000000001 | 0.1380262249827467 | 37.406943726293676
cu110_o60 | Cu C11000-O60 | 117.0 | 68.94757290000001 | 8910.0 | 1.787116736523681 | 0.5014951626873284 | 0.8513646301692005 | 0.28061690231990233 | 123.44291429676913
ss304_annealed | SS 304 annealed | 200.0 | 205.0 | 7900.0 | 3.054900404313985 | 1.4910823402008733 | 2.531340000000001 | 0.488095238095238 | 109.44994645841484
