KevinQianjin/ASRC_snake_body_design/ASRC_kevin/rope_results/comparison.csv

material | assembly_name | module_count | stage | ok | tip_x_mm | tip_y_mm | tip_z_mm | tip_drop_mm | transverse_tip_mm | residual_tip_mm | rope_control_mode | reference_length_mm | current_length_mm | total_mass_g | backbone_mass_g | rope_mass_g | max_joint_deg | max_axial_strain | dissipated_energy_j | moment_residual_nm | axial_force_residual_n | min_stability_eigenvalue | accepted_steps | warnings | tension_top_n | tension_right_n | tension_bottom_n | tension_left_n | take_up_top_mm | take_up_change_top_mm | take_up_right_mm | take_up_change_right_mm | take_up_bottom_mm | take_up_change_bottom_mm | take_up_left_mm | take_up_change_left_mm
modules_only | D | 31 | self_weight | True | 218.86593707320628 | -1418.4606823848983 | 0.0 | 1418.4606823848983 | 1418.4606823848983 |  | no_ropes | 1488.0000000000005 | 1488.0000000000005 | 130.70000000000002 | 0.0 | 0.0 | 22.676815858535846 | 0.0 | 0.0 | 7.758016173919913e-10 | 0.0 | 0.05058857311077139 | 16 |  | 0.0 | 0.0 | 0.0 | 0.0
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
