KevinQianjin/ASRC_snake_body_design/ASRC_kevin/rope_results_level/control_trace.csv

material | iteration | trial_count | objective_error_mm | tip_x_mm | tip_y_mm | tip_z_mm | forward_ratio | tension_top_n | take_up_top_mm | tension_right_n | take_up_right_mm | tension_bottom_n | take_up_bottom_mm | tension_left_n | take_up_left_mm
al1100_o | 0 | 0 | 1839.7872757989255 | 190.40227562678862 | -1437.0389725635703 | 3.0702442205153047e-07 | 0.12795851856639015 | 40.00634023273842 | 0.0 | 0.0 | 0.0 | 0.0 | 0.0 | 0.0 | 0.0
al1100_o | 1 | 12 | 1829.3344598702179 | 200.48874295891773 | -1431.7126943477797 | -8.652045423304397e-07 | 0.13473705844013284 | 45.49805302582362 | 1.9999999999999998 | 0.0 | -1.9999999999999998 | 0.0 | 0.0 | 0.0 | -1.9999999999999998
al1100_o | 2 | 26 | 1819.0839692511543 | 208.224731905282 | -1424.7671494474505 | 3.576144093305988e-06 | 0.139935975742797 | 49.62783448496473 | 3.9999999999999996 | 0.0 | -1.8655500919299812 | 0.0 | 0.1344499080700665 | 0.0 | -1.8655500919299812
al1100_o | 3 | 40 | 1808.4060348427959 | 214.91210457037008 | -1416.4424150124335 | 2.5735145148506522e-05 | 0.144430177802668 | 53.16331771115849 | 5.999999999999999 | 0.0 | -1.8655500919299812 | 0.0 | 0.1344499080700665 | 0.0 | -1.8655500919299812
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
