KevinQianjin/ASRC_snake_body_design/simulations/u4m2/lanes_20261113/guided_validation_20261114/baseline/path_audit/path_checks.csv

archive | state | phase | maximum_hole_force_n | maximum_station_force_n | flexure_clearance_bound_mm | flexure_screen_pass | end_region_centerline_points_inside | maximum_end_region_center_penetration_mm
guided_validation_20261114/baseline/inverse/startup_niti18_E40_p20_pre3_states.npz | k0_z8 | inverse | 0.6219143508104642 | 4.95382741345504 | 5.393381732024442 | True | 0 | 0.0
guided_validation_20261114/baseline/inverse/startup_niti18_E40_p20_pre3_states.npz | k1_z8 | inverse | 0.7309640655073316 | 5.084604321068982 | 5.411433167482591 | True | 0 | 0.0
guided_validation_20261114/baseline/inverse/startup_niti18_E40_p20_pre3_states.npz | k2_z8 | inverse | 0.8338588795743215 | 5.201098957046313 | 5.429918754316179 | True | 0 | 0.0
guided_validation_20261114/baseline/inverse/startup_niti18_E40_p20_pre3_states.npz | k3_z8 | inverse | 0.928511743221092 | 5.300793813882193 | 5.448495987798639 | True | 0 | 0.0
guided_validation_20261114/baseline/inverse/startup_niti18_E40_p20_pre3_states.npz | k4_z8 | inverse | 1.014993481307623 | 5.383830316241411 | 5.467164587141185 | True | 0 | 0.0
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
