KevinQianjin/ASRC_snake_body_design/simulations/u4m2/lanes_20261113/guided_validation_20261114/candidate/closed_loop/nominal.csv

index | phase | kind | clamp_s_mm | node_move_mm | operating_tension_pass | yaw_deg | elevation_deg | yaw_error_deg | elevation_error_deg | minimum_tension_n | peak_tension_n | clearance_mm | minimum_eigenvalue | geometry_pass | strain | residual | checks_pass | target_yaw_deg | target_elevation_deg | iterations | precompensation_mm | correction_scale | a4_up_offset_mm | a4_up_tension_n | a4_right_offset_mm | a4_right_tension_n | a4_down_offset_mm | a4_down_tension_n | a4_left_offset_mm | a4_left_tension_n | a5_up_offset_mm | a5_up_tension_n | a5_right_offset_mm | a5_right_tension_n | a5_down_offset_mm | a5_down_tension_n | a5_left_offset_mm | a5_left_tension_n | a6_up_offset_mm | a6_up_tension_n | a6_right_offset_mm | a6_right_tension_n | a6_down_offset_mm | a6_down_tension_n | a6_left_offset_mm | a6_left_tension_n
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
