KevinQianjin/ASRC_snake_body_design/simulations/u4m2/lanes_20261113/guided_validation_20261114/candidate/path_audit/path_checks.csv

archive | state | phase | maximum_hole_force_n | maximum_station_force_n | flexure_clearance_bound_mm | flexure_screen_pass | end_region_centerline_points_inside | maximum_end_region_center_penetration_mm
guided_validation_20261114/candidate/inverse/startup_niti18_E40_p20_pre3_states.npz | k0_z8 | inverse | 0.6344747079399926 | 5.0519502412417845 | 5.375596824807262 | True | 0 | 0.0
guided_validation_20261114/candidate/inverse/startup_niti18_E40_p20_pre3_states.npz | k1_z8 | inverse | 0.6684430956009965 | 5.094061577127222 | 5.380928864425689 | True | 0 | 0.0
guided_validation_20261114/candidate/inverse/startup_niti18_E40_p20_pre3_states.npz | k2_z8 | inverse | 0.7780195475964615 | 5.225538853607934 | 5.399048040726301 | True | 0 | 0.0
guided_validation_20261114/candidate/inverse/startup_niti18_E40_p20_pre3_states.npz | k3_z8 | inverse | 0.8795272046730429 | 5.34054804573627 | 5.417261896941256 | True | 0 | 0.0
guided_validation_20261114/candidate/inverse/startup_niti18_E40_p20_pre3_states.npz | k4_z8 | inverse | 0.9730204732643054 | 5.439196754049153 | 5.435570417230261 | True | 0 | 0.0
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
