KevinQianjin/ASRC_snake_body_design/simulations/u4m2/lanes_20261113/guided_validation_20261114/candidate/reference/nominal.csv

index | phase | status | target_yaw_deg | clamp_s_mm | yaw_deg | yaw_error_deg | elevation_deg | head_x_mm | head_y_mm | head_z_mm | clearance_mm | clearance_margin_mm | geometry_pass | self_clearance_mm | strain | eigenvalue | stable | residual | min_tension_n | peak_tension_n | max_point_step_mm | checks_pass | a4_up_rest_mm | a4_up_pull_mm | a4_up_tension_n | a4_right_rest_mm | a4_right_pull_mm | a4_right_tension_n | a4_down_rest_mm | a4_down_pull_mm | a4_down_tension_n | a4_left_rest_mm | a4_left_pull_mm | a4_left_tension_n | a5_up_rest_mm | a5_up_pull_mm | a5_up_tension_n | a5_right_rest_mm | a5_right_pull_mm | a5_right_tension_n | a5_down_rest_mm | a5_down_pull_mm | a5_down_tension_n | a5_left_rest_mm | a5_left_pull_mm | a5_left_tension_n | a6_up_rest_mm | a6_up_pull_mm | a6_up_tension_n | a6_right_rest_mm | a6_right_pull_mm | a6_right_tension_n | a6_down_rest_mm | a6_down_pull_mm | a6_down_tension_n | a6_left_rest_mm | a6_left_pull_mm | a6_left_tension_n
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
