KevinQianjin/ASRC_snake_body_design/simulations/u4m2/lanes_20261113/guided_validation_20261114/diagnostics/baseline_partial_hold_audit/path_checks.csv

archive | state | phase | maximum_hole_force_n | maximum_station_force_n | flexure_clearance_bound_mm | flexure_screen_pass
results_lanes_guides_24mm/startup_niti18_E40_p20_pre3_states.npz | k0_z8 | inverse | 0.6219143508104642 | 4.95382741345504 | 5.393381732024442 | True
results_lanes_guides_24mm/startup_niti18_E40_p20_pre3_states.npz | k1_z8 | inverse | 0.7309640655073316 | 5.084604321068982 | 5.411433167482591 | True
results_lanes_guides_24mm/startup_niti18_E40_p20_pre3_states.npz | k2_z8 | inverse | 0.8338588795743215 | 5.201098957046313 | 5.429918754316179 | True
results_lanes_guides_24mm/startup_niti18_E40_p20_pre3_states.npz | k3_z8 | inverse | 0.928511743221092 | 5.300793813882193 | 5.448495987798639 | True
results_lanes_guides_24mm/startup_niti18_E40_p20_pre3_states.npz | k4_z8 | inverse | 1.014993481307623 | 5.383830316241411 | 5.467164587141185 | True
results_lanes_guides_24mm/startup_niti18_E40_p20_pre3_states.npz | k5_z8 | inverse | 1.093383754520071 | 5.450367700036081 | 5.485924217955322 | True
results_lanes_guides_24mm/startup_niti18_E40_p20_pre3_states.npz | k6_z8 | inverse | 1.16377100376465 | 5.500582905867906 | 5.504774491997351 | True
results_lanes_guides_24mm/startup_niti18_E40_p20_pre3_states.npz | k7_z8 | inverse | 1.2262523795323579 | 5.53467044328069 | 5.52371496679303 | True
results_lanes_guides_24mm/startup_niti18_E40_p20_pre3_states.npz | k8_z8 | inverse | 1.2809336559176625 | 5.5528422254125545 | 5.542745145093731 | True
results_lanes_guides_24mm/startup_niti18_E40_p20_pre3_states.npz | k9_z8 | inverse | 1.3279291290321087 | 5.55532737380121 | 5.561864474103759 | True
results_lanes_guides_24mm/startup_niti18_E40_p20_pre3_states.npz | k10_z8 | inverse | 1.3673614996230685 | 5.542371993297034 | 5.581072344406498 | True
results_lanes_guides_24mm/startup_niti18_E40_p20_pre3_states.npz | k11_z8 | inverse | 1.3993617397978944 | 5.5142389172938975 | 5.60036808849882 | True
results_lanes_guides_24mm/startup_niti18_E40_p20_pre3_states.npz | k12_z8 | inverse | 1.4240689438628058 | 5.471207423798146 | 5.61950891023228 | True
results_lanes_guides_24mm/startup_niti18_E40_p20_pre3_states.npz | k13_z8 | inverse | 1.4416301634235802 | 5.413572923246422 | 5.638652029290905 | True
results_lanes_guides_24mm/startup_niti18_E40_p20_pre3_states.npz | k14_z8 | inverse | 1.4522002270630223 | 5.341646619456748 | 5.657880290874372 | True
results_lanes_guides_24mm/startup_niti18_E40_p20_pre3_states.npz | k15_z8 | inverse | 1.4559415451196953 | 5.25575514569169 | 5.677192787273069 | True
results_lanes_guides_24mm/startup_niti18_E40_p20_pre3_states.npz | k16_z8 | inverse | 1.4530239003501335 | 5.156240178550076 | 5.696588535709106 | True
results_lanes_guides_24mm/startup_niti18_E40_p20_pre3_states.npz | k17_z8 | inverse | 1.4436242255807168 | 5.04345803332639 | 5.716066471230006 | True
results_lanes_guides_24mm/startup_niti18_E40_p20_pre3_states.npz | k18_z8 | inverse | 1.4279263698595095 | 4.917779245641771 | 5.73562543768982 | True
results_lanes_guides_24mm/startup_niti18_E40_p20_pre3_states.npz | k19_z8 | inverse | 1.406120855130889 | 4.779588145630127 | 5.755264176340716 | True
results_lanes_guides_24mm/startup_niti18_E40_p20_pre3_states.npz | k20_z8 | inverse | 1.37840462610645 | 4.629282432848546 | 5.774933715673096 | True
results_lanes_guides_24mm/startup_niti18_E40_p20_pre3_states.npz | k21_z8 | inverse | 1.3449807968491385 | 4.467272762544828 | 5.794406024467609 | True
results_lanes_guides_24mm/startup_niti18_E40_p20_pre3_states.npz | k22_z8 | inverse | 1.306058398674608 | 4.293982357091276 | 5.813929655224567 | True
results_lanes_guides_24mm/startup_niti18_E40_p20_pre3_states.npz | k23_z8 | inverse | 1.2618521354083512 | 4.109846660608297 | 5.833526573420022 | True
results_lanes_guides_24mm/startup_niti18_E40_p20_pre3_states.npz | k24_z8 | inverse | 1.2125821539392878 | 3.9153130604056847 | 5.853194737667094 | True
results_lanes_guides_24mm/startup_niti18_E40_p20_pre3_states.npz | k25_z8 | inverse | 1.1584738405622073 | 3.7108407064042273 | 5.872828920626454 | True
results_lanes_guides_24mm/startup_niti18_E40_p20_pre3_states.npz | k26_z8 | inverse | 1.0997576570696412 | 3.4969004699665205 | 5.892121943116485 | True
results_lanes_guides_24mm/startup_niti18_E40_p20_pre3_states.npz | k27_z8 | inverse | 1.044385923177559 | 3.2739750976970954 | 5.911372586278002 | True
results_lanes_guides_24mm/minforce_niti18_E40_p20_a456_pre3_exact_smooth1_fromstartup_tol1_states.npz | y0_z8 | inverse | 1.0401818617313283 | 3.287257318112723 | 5.910166965015101 | True
results_lanes_guides_24mm/minforce_niti18_E40_p20_a456_pre3_exact_smooth1_fromstartup_tol1_states.npz | y5_z8 | inverse | 1.0426285849700523 | 3.3296069192607267 | 5.8919634733666095 | True
results_lanes_guides_24mm/minforce_niti18_E40_p20_a456_pre3_exact_smooth1_fromstartup_tol1_states.npz | y10_z8 | inverse | 1.0526875248720762 | 3.429154283864586 | 5.87696145237148 | True
results_lanes_guides_24mm/minforce_niti18_E40_p20_a456_pre3_exact_smooth1_fromstartup_tol1_states.npz | y15_z8 | inverse | 1.0753311241972014 | 3.6089467495199274 | 5.865012516868351 | True
results_lanes_guides_24mm/minforce_niti18_E40_p20_a456_pre3_exact_smooth1_fromstartup_tol1_states.npz | y20_z8 | inverse | 1.1141267929334724 | 3.882999205749168 | 5.8600939483528105 | True
results_lanes_guides_24mm/minforce_niti18_E40_p20_a456_pre3_exact_smooth1_fromstartup_tol1_states.npz | y25_z8 | inverse | 1.1710256004643298 | 4.257183298570566 | 5.814203431231936 | True
results_lanes_guides_24mm/minforce_niti18_E40_p20_a456_pre3_exact_smooth1_fromstartup_tol1_states.npz | y30_z8 | inverse | 1.2729890832866033 | 4.971708082514501 | 5.7639644554859295 | True
results_lanes_guides_24mm/minforce_niti18_E40_p20_a456_pre3_exact_smooth1_fromstartup_tol1_states.npz | y35_z8 | inverse | 1.359541633921998 | 5.5191660583000735 | 5.729511900267494 | True
results_lanes_guides_24mm/minforce_niti18_E40_p20_a456_pre3_exact_smooth1_fromstartup_tol1_states.npz | y40_z8 | inverse | 1.4524573278368949 | 6.094496589899845 | 5.70510441640881 | True
results_lanes_guides_24mm/minforce_niti18_E40_p20_a456_pre3_exact_smooth1_fromstartup_tol1_states.npz | y45_z8 | inverse | 1.548678825116274 | 6.6744084146347875 | 5.686633516881215 | True
results_lanes_guides_24mm/minforce_niti18_E40_p20_a456_pre3_exact_smooth1_fromstartup_tol1_states.npz | y50_z8 | inverse | 1.6459417030250605 | 7.238588414074122 | 5.675843251062648 | True
results_lanes_guides_24mm/minforce_niti18_E40_p20_a456_pre3_exact_smooth1_fromstartup_tol1_states.npz | y55_z8 | inverse | 1.7811766876255684 | 7.778131624057601 | 5.648294592711735 | True
results_lanes_guides_24mm/minforce_niti18_E40_p20_a456_pre3_exact_smooth1_fromstartup_tol1_states.npz | y60_z8 | inverse | 1.940872621706424 | 8.498969795028055 | 5.601321136782219 | True
results_lanes_guides_24mm/minforce_niti18_E40_p20_a456_pre3_exact_smooth1_fromstartup_tol1_states.npz | y65_z8 | inverse | 2.1005448803538203 | 9.173431151249872 | 5.562074240210638 | True
results_lanes_guides_24mm/minforce_niti18_E40_p20_a456_pre3_exact_smooth1_fromstartup_tol1_states.npz | y70_z8 | inverse | 2.260514819565262 | 9.793159249237835 | 5.527445175046602 | True
results_lanes_guides_24mm/minforce_niti18_E40_p20_a456_pre3_exact_smooth1_fromstartup_tol1_states.npz | y75_z8 | inverse | 2.421120335074468 | 10.350773835616236 | 5.496222973014669 | True
results_lanes_guides_24mm/minforce_niti18_E40_p20_a456_pre3_exact_smooth1_fromstartup_tol1_states.npz | y80_z8 | inverse | 2.579988476649602 | 10.850726234705895 | 5.478813197265115 | True
results_lanes_guides_24mm/minforce_niti18_E40_p20_a456_pre3_exact_smooth1_fromstartup_tol1_states.npz | y85_z8 | inverse | 2.7342832006626403 | 11.35925356443293 | 5.4338216666395365 | True
results_lanes_guides_24mm/minforce_niti18_E40_p20_a456_pre3_exact_smooth1_fromstartup_tol1_states.npz | y90_z8 | inverse | 2.8902521478594365 | 11.876268393102674 | 5.389520561530831 | True
results_lanes_guides_24mm/minforce_niti18_E40_p20_a456_pre3_exact_smooth1_fromstartup_tol1_states.npz | y95_z8 | inverse | 3.052283216300849 | 12.42153441308615 | 5.347165526921073 | True
results_lanes_guides_24mm/minforce_niti18_E40_p20_a456_pre3_exact_smooth1_fromstartup_tol1_states.npz | y100_z8 | inverse | 3.225709896807146 | 13.026305419336882 | 5.309528128011061 | True
results_lanes_guides_24mm/minforce_niti18_E40_p20_a456_pre3_exact_smooth1_fromstartup_tol1_states.npz | y105_z8 | inverse | 3.415962832125538 | 13.728914294930263 | 5.273024496878392 | True
results_lanes_guides_24mm/minforce_niti18_E40_p20_a456_pre3_exact_smooth1_fromstartup_tol1_states.npz | y110_z8 | inverse | 3.6259593415600784 | 14.567915789985602 | 5.241476800332414 | True
results_lanes_guides_24mm/minforce_niti18_E40_p20_a456_pre3_exact_smooth1_fromstartup_tol1_states.npz | y115_z8 | inverse | 3.8479225521879563 | 15.693522443899 | 5.213396426913114 | True
results_lanes_guides_24mm/minforce_niti18_E40_p20_a456_pre3_exact_smooth1_fromstartup_tol1_states.npz | y120_z8 | inverse | 4.068419835931161 | 17.087995561832333 | 5.187122649508983 | True
results_lanes_guides_24mm/minforce_niti18_E40_p20_a456_pre3_exact_smooth1_fromstartup_tol1_states.npz | y125_z8 | inverse | 4.28459878797044 | 18.543343906322484 | 5.166388353525284 | True
results_lanes_guides_24mm/minforce_niti18_E40_p20_a456_pre3_exact_smooth1_fromstartup_tol1_states.npz | y130_z8 | inverse | 4.488845335581358 | 19.87413735223905 | 5.149916798773307 | True
results_lanes_guides_24mm/minforce_niti18_E40_p20_a456_pre3_exact_smooth1_fromstartup_tol1_states.npz | y135_z8 | inverse | 4.675924408759645 | 21.36897304083868 | 5.137617911262901 | True
results_lanes_guides_24mm/minforce_niti18_E40_p20_a456_pre3_exact_smooth1_fromstartup_tol1_states.npz | y140_z8 | inverse | 4.837609049569541 | 22.687451714737367 | 5.127558821971103 | True
results_lanes_guides_24mm/minforce_niti18_E40_p20_a456_pre3_exact_smooth1_fromstartup_tol1_states.npz | y145_z8 | inverse | 4.9647318977662005 | 23.929686359962858 | 5.103231526727869 | True
results_lanes_guides_24mm/minforce_niti18_E40_p20_a456_pre3_exact_smooth1_fromstartup_tol1_states.npz | y150_z8 | inverse | 5.0653657919356325 | 25.12284215316012 | 5.070187285021697 | True
results_lanes_guides_24mm/minforce_niti18_E40_p20_a456_pre3_exact_smooth1_fromstartup_tol1_states.npz | y155_z8 | inverse | 5.143645223083659 | 26.318885407954074 | 5.045268345554911 | True
results_lanes_guides_24mm/minforce_niti18_E40_p20_a456_pre3_exact_smooth1_fromstartup_tol1_states.npz | y160_z8 | inverse | 5.201100898883957 | 27.50361155427239 | 5.0256687984365565 | True
results_lanes_guides_24mm/minforce_niti18_E40_p20_a456_pre3_exact_smooth1_fromstartup_tol1_states.npz | y165_z8 | inverse | 5.238542608565858 | 28.63997152903795 | 5.011748857842642 | True
