KevinQianjin/ASRC_snake_body_design/ASRC_kevin/four_rope_inverse_5_to_11/results/coordinates/H8-U12-D4-L1_front_semicircle_down.csv

node | reference_s_mm | x_mm | y_mm | z_mm | pitch_deg | is_actual_disk | target_reached
0 | 0.0 | 0.0 | 0.0 | 0 | 0.0 | True | False
1 | 6.0 | 5.999988411926975 | -0.006990035931795765 | 0 | -0.1335000499497015 | False | False
2 | 12.0 | 11.999944562462364 | -0.027882346890870227 | 0 | -0.26551500090915664 | False | False
3 | 18.000000000000004 | 17.99983713715899 | -0.06252154982975681 | 0 | -0.39604953857064373 | False | False
4 | 24.0 | 23.999635885203094 | -0.11075268808744286 | 0 | -0.5251084052550617 | False | False
5 | 30.0 | 29.999311603010867 | -0.1724212420180318 | 0 | -0.6526963993796768 | False | False
6 | 36.00000000000001 | 35.99883611787065 | -0.24737313940382263 | 0 | -0.7788183749328489 | False | False
7 | 42.0 | 41.998182271634285 | -0.3354547656563338 | 0 | -0.9034792409556727 | False | False
8 | 48.0 | 47.99732390446119 | -0.43651297380879633 | 0 | -1.026683961030462 | True | False
9 | 54.0 | 53.99623582195832 | -0.5503959485883454 | 0 | -1.1484538715318713 | False | False
10 | 60.0 | 59.994893754353505 | -0.6769540681029376 | 0 | -1.2688103238151536 | False | False
11 | 66.0 | 65.9932743464235 | -0.8160390585885653 | 0 | -1.3877584402510101 | False | False
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
