KevinQianjin/ASRC_snake_body_design/ASRC_kevin/four_rope_inverse_5_to_11/results/coordinates/H8-U12-D4-L1_front_semicircle_up.csv

node | reference_s_mm | x_mm | y_mm | z_mm | pitch_deg | is_actual_disk | target_reached
0 | 0.0 | 0.0 | 0.0 | 0 | 0.0 | True | False
1 | 6.0 | 5.999988697301111 | -0.00659163408584618 | 0 | -0.12589112424190818 | False | False
2 | 12.0 | 11.999948722700832 | -0.02628873819162973 | 0 | -0.2502970086382904 | False | False
3 | 18.000000000000004 | 17.99985229693064 | -0.058935934497700536 | 0 | -0.37322237885166565 | False | False
4 | 24.0 | 23.99967264270306 | -0.10437828712974201 | 0 | -0.4946720188533969 | False | False
5 | 30.0 | 29.999383968504283 | -0.1624613124254766 | 0 | -0.6146507704100522 | False | False
6 | 36.00000000000001 | 35.998961452438365 | -0.23303098899827424 | 0 | -0.7331635325762746 | False | False
7 | 42.0 | 41.9983812261265 | -0.31593376760110287 | 0 | -0.8502152611940916 | False | False
8 | 48.0 | 47.997620358664626 | -0.41101658079425424 | 0 | -0.9658109683985981 | True | False
9 | 54.0 | 53.996656825229095 | -0.5181276927325756 | 0 | -1.0799717736302987 | False | False
10 | 60.0 | 59.99546946827901 | -0.637117550554058 | 0 | -1.1927188885952797 | False | False
11 | 66.0 | 65.99403798728173 | -0.7678379528439172 | 0 | -1.3040574895415595 | False | False
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
