KevinQianjin/ASRC_snake_body_design/ASRC_kevin/four_rope_inverse_5_to_11/results/coordinates/H8-U12-D4-L1_head_level.csv

node | reference_s_mm | x_mm | y_mm | z_mm | pitch_deg | is_actual_disk | target_reached
0 | 0.0 | 0.0 | 0.0 | 0 | 0.0 | True | True
1 | 6.0 | 5.999990593413498 | -0.006710512656365033 | 0 | -0.12816149868252977 | False | True
2 | 12.0 | 11.999951466823248 | -0.026764045624583763 | 0 | -0.2548338405594213 | False | True
3 | 18.000000000000004 | 17.99985381104623 | -0.06000487573333141 | 0 | -0.3800230879606399 | False | True
4 | 24.0 | 23.999669838420385 | -0.10627785767243406 | 0 | -0.5037353453004502 | False | True
5 | 30.0 | 29.99937276529535 | -0.16542843271687782 | 0 | -0.6259767585707118 | False | True
6 | 36.00000000000001 | 35.99893679462683 | -0.2373026372389948 | 0 | -0.7467535148425538 | False | True
7 | 42.0 | 41.998337098677105 | -0.32174711101304126 | 0 | -0.866071841776323 | False | True
8 | 48.0 | 47.99754980182424 | -0.418609105316351 | 0 | -0.9839380071396929 | True | True
9 | 54.0 | 53.996551952588355 | -0.5277370737690247 | 0 | -1.1003694535784692 | False | True
10 | 60.0 | 59.9953214904847 | -0.648981264223131 | 0 | -1.2153836886550076 | False | True
11 | 66.0 | 65.993837233101 | -0.7821931431293636 | 0 | -1.328987096723535 | False | True
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
