KevinQianjin/ASRC_snake_body_design/ASRC_kevin/four_rope_inverse_5_to_11/results/coordinates/H8-U12-D4-L2_front_semicircle_down.csv

node | reference_s_mm | x_mm | y_mm | z_mm | pitch_deg | is_actual_disk | target_reached
0 | 0.0 | 0.0 | 0.0 | 0 | 0.0 | True | False
1 | 6.0 | 5.999989304380449 | -0.007203004039161314 | 0 | -0.1375674228937777 | False | False
2 | 12.0 | 11.999944348387832 | -0.02873262236477758 | 0 | -0.2736193147425959 | False | False
3 | 18.000000000000004 | 17.999831867293537 | -0.06443031492080314 | 0 | -0.40816112915216196 | False | False
4 | 24.0 | 23.999619714251995 | -0.11413804158328844 | 0 | -0.5411983679653899 | False | False
5 | 30.0 | 29.999276842553574 | -0.17769827230049676 | 0 | -0.6727365807113526 | False | False
6 | 36.00000000000001 | 35.99877328795273 | -0.25495399700023585 | 0 | -0.802781364062743 | False | False
7 | 42.0 | 41.998080151074646 | -0.34574873526859035 | 0 | -0.9313383613017481 | False | False
8 | 48.0 | 47.997169579903606 | -0.4499265458042216 | 0 | -1.0584132617942428 | True | False
9 | 54.0 | 53.99601473816913 | -0.567332741285364 | 0 | -1.1840252798046127 | False | False
10 | 60.0 | 59.994589766980006 | -0.6978146011806658 | 0 | -1.3081936422795764 | False | False
11 | 66.0 | 65.99286977268255 | -0.8412206746276014 | 0 | -1.4309241725049862 | False | False
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
