KevinQianjin/ASRC_snake_body_design/ASRC_kevin/four_rope_inverse_5_to_11/results/coordinates/H8-U12-D4-L2_front_semicircle_up.csv

node | reference_s_mm | x_mm | y_mm | z_mm | pitch_deg | is_actual_disk | target_reached
0 | 0.0 | 0.0 | 0.0 | 0 | 0.0 | True | False
1 | 6.0 | 5.999989098000787 | -0.0069145869229296445 | 0 | -0.13205906407551588 | False | False
2 | 12.0 | 11.999946636753787 | -0.027579006762313344 | 0 | -0.2626035160780383 | False | False
3 | 18.000000000000004 | 17.99984201201311 | -0.06183481304523281 | 0 | -0.39163849153620733 | False | False
4 | 24.0 | 23.999645691593663 | -0.10952403500388332 | 0 | -0.5191691789109449 | False | False
5 | 30.0 | 29.99932919812249 | -0.1704891877949421 | 0 | -0.6452008190576972 | False | False
6 | 36.00000000000001 | 35.99886509185585 | -0.24457328249753427 | 0 | -0.7697387046964211 | False | False
7 | 42.0 | 41.998226953565464 | -0.3316198358937066 | 0 | -0.8927881798892291 | False | False
8 | 48.0 | 47.997389367497235 | -0.43147288003530765 | 0 | -1.014354639525611 | True | False
9 | 54.0 | 53.9963278897029 | -0.5439777347202385 | 0 | -1.1344581060349537 | False | False
10 | 60.0 | 59.99501900930929 | -0.6689817814138528 | 0 | -1.253118685952357 | False | False
11 | 66.0 | 65.99344013700745 | -0.8063337087739189 | 0 | -1.3703419221344368 | False | False
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
