KevinQianjin/ASRC_snake_body_design/ASRC_kevin/four_rope_inverse_5_to_11/results/front_06_reference_shapes.png

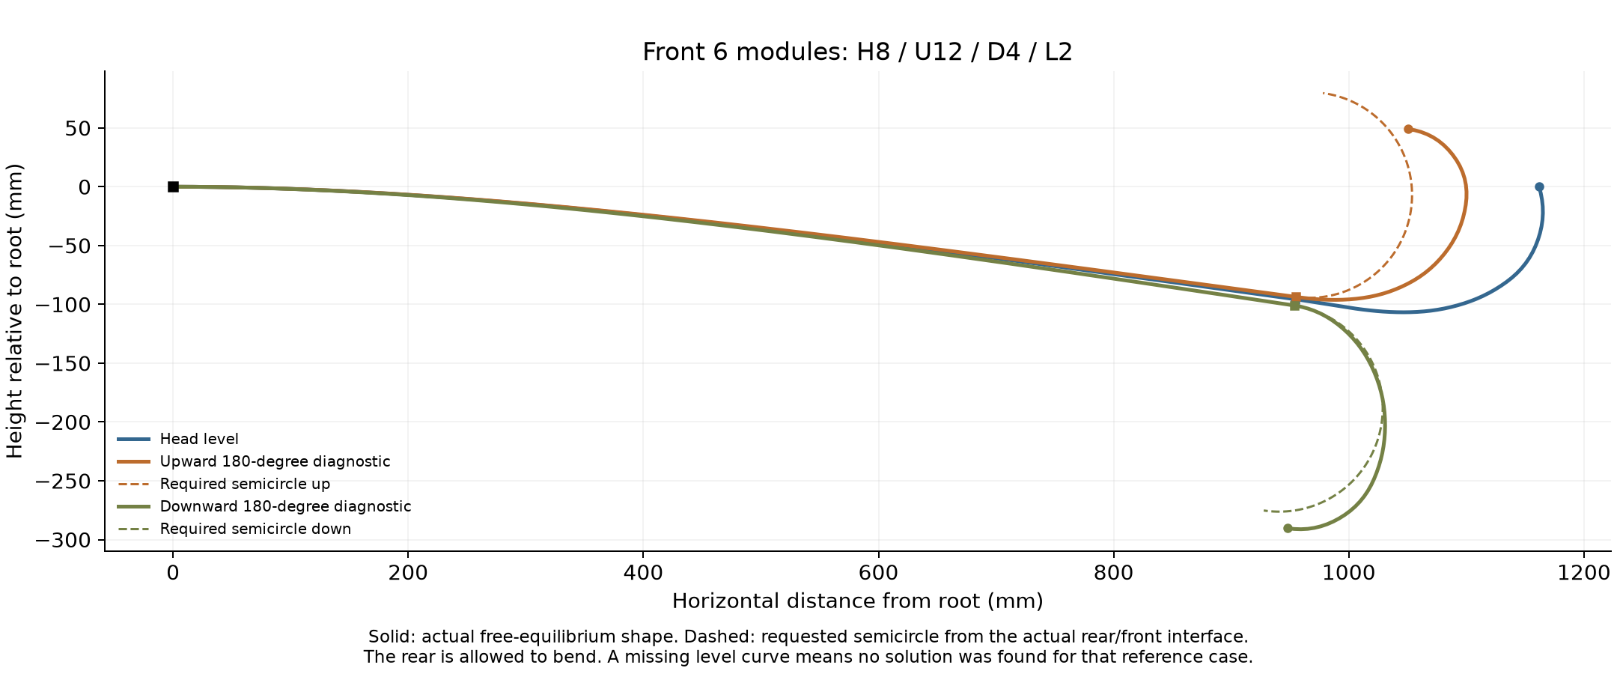
ASRC_kevin/four_rope_inverse_5_to_11/results/front_06_reference_shapes.png
