KevinQianjin/ASRC_snake_body_design/ASRC_kevin/four_rope_inverse_5_to_11/results/head_level_configuration_map.png

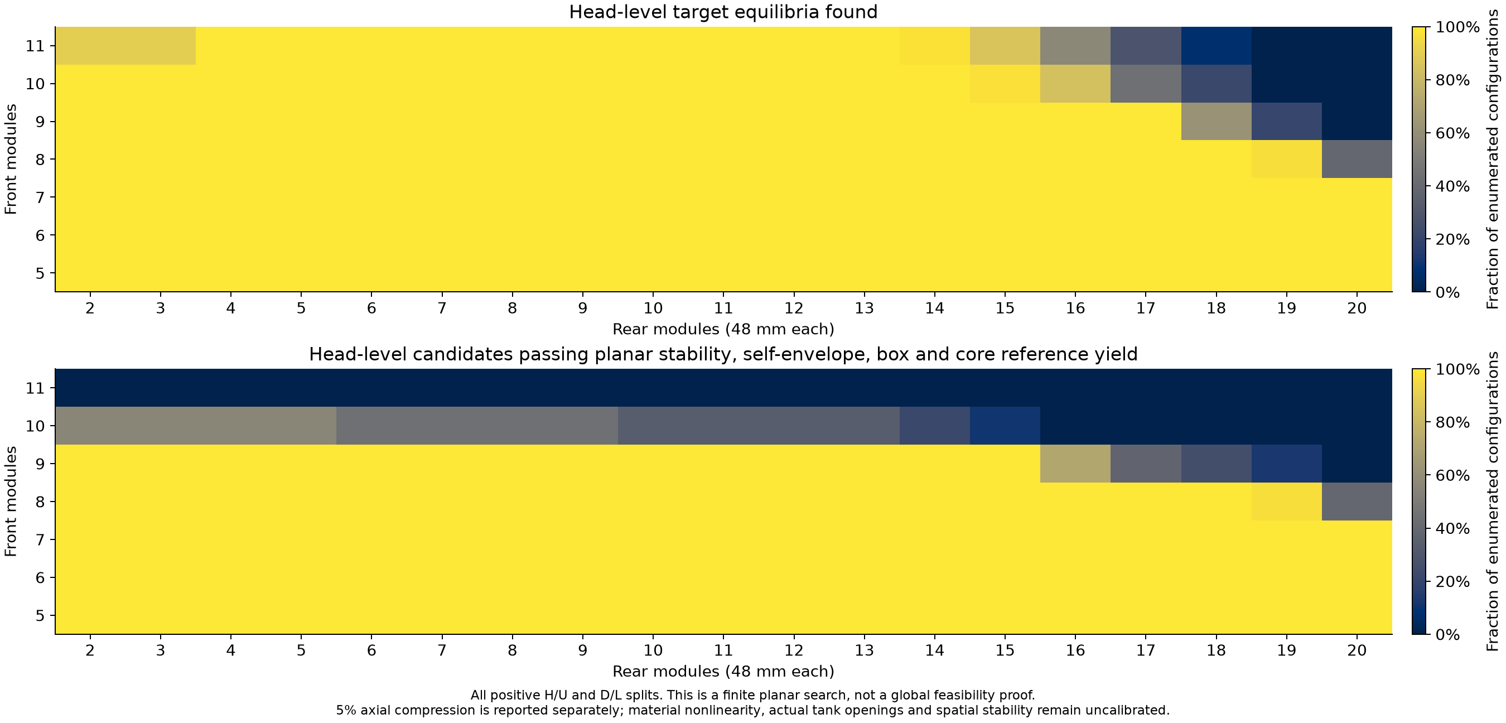
ASRC_kevin/four_rope_inverse_5_to_11/results/head_level_configuration_map.png
