KevinQianjin/ASRC_snake_body_design/ASRC_kevin/four_rope_inverse_5_to_11/results/reference_180_angle_diagnostic_forces.png

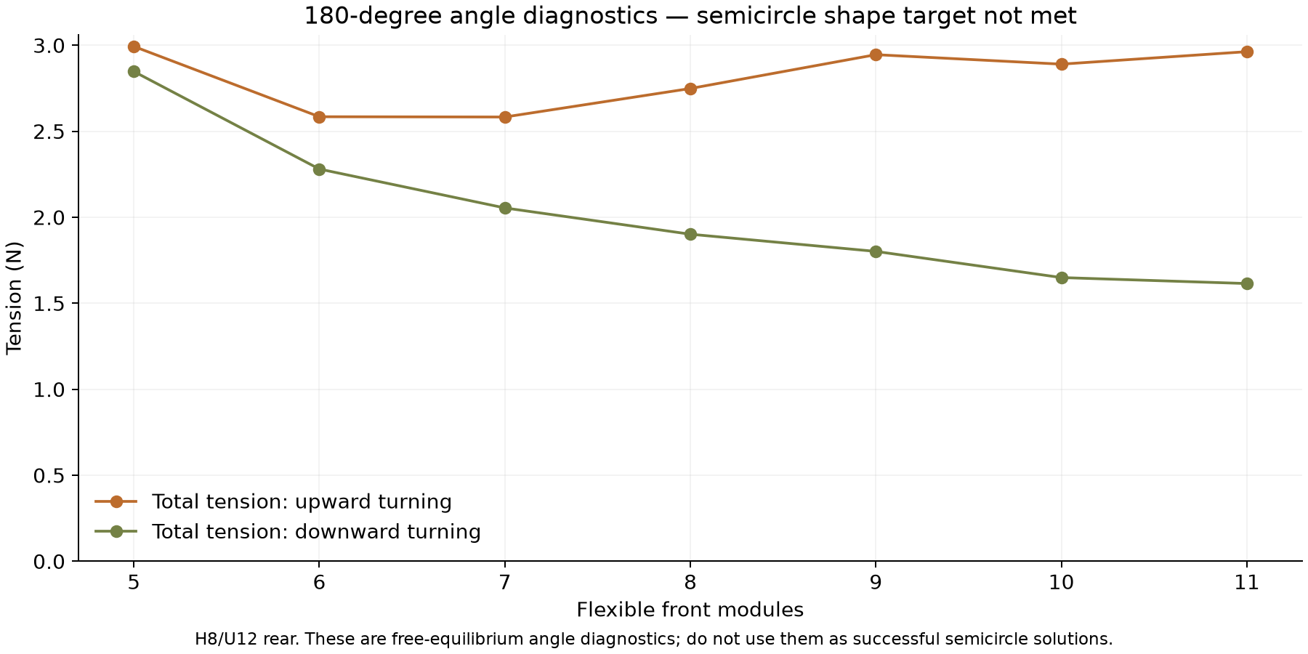
ASRC_kevin/four_rope_inverse_5_to_11/results/reference_180_angle_diagnostic_forces.png
