KevinQianjin/ASRC_snake_body_design/ASRC_kevin/four_rope_inverse_5_to_11/results/reference_force_and_circle_error.png

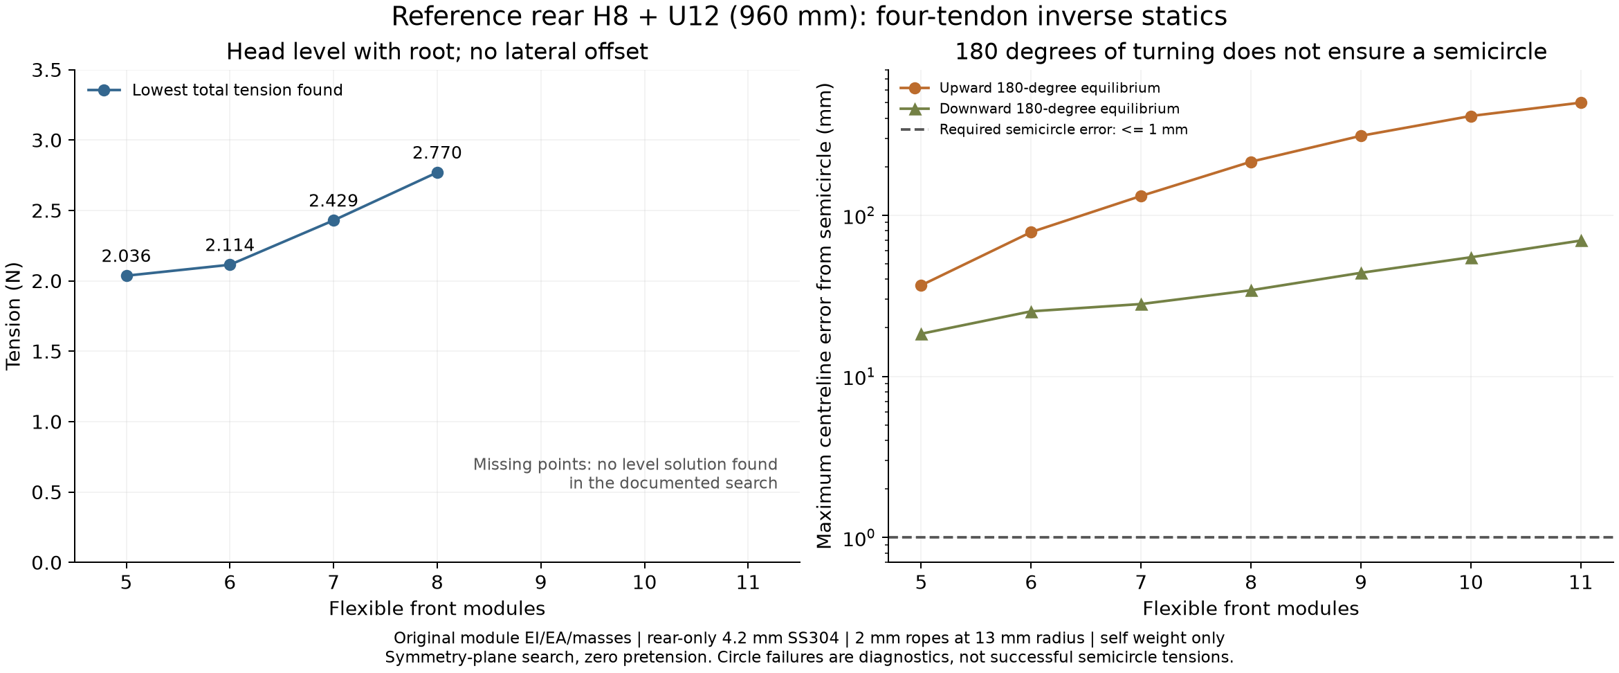
ASRC_kevin/four_rope_inverse_5_to_11/results/reference_force_and_circle_error.png
