KevinQianjin/ASRC_snake_body_design/ASRC_kevin/front_sweep_5_to_11/front_sweep_results/front_05/simulation_summary.png

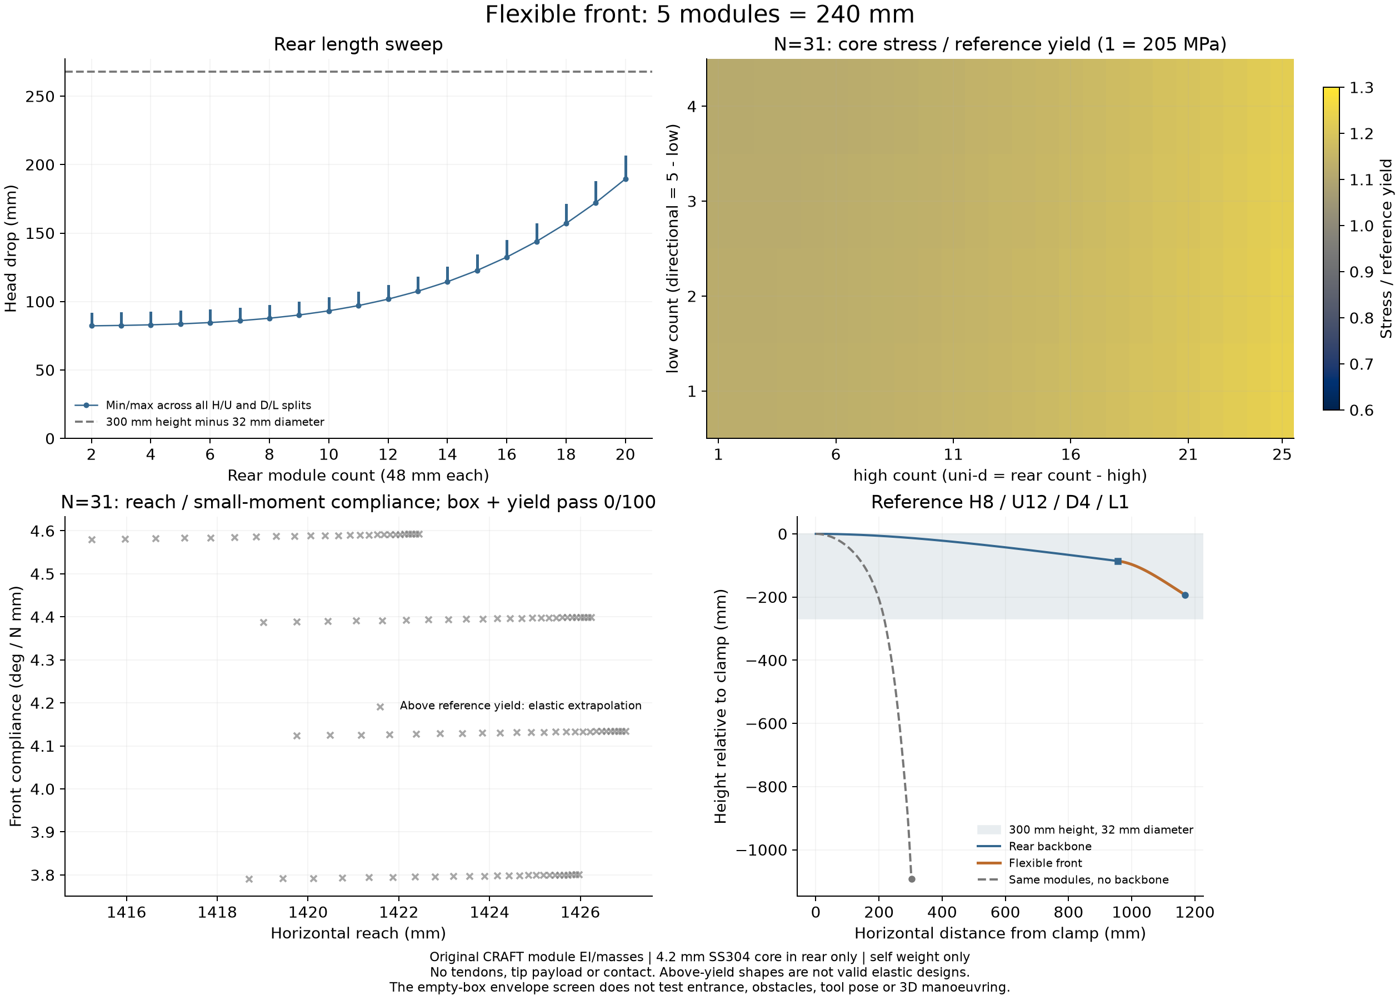
ASRC_kevin/front_sweep_5_to_11/front_sweep_results/front_05/simulation_summary.png
