KevinQianjin/ASRC_snake_body_design/ASRC_kevin/front_sweep_5_to_11/front_sweep_results/head_drop_vs_front_modules.png

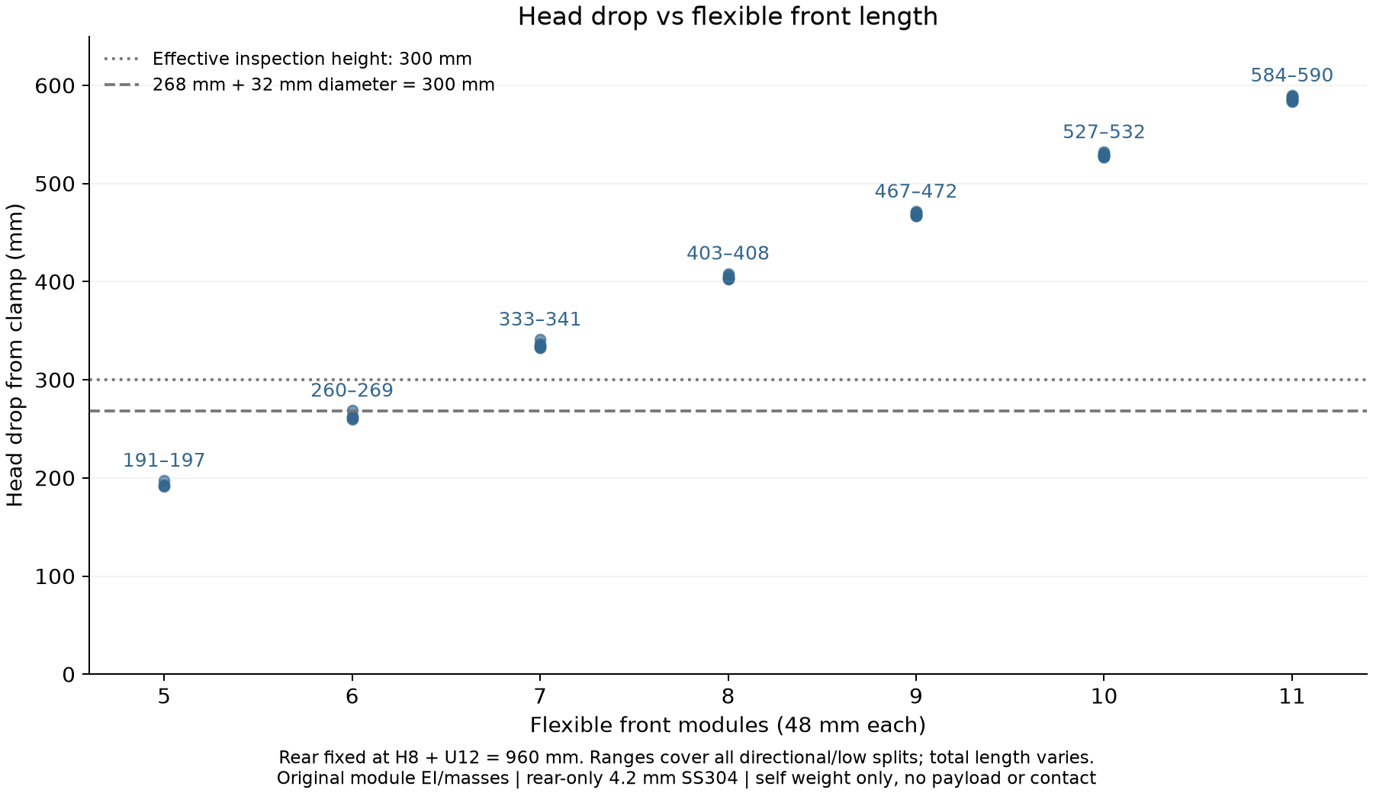
ASRC_kevin/front_sweep_5_to_11/front_sweep_results/head_drop_vs_front_modules.png
