KevinQianjin/ASRC_snake_body_design/ASRC_kevin/front_sweep_5_to_11/front_sweep_results/reference_shapes_5_to_11.png

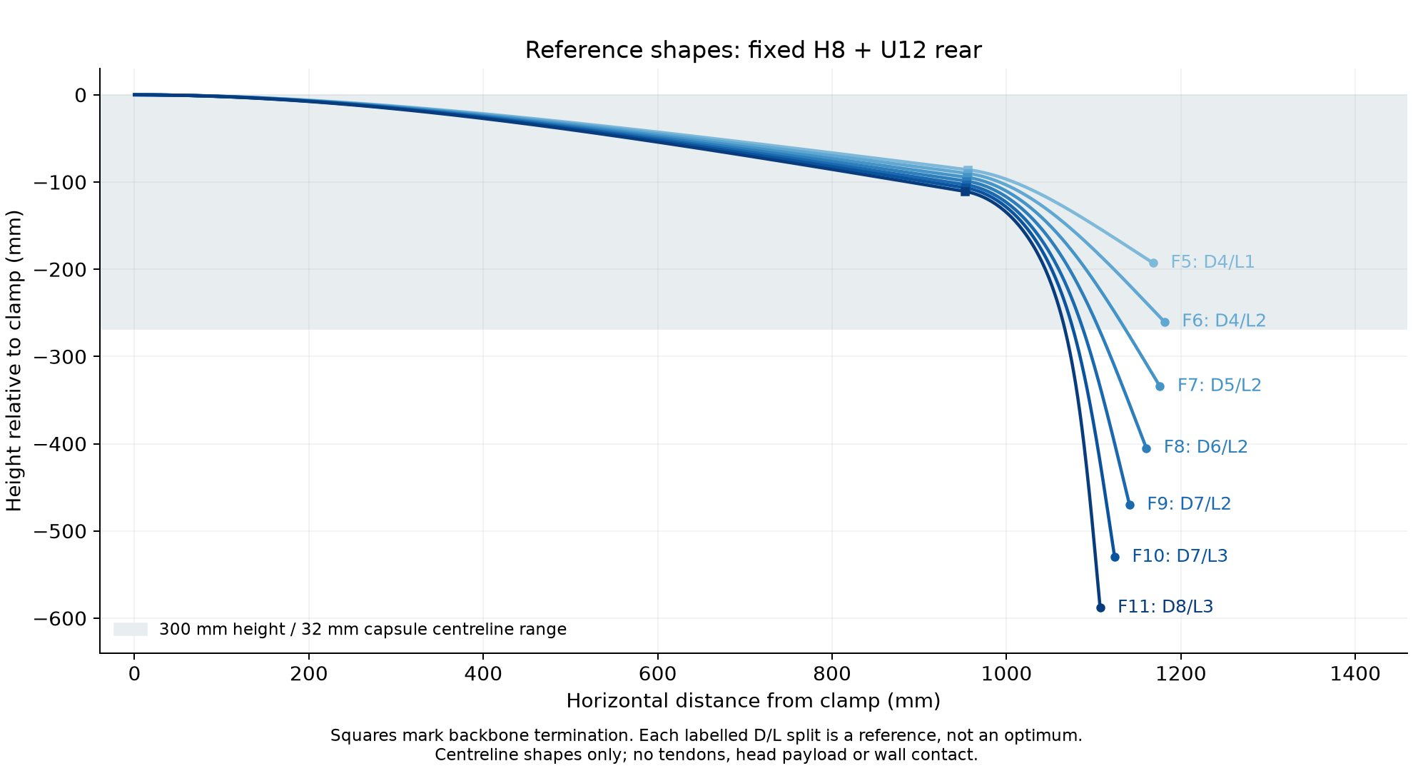
ASRC_kevin/front_sweep_5_to_11/front_sweep_results/reference_shapes_5_to_11.png
