KevinQianjin/ASRC_snake_body_design/ASRC_kevin/pla_sag_results/composition_heatmaps_N31.png

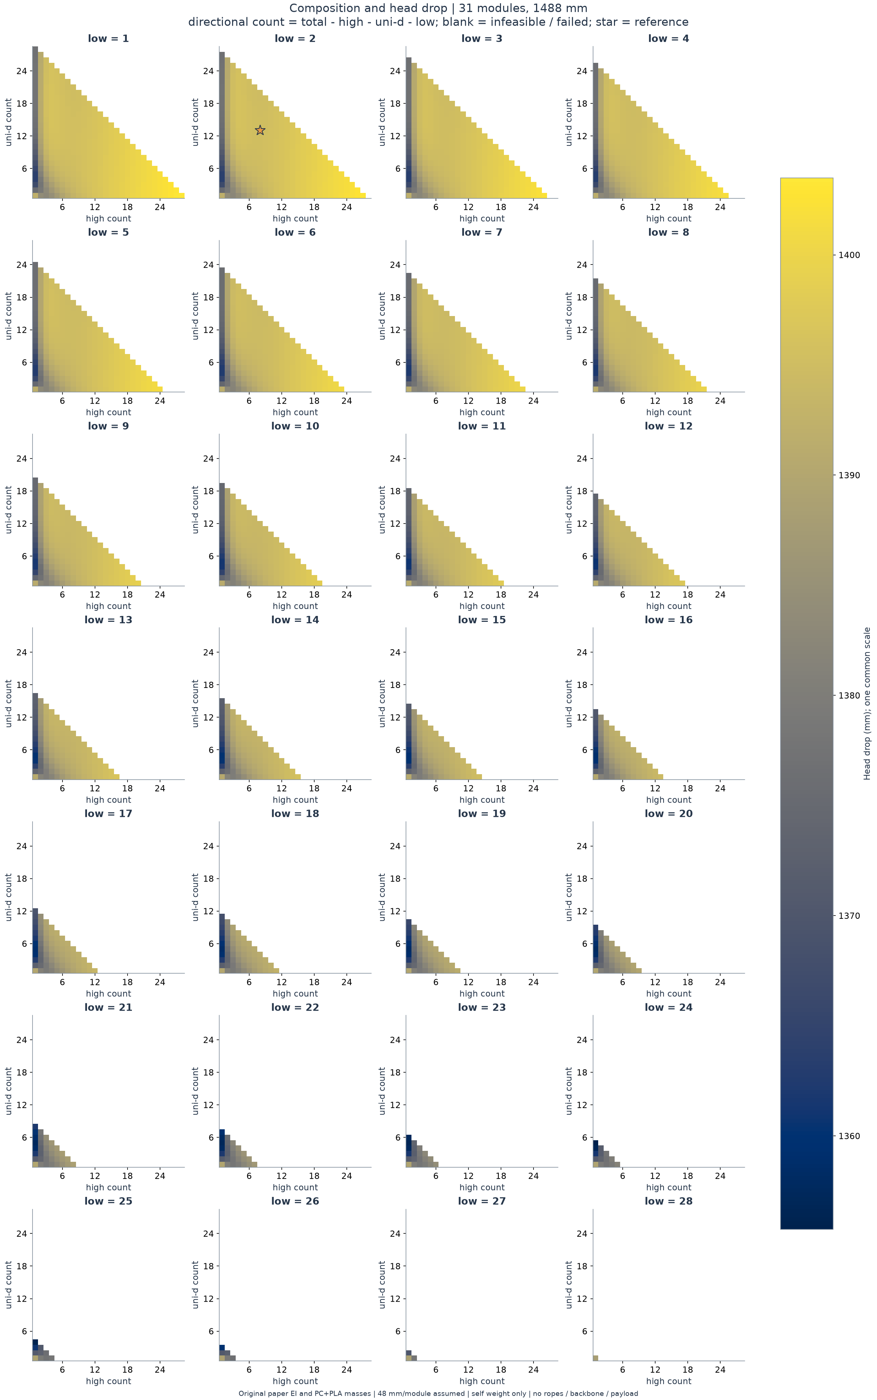
ASRC_kevin/pla_sag_results/composition_heatmaps_N31.png
