KevinQianjin/ASRC_snake_body_design/ASRC_kevin/pla_sag_results/composition_preview_N31.png

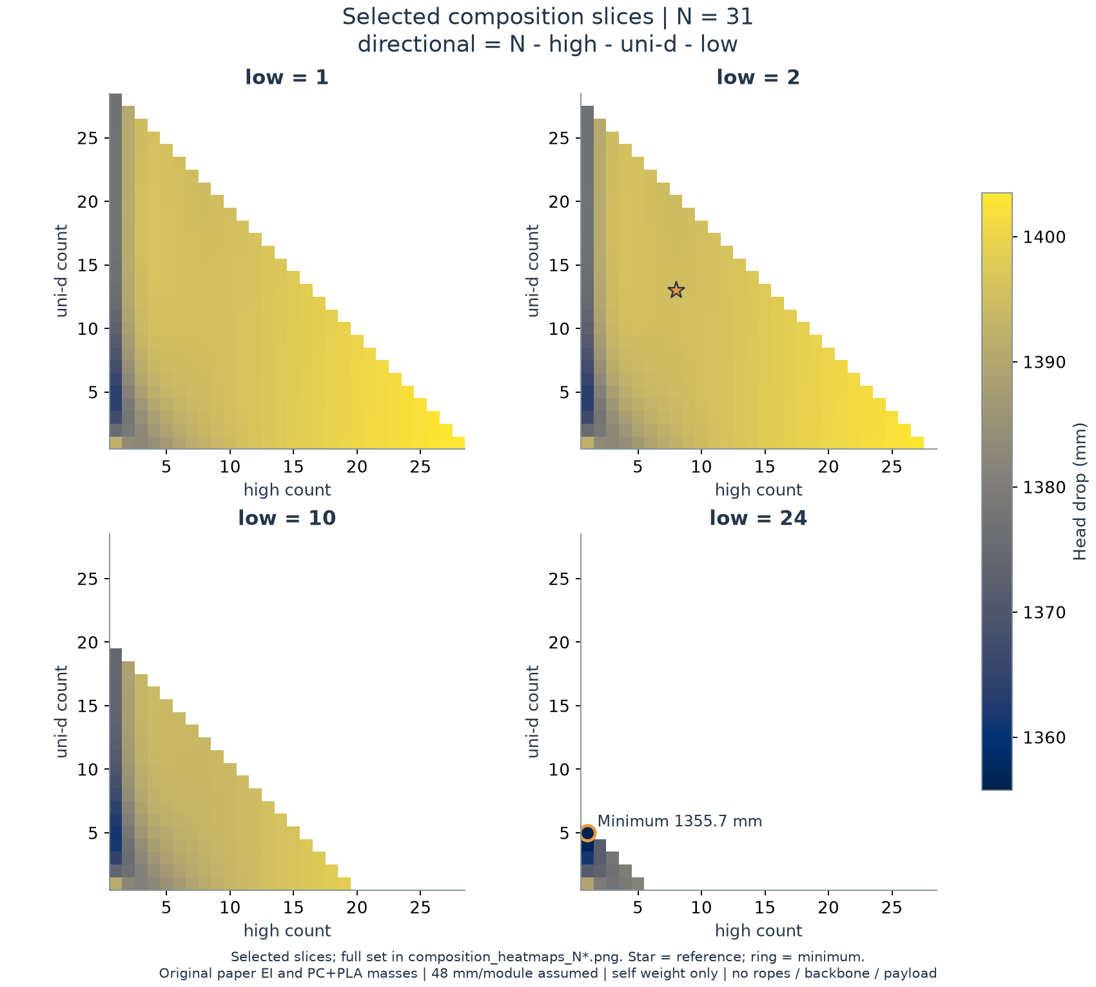
ASRC_kevin/pla_sag_results/composition_preview_N31.png
