KevinQianjin/ASRC_snake_body_design/ASRC_kevin/pla_sag_results/low_count_diagnostic.png

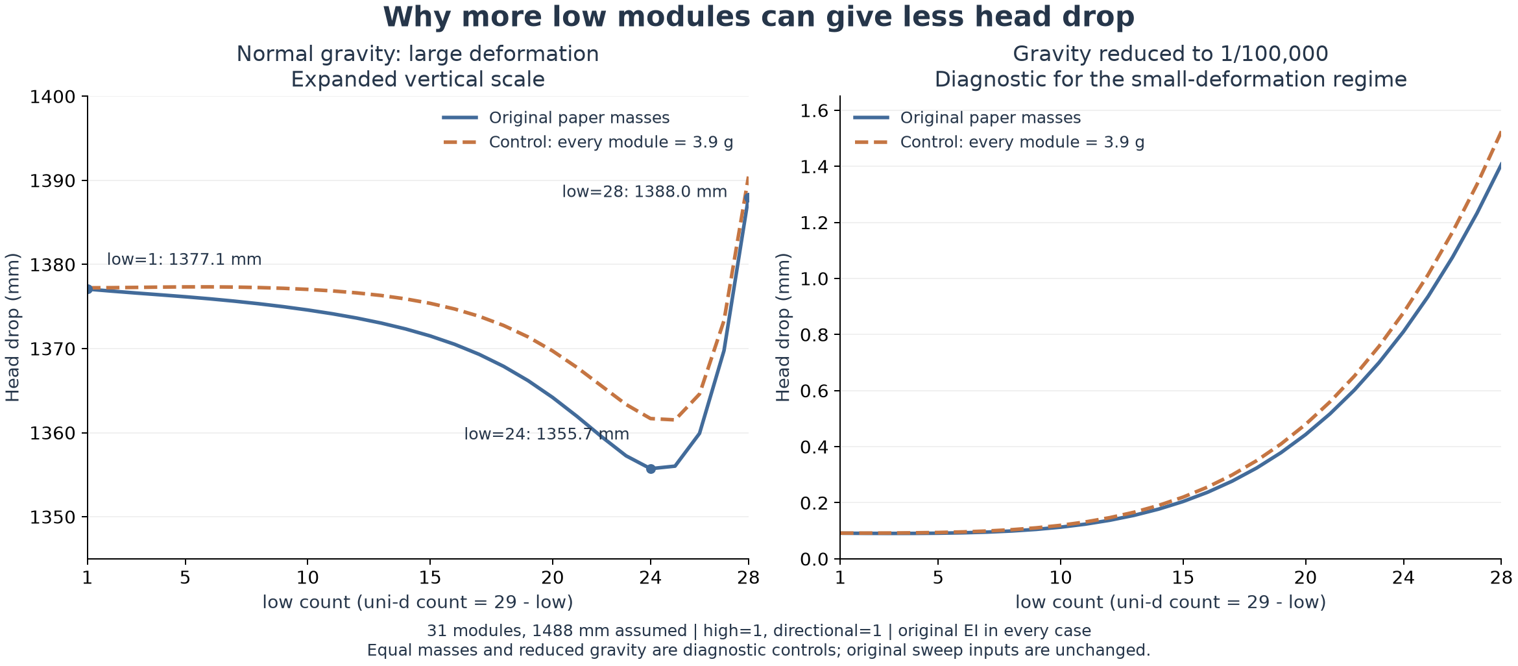
ASRC_kevin/pla_sag_results/low_count_diagnostic.png
