KevinQianjin/ASRC_snake_body_design/ASRC_kevin/pla_sag_results/representative_shapes.png

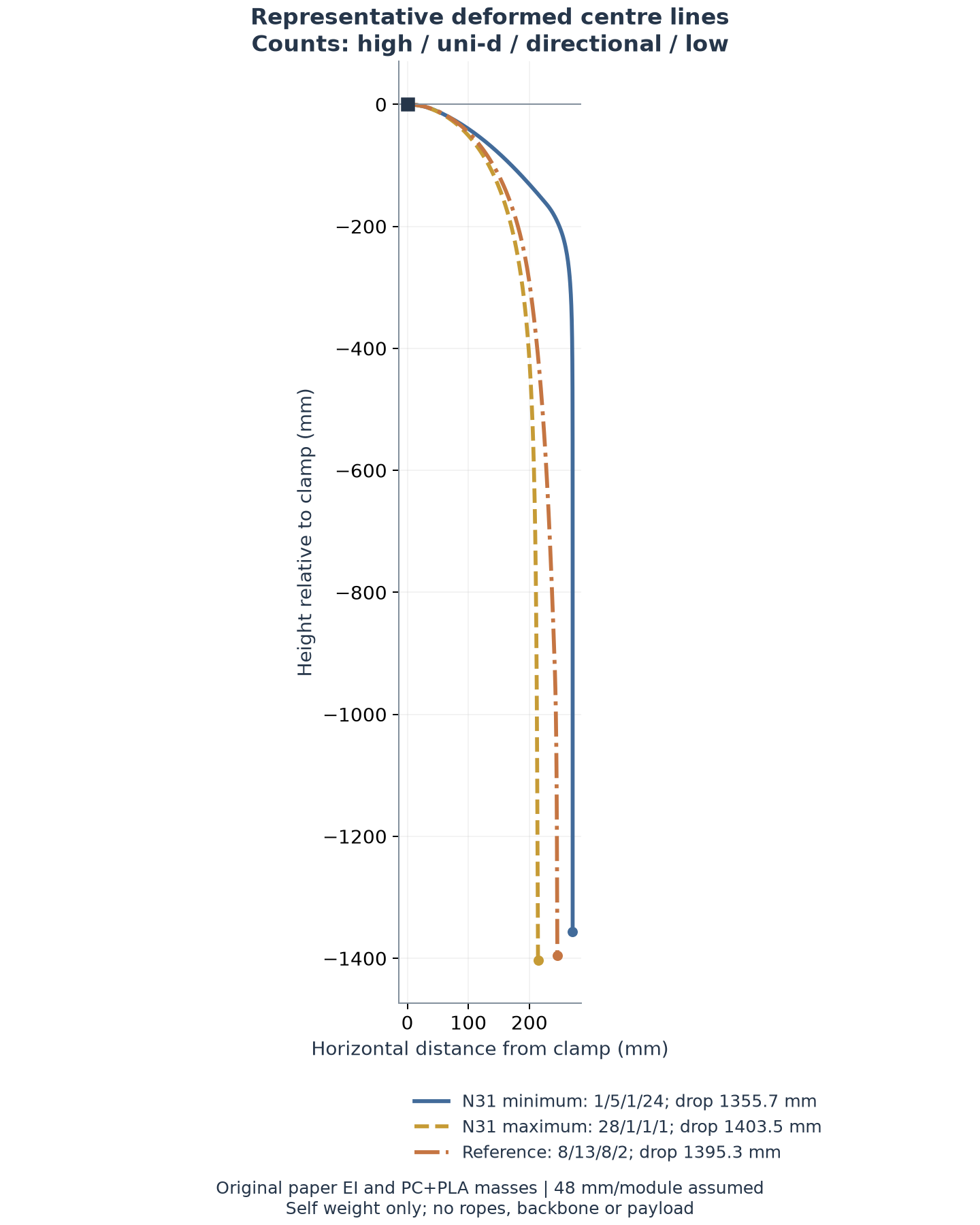
ASRC_kevin/pla_sag_results/representative_shapes.png
