KevinQianjin/ASRC_snake_body_design/ASRC_kevin/pla_sag_results/sag_vs_total.png

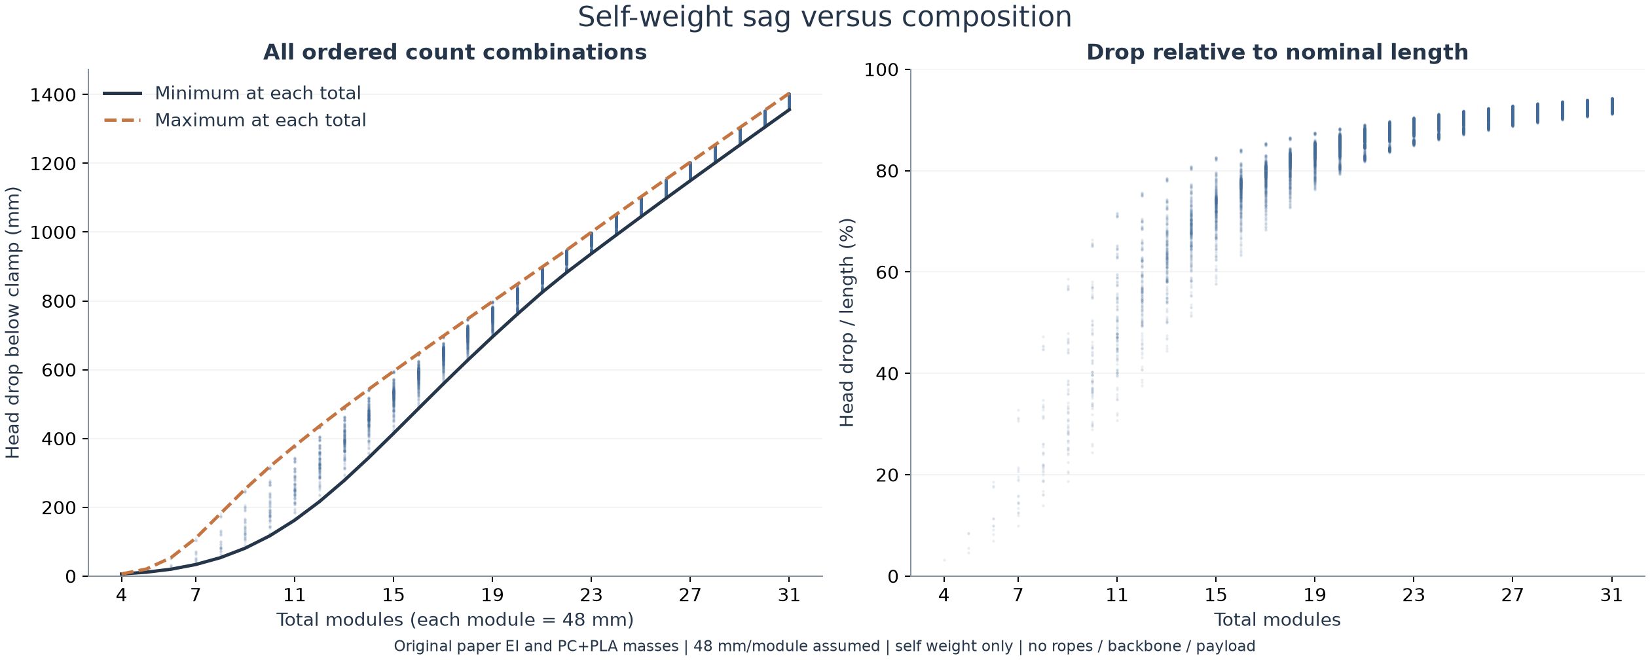
ASRC_kevin/pla_sag_results/sag_vs_total.png
