KevinQianjin/ASRC_snake_body_design/ASRC_kevin/rear_backbone_results/composition_and_flexibility.png

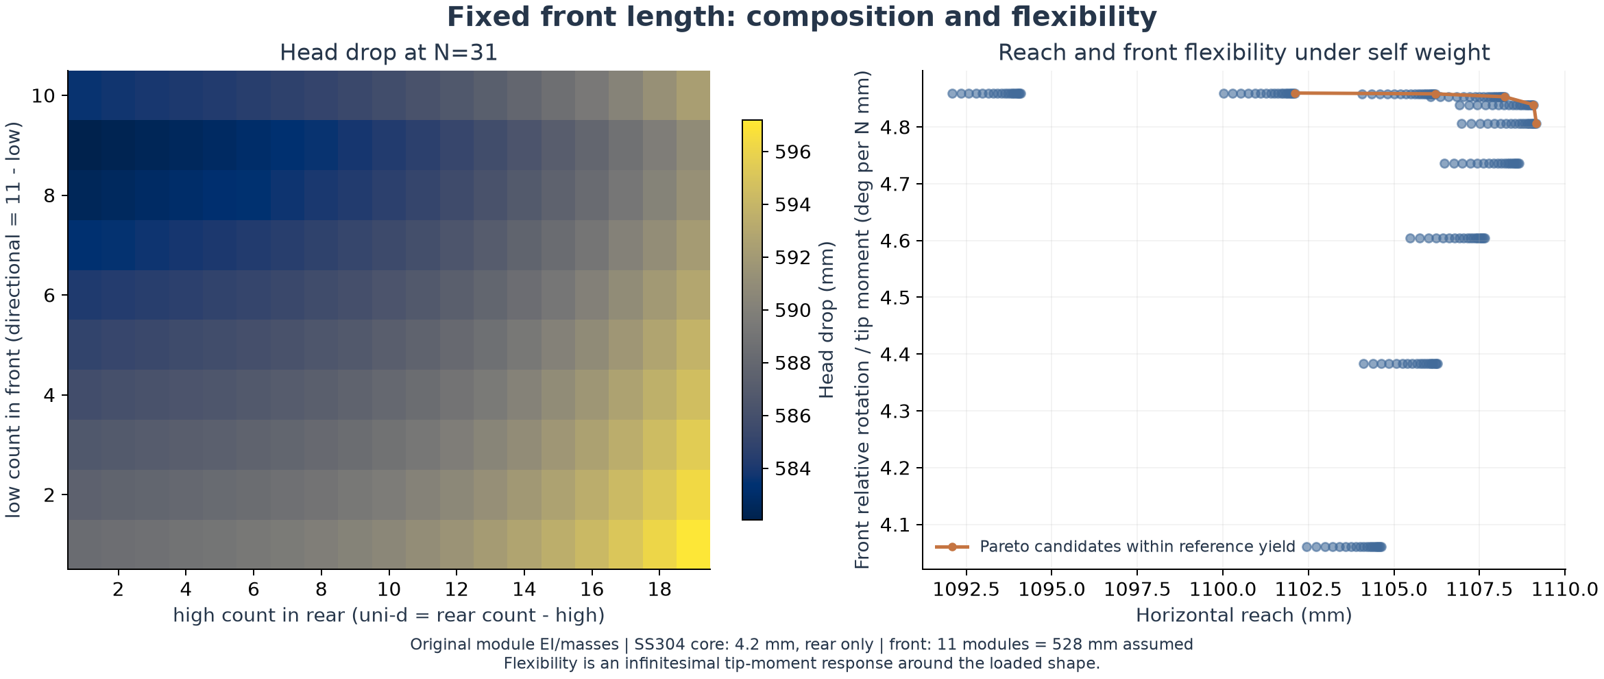
ASRC_kevin/rear_backbone_results/composition_and_flexibility.png
