KevinQianjin/ASRC_snake_body_design/ASRC_kevin/rear_backbone_results/rear_length_vs_shape.png

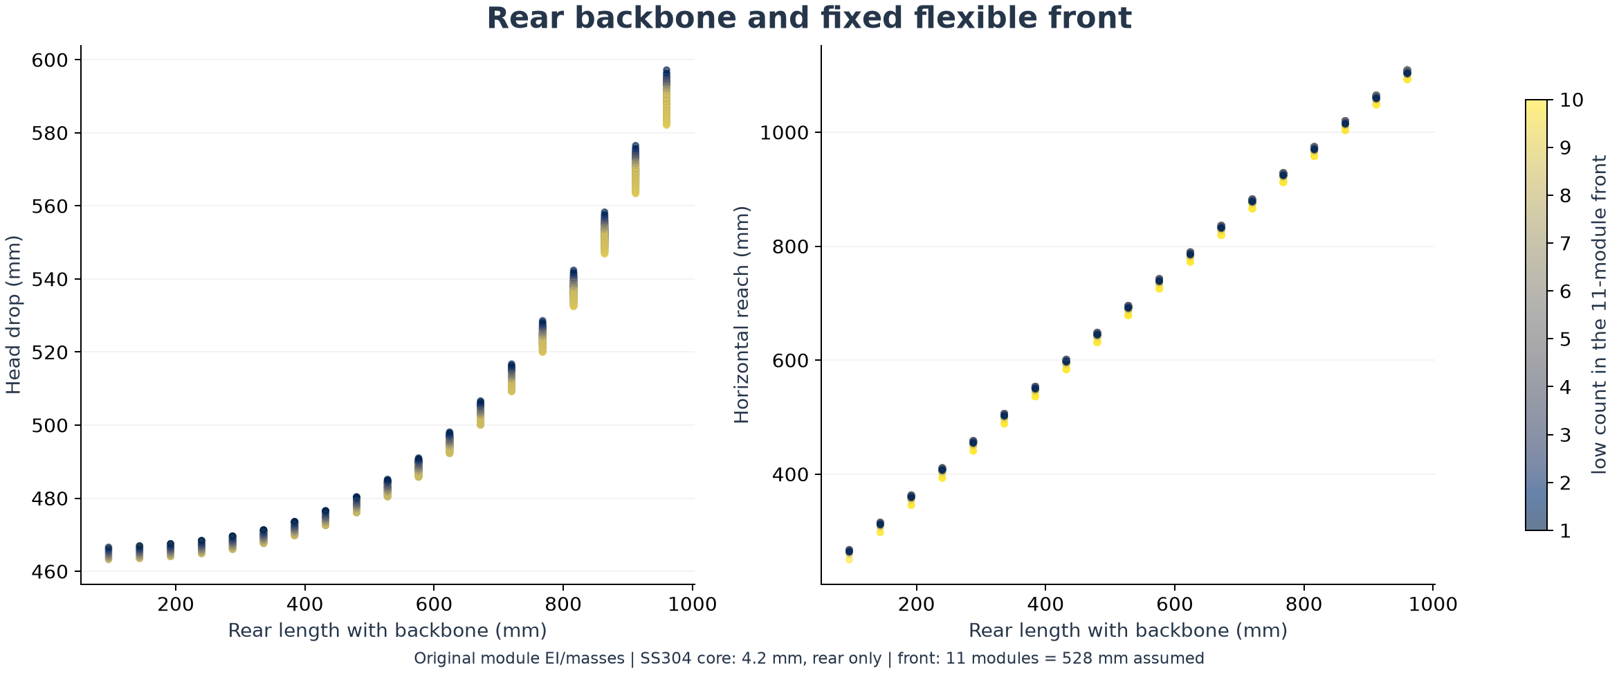
ASRC_kevin/rear_backbone_results/rear_length_vs_shape.png
