KevinQianjin/ASRC_snake_body_design/ASRC_kevin/rear_backbone_results/reference_shape_comparison.png

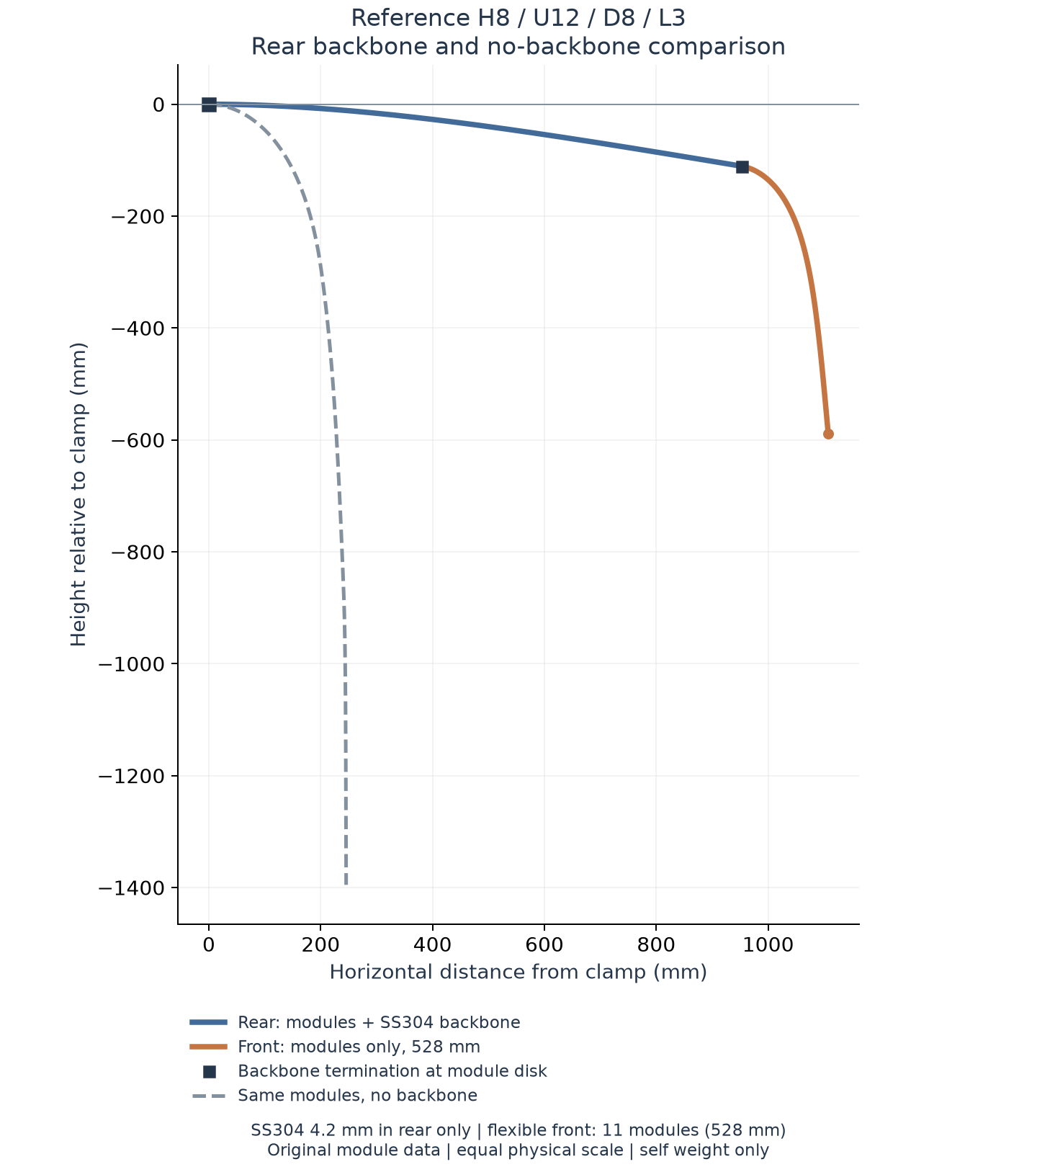
ASRC_kevin/rear_backbone_results/reference_shape_comparison.png
