KevinQianjin/ASRC_snake_body_design/ASRC_kevin/rope_results/comparison.png

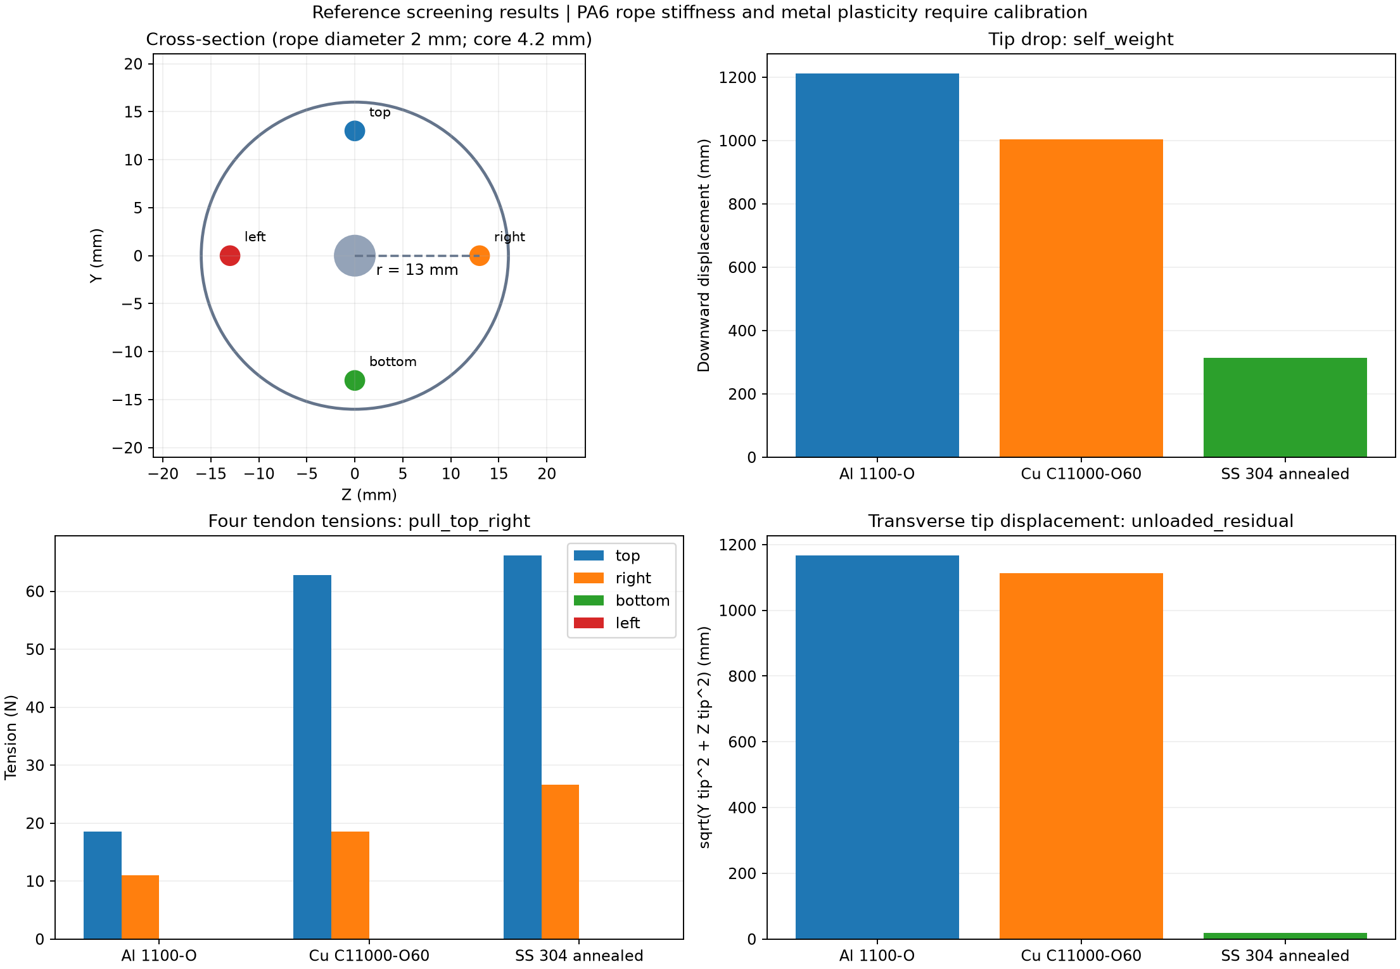
ASRC_kevin/rope_results/comparison.png
