KevinQianjin/ASRC_snake_body_design/ASRC_kevin/rope_results_level/inverse_level.png

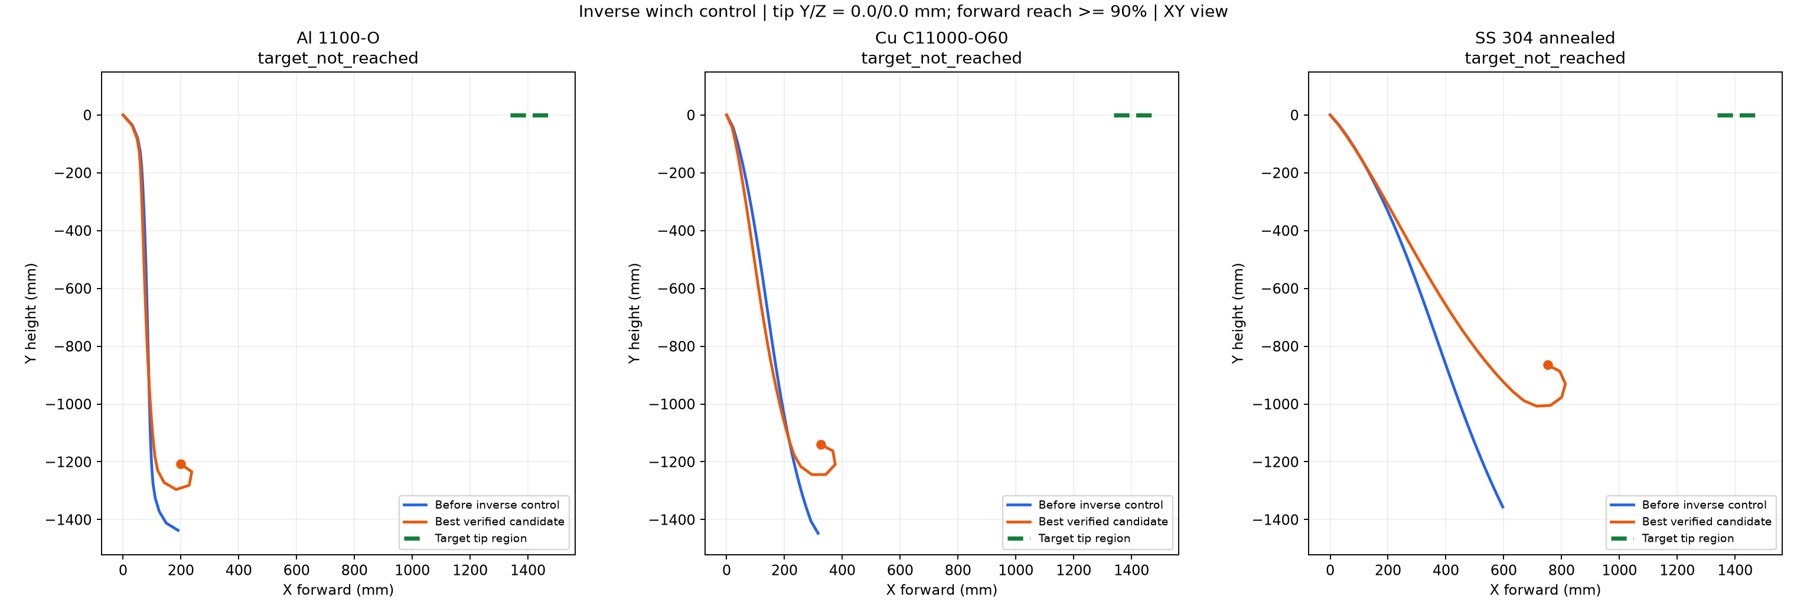
ASRC_kevin/rope_results_level/inverse_level.png
