KevinQianjin/ASRC_snake_body_design/ASRC_kevin/rope_results_level_hold/hold_horizontal.png

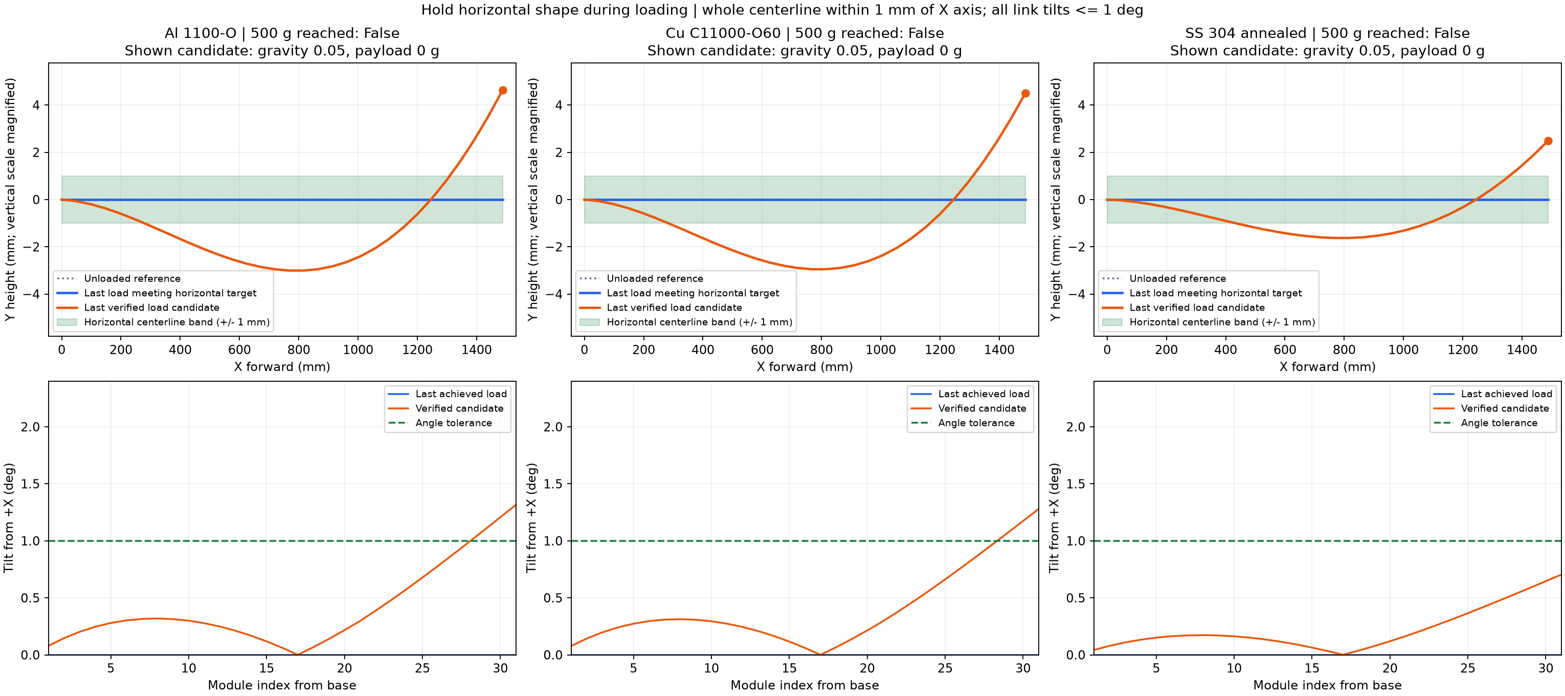
ASRC_kevin/rope_results_level_hold/hold_horizontal.png
