KevinQianjin/ASRC_snake_body_design/ASRC_kevin/rope_results_tip500g/comparison.png

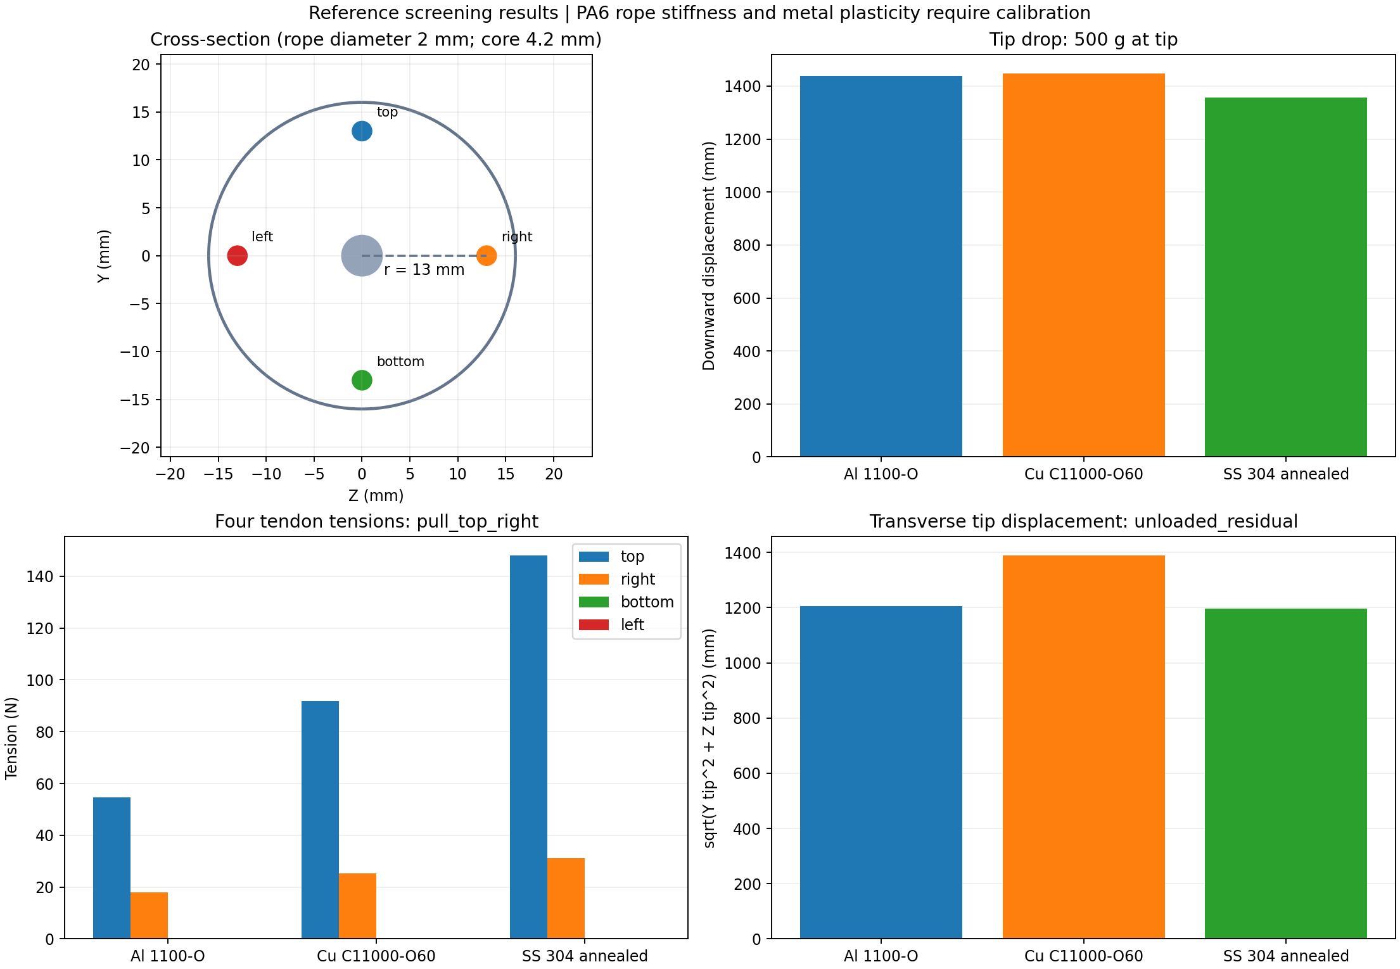
ASRC_kevin/rope_results_tip500g/comparison.png
