KevinQianjin/ASRC_snake_body_design/ASRC_kevin/rope_results_tip500g/shapes_3d.png

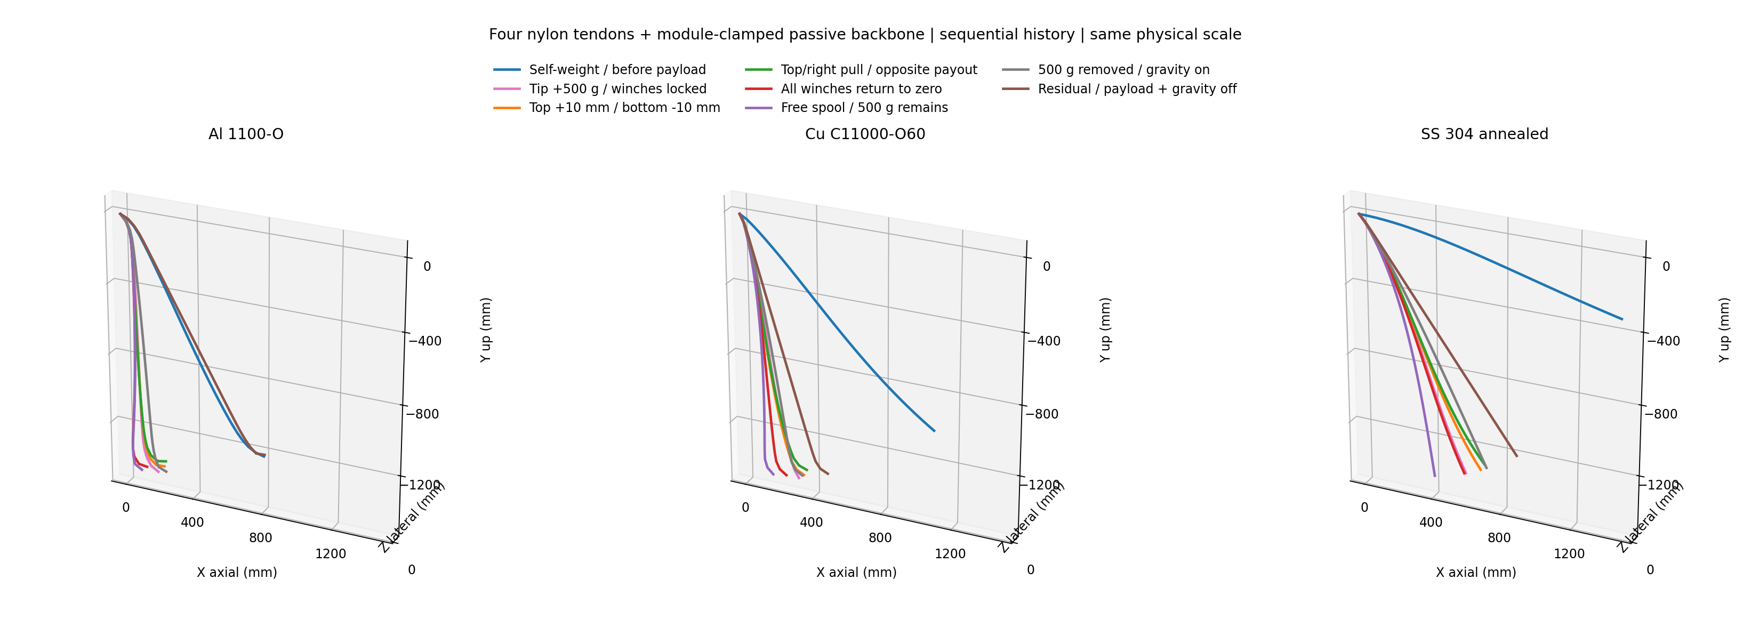
ASRC_kevin/rope_results_tip500g/shapes_3d.png
