KevinQianjin/ASRC_snake_body_design/reach_extension_results/payload_effect_on_candidates.png

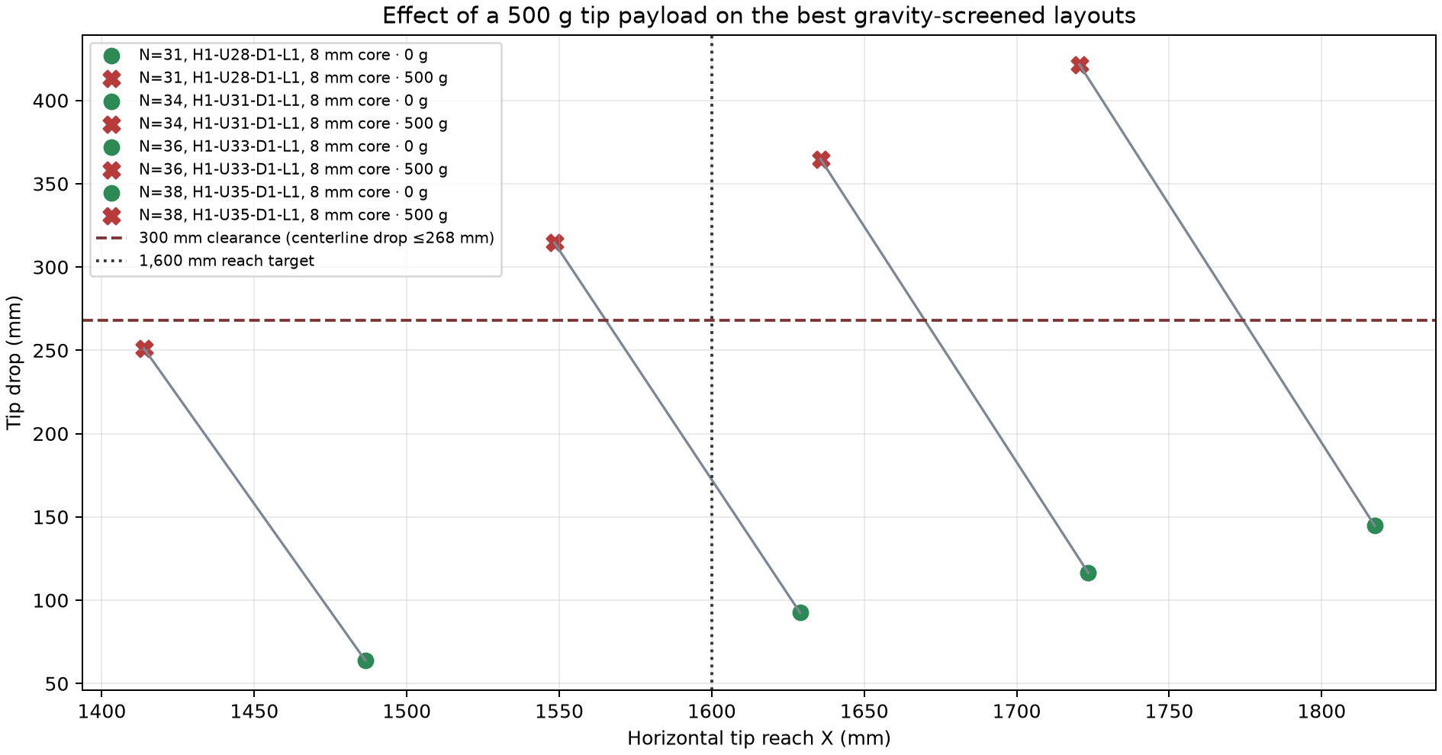
reach_extension_results/payload_effect_on_candidates.png
