KevinQianjin/ASRC_snake_body_design/reach_extension_results/reach_sag_tradeoff.png

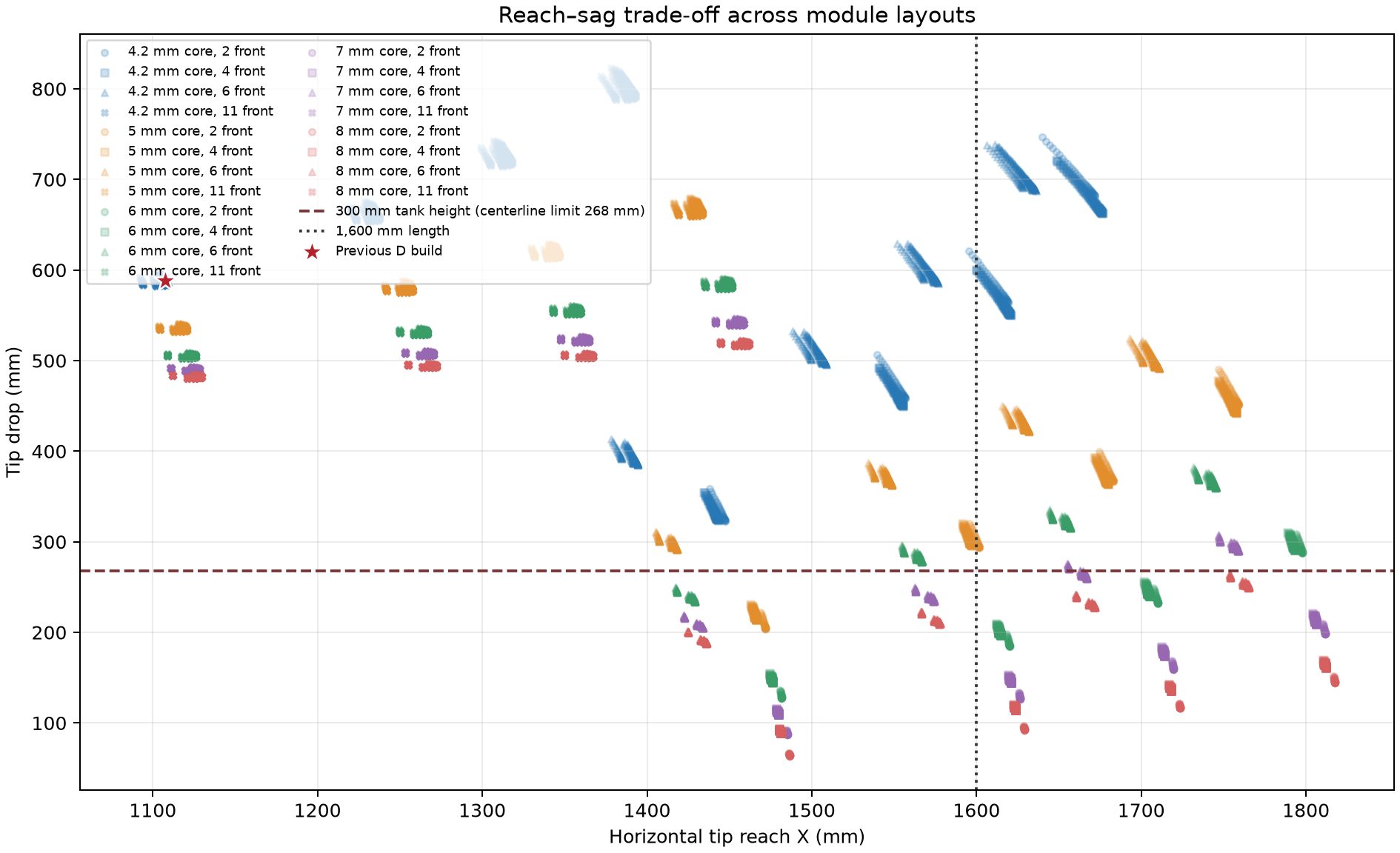
reach_extension_results/reach_sag_tradeoff.png
