KevinQianjin/ASRC_snake_body_design/reach_extension_results/reach_target_screen_counts.png

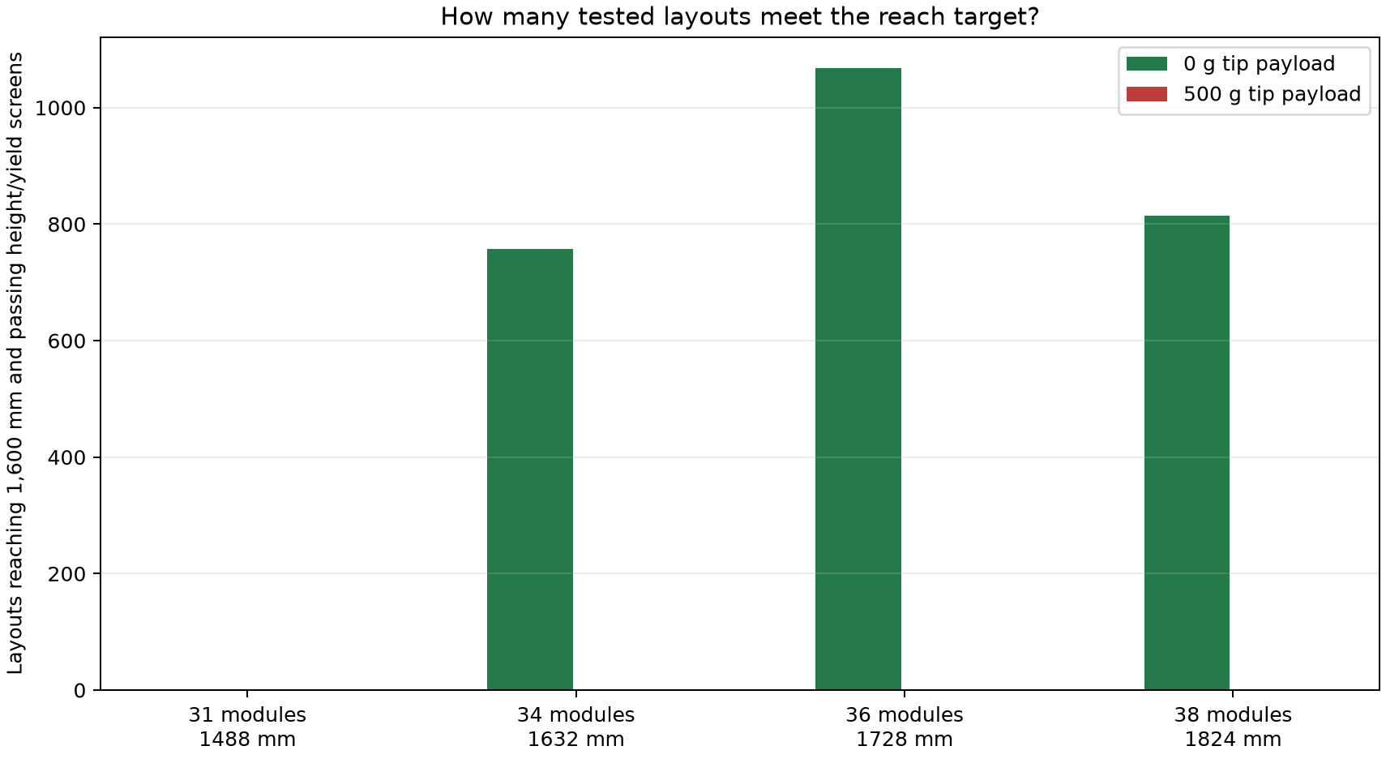
reach_extension_results/reach_target_screen_counts.png
