KevinQianjin/ASRC_snake_body_design/reach_extension_results/reach_vs_length.png

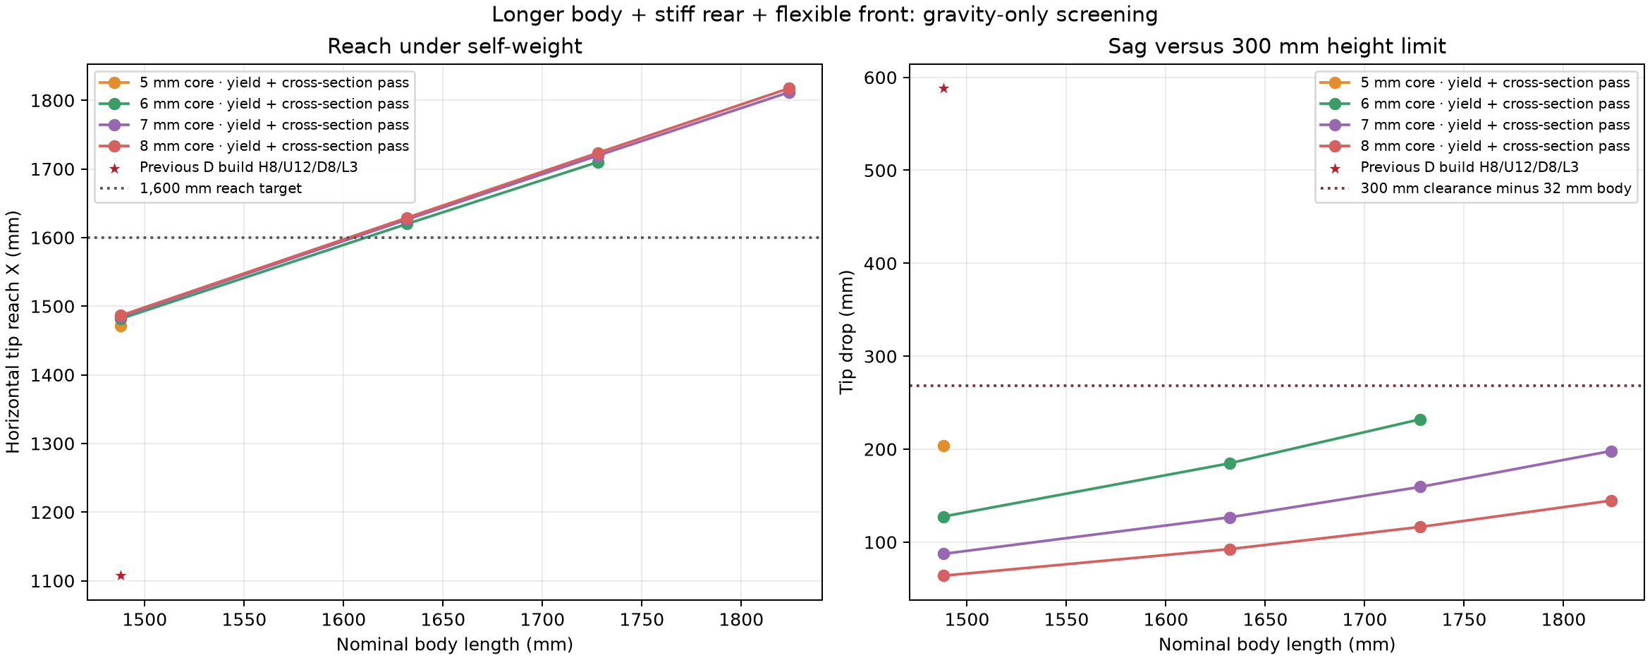
reach_extension_results/reach_vs_length.png
