KevinQianjin/ASRC_snake_body_design/reach_extension_results/reference_stack_extension.png

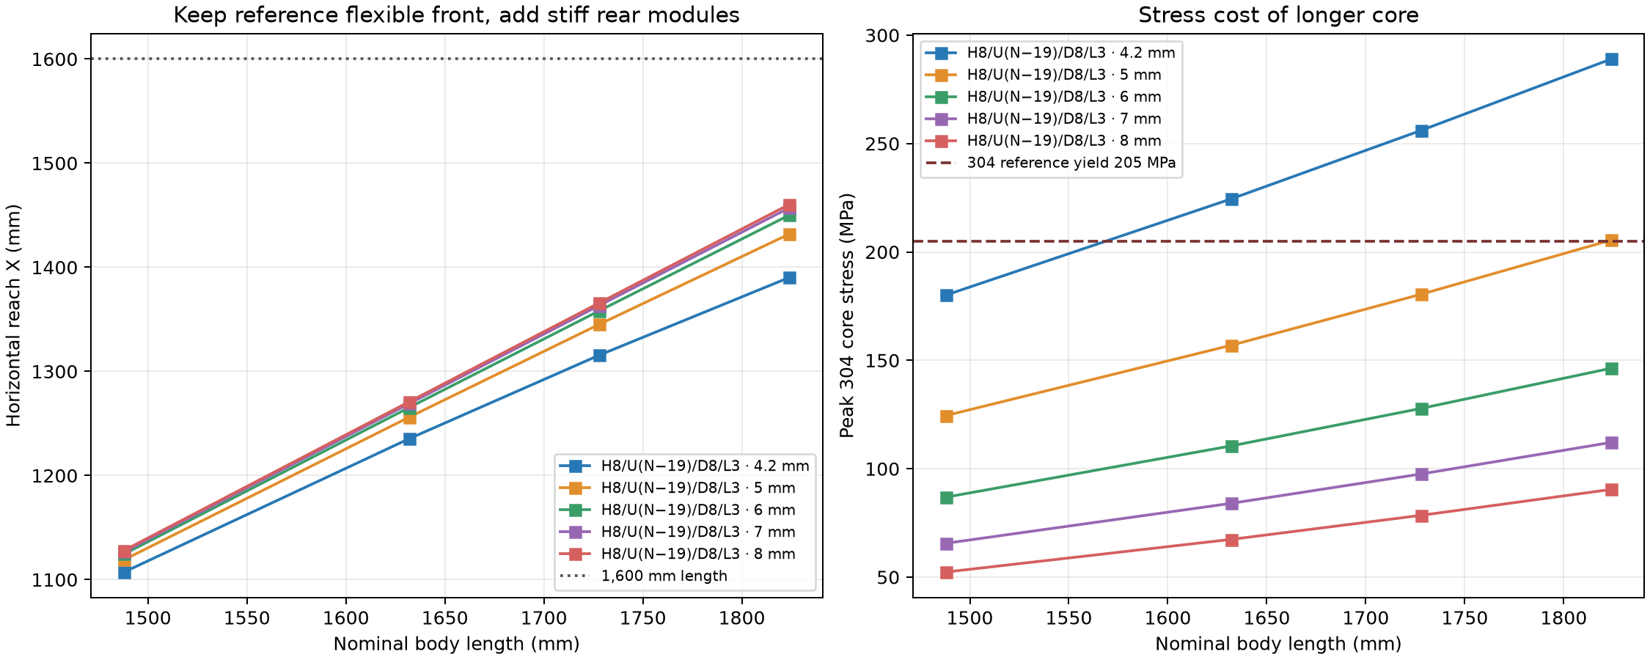
reach_extension_results/reference_stack_extension.png
