KevinQianjin/ASRC_snake_body_design/simulations/shared/h8u12_front5to8_payload500g/results/front_06_loaded_shapes.png

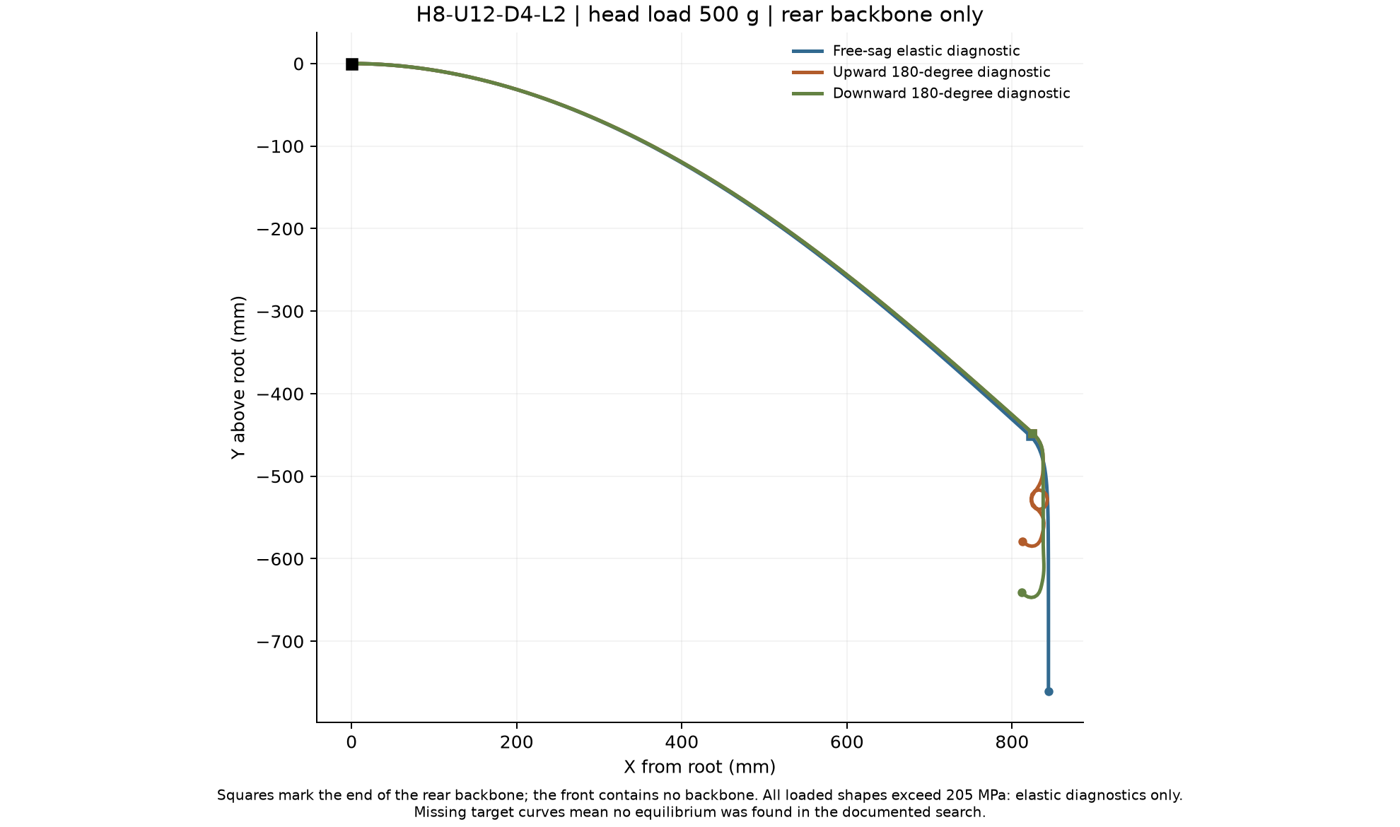
simulations/shared/h8u12_front5to8_payload500g/results/front_06_loaded_shapes.png
