KevinQianjin/ASRC_snake_body_design/simulations/u4m2/backbone_20261108/length_cycle_results_pre3_tol1/cycle_comparison.png

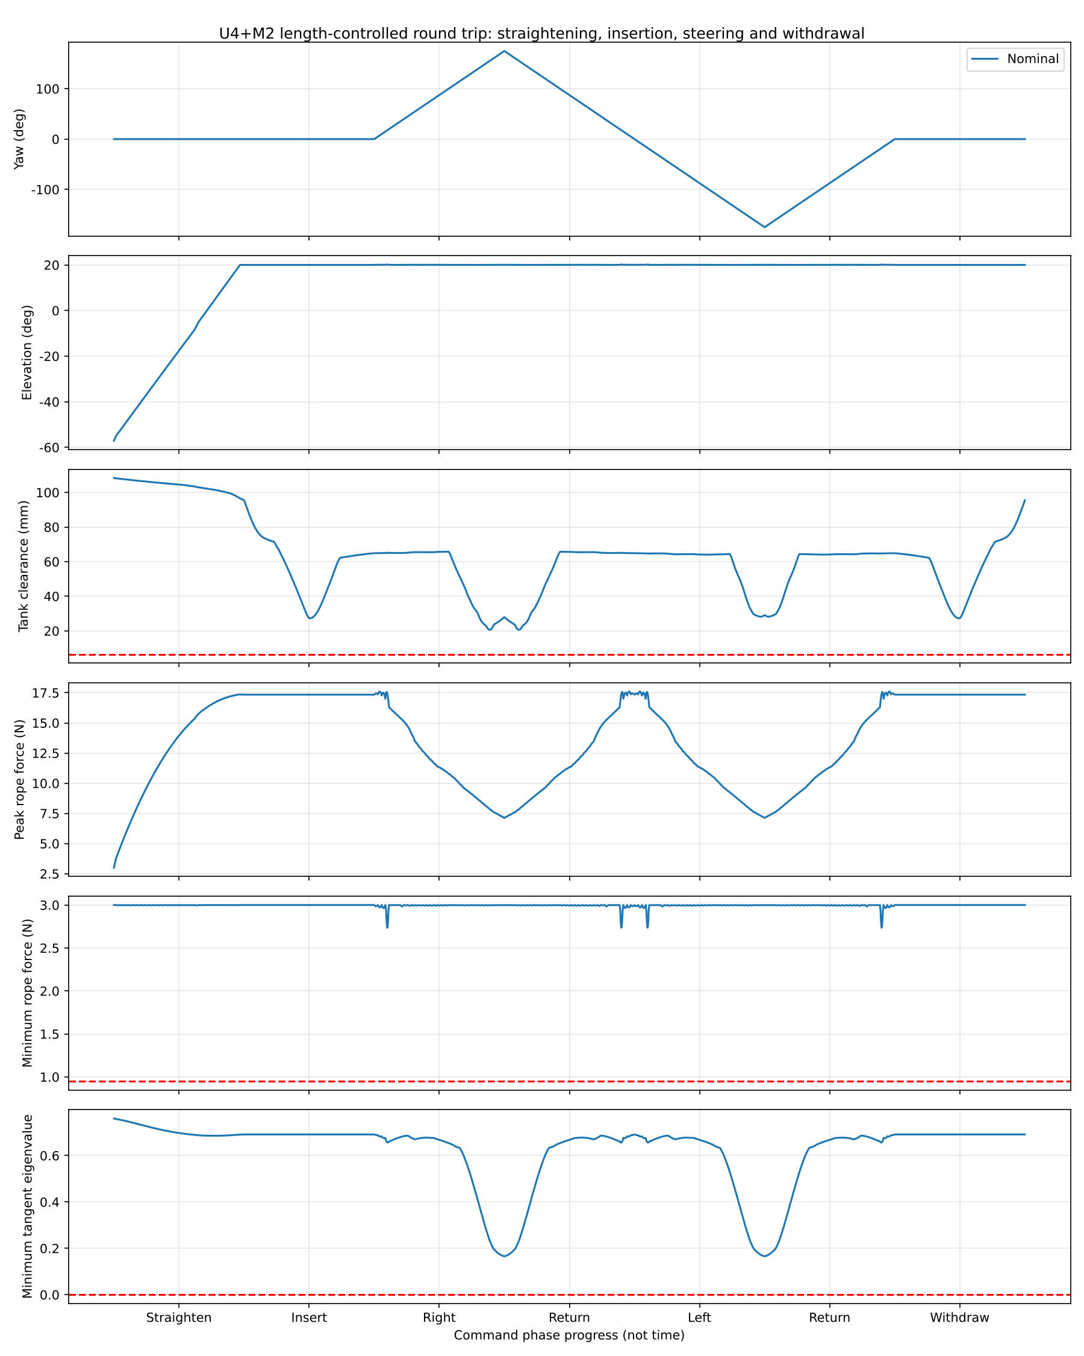
simulations/u4m2/backbone_20261108/length_cycle_results_pre3_tol1/cycle_comparison.png
