KevinQianjin/ASRC_snake_body_design/simulations/u4m2/results/deployment_path.png

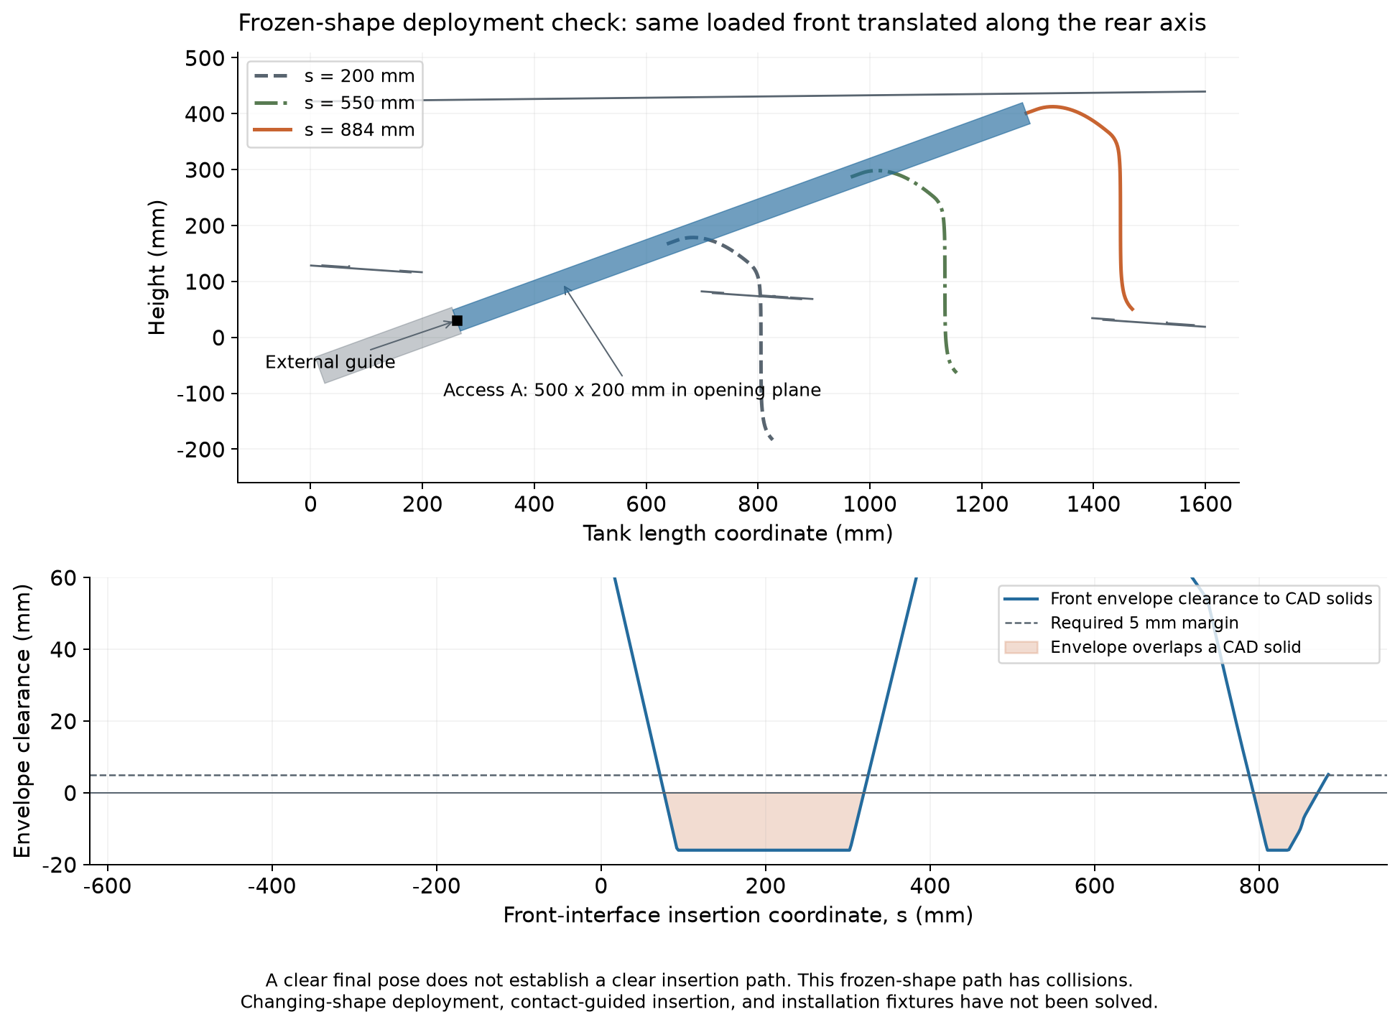
simulations/u4m2/results/deployment_path.png
