KevinQianjin/ASRC_snake_body_design/simulations/u4m2/results/front_and_geometry_limits.png

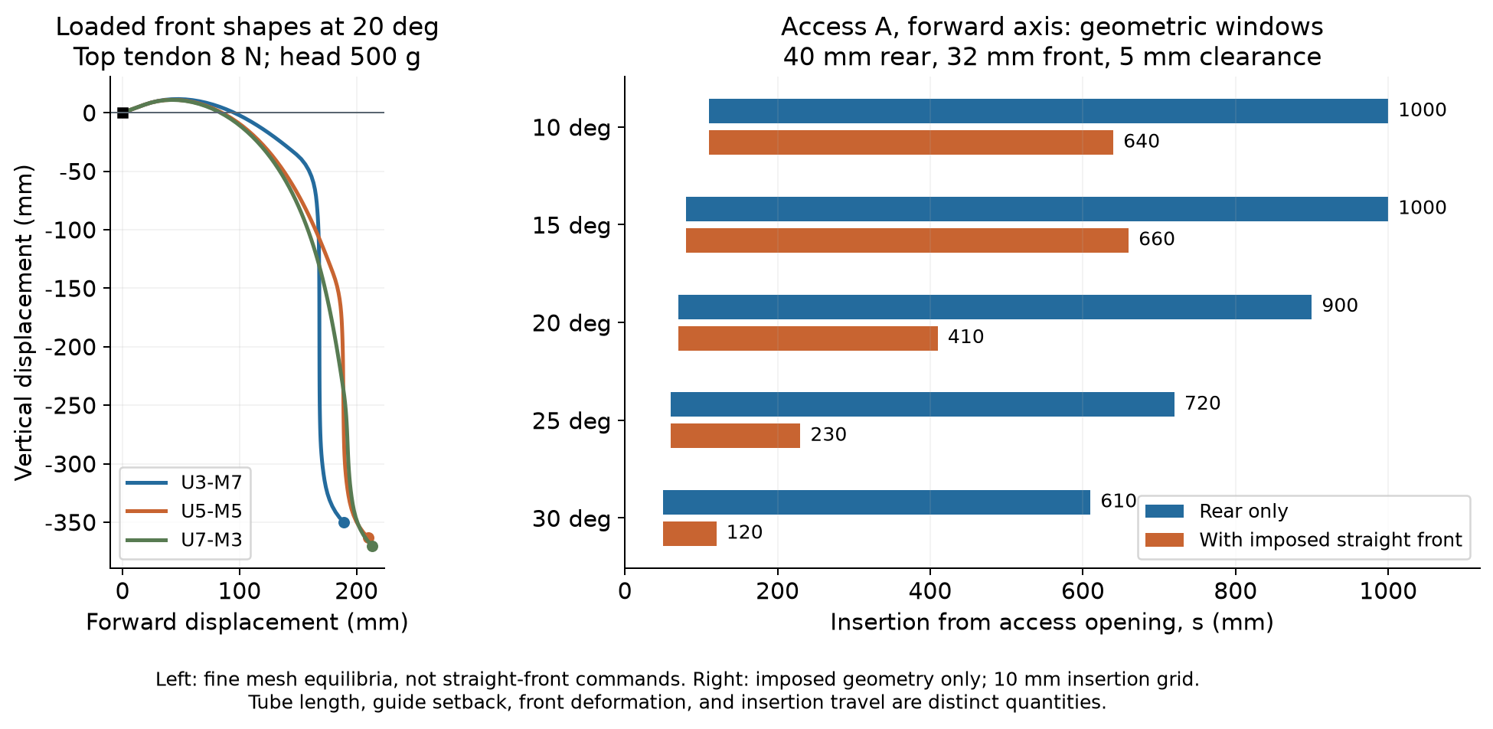
simulations/u4m2/results/front_and_geometry_limits.png
