KevinQianjin/ASRC_snake_body_design/simulations/u4m2/steering_63mm_20261106/results/spatial_steering_shapes.png

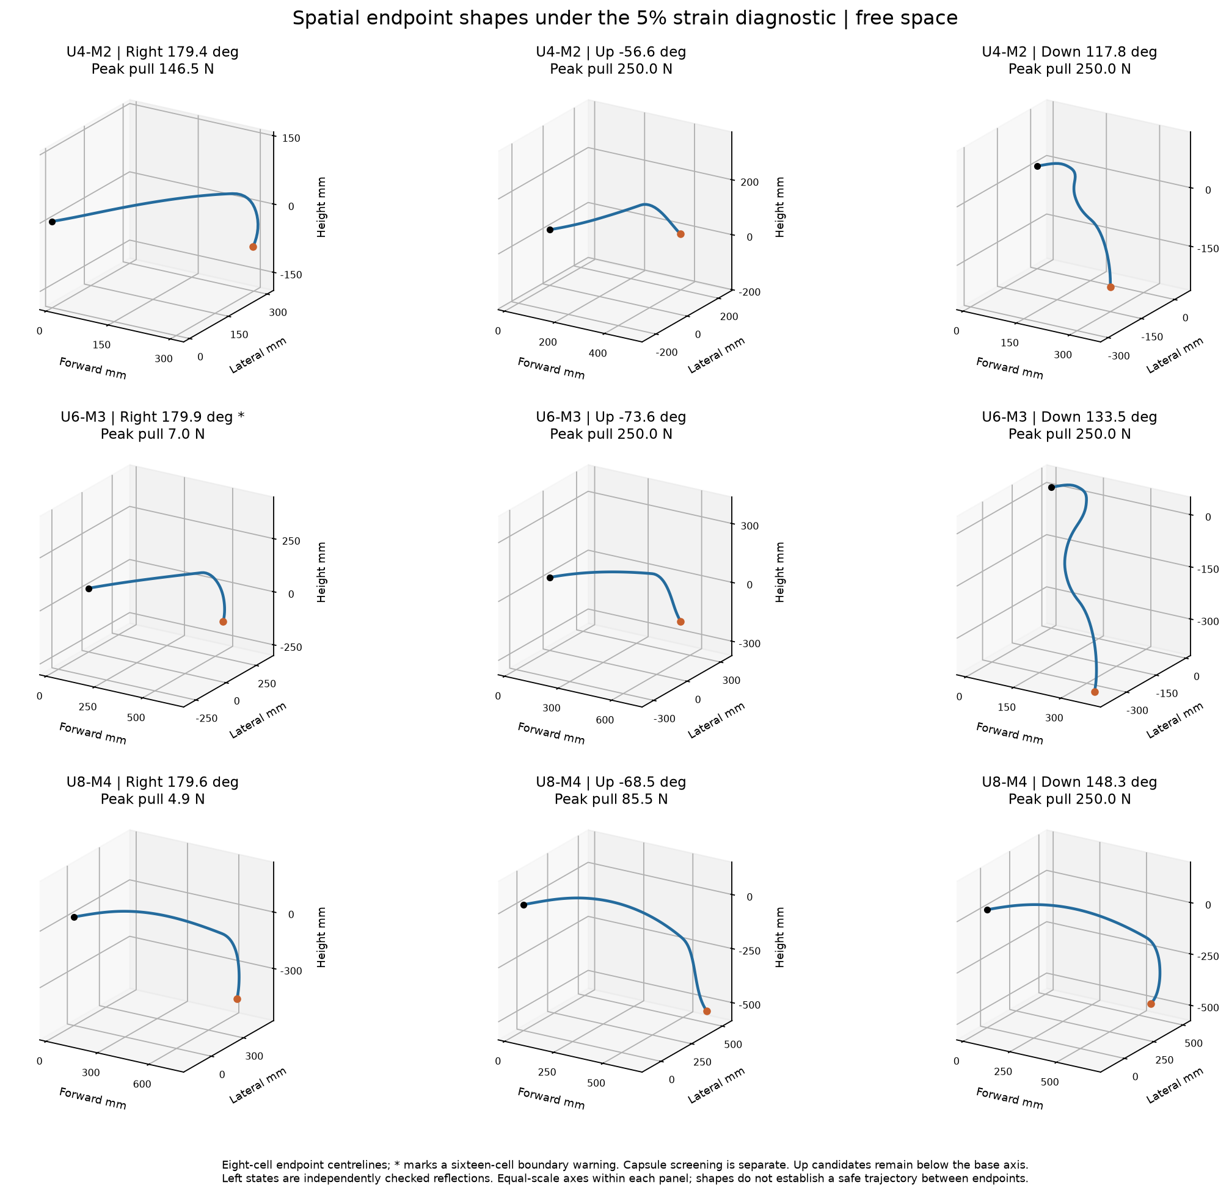
simulations/u4m2/steering_63mm_20261106/results/spatial_steering_shapes.png
