KevinQianjin/ASRC_snake_body_design/(commit log)

2026-11-04 Upload ASRC_kevin folder 2026-11-04 23:05:04 HKT
    [F05_R02.csv, F05_R03.csv, F05_R04.csv, F05_R05.csv, F05_R06.csv, F05_R07.csv, F05_R08.csv, F05_R09.csv]
2026-11-05 Upload ASRC_kevin folder 2026-11-05 12:52:43 HKT
    [H8-U12-D1-L4_down_closest_stress.csv, H8-U12-D1-L4_free_sag.csv, H8-U12-D1-L4_front_semicircle_down.csv, H8-U12-D1-L4_left_closest_stress.csv, H8-U12-D1-L4_right_closest_stress.csv, H8-U12-D1-L4_up_closest_stress.csv, H8-U12-D1-L5_down_closest_stress.csv, H8-U12-D1-L5_free_sag.csv]
2026-11-05 Upload ASRC_kevin folder 2026-11-05 21:11:52 HKT
    [adaptive_low_strain_screen.csv, front_angle_extension.csv, front_angle_extension_attempts.csv, front_attempts.csv, front_cad_placements.csv, front_equilibria.csv, front_refinements.csv, geometry_axis_windows.csv]
2026-11-06 Add reach extension screening study and comparison plots
    [reference_stack_candidates.csv, summary_by_length_front_core.csv]
2026-11-06 Upload ASRC_kevin folder 2026-11-06 22:55:08 HKT
    [U4_M2_attempts.csv, U4_M2_optimizer_attempts.csv, U4_M2_single_sweep.csv, U6_M3_attempts.csv, U6_M3_optimizer_attempts.csv, U6_M3_single_sweep.csv, U8_M4_attempts.csv, U8_M4_optimizer_attempts.csv]
2026-11-06 Upload ASRC_kevin folder 2026-11-06 23:15:59 HKT
    [U4_M2_force_curves.csv, U6_M3_force_curves.csv, U8_M4_force_curves.csv, force_continuations.csv, maximum_steering.csv, mesh_checks.csv, pitch_sensitivity.csv, tendon_tensions.csv]
2026-11-07 Make steering study README English-only
2026-11-08 Add M module EA/EI requirement sweep for U4+M2
    Scales M axial and bending stiffness in the 2026-11-06 planar kernel to find
    the minimum M stiffness at which an actively straightened U4+M2 front passes
    all straightness checks within the 5% strain diagnostic. EA alone plateaus at
    ~7.1 deg tangent error; EA x5 with EI x1.25 and anchors [4,5,6] is the first
    passing combination, verified at 16 cells per module. README sizes a central
    NiTi backbone as the candidate implementation.
    Claude-Session: https://claude.ai/code/session_01Cdn83Min84YRs9UXPN21YP
    [optimizer_attempts.csv, sweep_rows.csv]
2026-11-08 Add NiTi backbone study: rod mass, 15/25 deg, U6+M3, spatial steering, test plan
    Adds a central 1.8 mm NiTi rod (E 40 and 75 GPa) to each M module, with its
    mass, and re-runs the planar straightening study for U4+M2, U6+M3 and U8+M4
    at 15/20/25 deg and the spatial steering/held-elevation search for U4+M2,
    refined to 8 cells per module. U4+M2 passes all straightness checks at every
    pitch and reaches the 180 deg yaw cap with head elevation held within 20+/-5 deg
    at 20 deg pitch; U6+M3 and U8+M4 still fail with <=3 anchor sets (exhaustive
    3-set layout search). No-rod controls reproduce the 2026-11-06 results.
    Includes a build and test plan for the backbone M module and updates the
    project index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
    [planar_U4_M2_optimizer_attempts.csv, planar_U4_M2_rows.csv, planar_U6_M3_all3_optimizer_attempts.csv, planar_U6_M3_all3_rows.csv, planar_U6_M3_optimizer_attempts.csv, planar_U6_M3_rows.csv, planar_U8_M4_all3_optimizer_attempts.csv, planar_U8_M4_all3_rows.csv]
2026-11-08 Add 8 November simulation review report and refresh project README
    Report_2026_11_08.pdf summarises the M stiffness requirement sweep and the
    NiTi backbone straightening, steering and test-plan work, generated from saved
    results by reports/build_report_2026_11_08.py. README now leads with the
    current status table, latest studies and next steps, keeps the 6 November
    studies as the baseline, and uses relative links.
    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
2026-11-09 Re-run front-only tank entry screen with backbone low-strain shapes
    Reuses the 2026-11-06 path_check unchanged (control reproduces 62.06 mm).
    U4+M2 with the 1.8 mm NiTi backbone passes at 15/20/25 deg with 44/64/17 mm
    minimum clearance at ~0.1% strain, confirmed at 16 cells per module; all
    current-M low-strain shapes still hit the tank. Adds figure, README section
    and project index updates.
    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
    [entry_screen.csv]
2026-11-09 Add minimum-force held-elevation yaw sweeps and 3D pretension stability check
    Finds that the straightened backbone states with only the up ropes tensioned
    are laterally unstable in 3D (fixed winch); a 1 N pretension on every rope
    stabilises them, and straightening and tank entry still pass when re-optimised
    with it. Minimum peak-force continuation sweeps (0-180 deg yaw, 5 deg steps,
    head elevation held at the base pitch, 8 cells per module) need about 7-15 N
    with anchors [4,5,6], versus 46-98 N for the earlier max-angle allocations;
    a smoothness penalty limits rope changes to 5.1 N per step. Documents the
    twist and up-and-over posture used near 180 deg.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
2026-11-09 Add full 3D tank clearance screen script (run in progress)
    Triangulates the named tank subtree of tank-v2.step (mesh cached outside git)
    and measures exact clearance of the 63 mm envelope along the front centreline
    for the entry path and the held-elevation yaw sweeps, both lateral senses.
    Mesh agrees with the saved 2D sections within 0.23 mm.
    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
2026-11-09 Add 3D tank screen results: entry paths and yaw sweeps at s = 90/200/300 mm
    Entry in full 3D: 46.8 / 64.6 / 19.3 mm minimum clearance at 15/20/25 deg up
    to the first fully-inside position, confirming the 2D section screen across
    the full front width. Held-elevation yaw sweeps at 20 deg, s = 90 mm: clear
    0-130 deg (right) and 0-160 deg (left); the up-and-over posture near 180 deg
    reaches the tank roof. 25 deg sweeps hit the roof at these depths.
    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
2026-11-09 Add shallow-clamp 3D tank sweeps, figure and write-up
    At 20 deg with the clamp at s = 0-30 mm the full held-elevation yaw sweep
    (0-175/180 deg, both sides) clears the 3D tank by at least 12.6 mm; deeper
    clamp positions and 25 deg reach the tank roof. Entry paths in full 3D
    confirm the 2D section screen (46.8 / 64.6 / 19.3 mm). Adds README section 6,
    figure and project index updates.
    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
2026-11-09 Add horizontal flexibility test: yaw vs side-rope pull
    Starting from the straight held front at 20 deg, pulls only the right rope
    (anchor 4, 5, 6 or all) under winch (rope-length) control and, for
    comparison, tension control, at 8 cells per module. Tension control snaps
    (258 mm head jump at +0.5 N) because the straight pose is unstable at
    constant tension; winch control is stable and smooth. The tip rope gives
    about 1.25 deg of yaw per mm of pull-in and keeps head elevation in 20+/-5
    deg up to about 19-20 deg yaw; larger yaw needs coordinated up-rope pull.
    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
2026-11-09 Add 9 November daily report, results presentation and refreshed README
    Report_2026_11_09.pdf summarises today's work (tank entry with the low-strain
    shape, 3D pretension stability, minimum-force held-elevation yaw, full 3D tank
    clearance, side-rope horizontal flexibility), generated from saved results by
    reports/build_report_2026_11_09.py. ASRC_Presentation_2026_11_09.pptx is a
    13-slide deck of all latest results with speaker notes, built by
    reports/build_presentation_2026_11_09.js. README rewritten around the current
    status, decisions and next steps.
    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
2026-11-10 Add M module backbone prototype model
    [M2_backbone_prototype.scad]
2026-11-10 Exclude tendon preview from shell export
    [M2_backbone_prototype.scad]
2026-11-10 Add shared OpenSCAD geometry for backbone prototype
    [module_common.scad]
2026-11-10 Add OpenSCAD prototype source files
    [tendon_joint_prototype.scad]
2026-11-10 Document OpenSCAD prototype file set
2026-11-10 Add self-contained OpenSCAD assembly file
    [00_full_assembly_standalone.scad]
2026-11-10 Document standalone assembly download
2026-11-10 Add integrated U4 M2 backbone assembly and part selector
    [U4M2_backbone_assembly.scad]
2026-11-10 Add short prototype build and purchase guide
2026-11-10 Extend M2 guide webs to fuse with shell
    [M2_backbone_prototype.scad]
2026-11-10 Point prototype overview to integrated backbone model
2026-11-10 Mark early SCAD placeholders as non-final
    [U4M2_backbone_assembly.scad]
2026-11-10 Add STEP-derived full-scale U4+M2 SCAD assembly
    [M_module_96.scad, Medium_Stiffness_96.stl, U_module_96.scad, UniDirectional_96.stl, final_u4m2_assembly.scad]
2026-11-10 Preserve U module solids as separate meshes
    [U_module_96.scad, UniDirectional_96.stl, UniDirectional_96_part_01.stl, UniDirectional_96_part_02.stl, UniDirectional_96_part_03.stl, UniDirectional_96_part_04.stl, UniDirectional_96_part_05.stl, final_u4m2_assembly.scad]
2026-11-10 Add coordinated winch-control test between the 5 deg poses
    All 12 winch lengths follow the minimum-force poses together (20 sub-steps
    per 5 deg segment, fixed-winch elastic rope model, 8 cells per module). The
    head moves smoothly from 0 to 175 deg (E 40 GPa) and 0 to 180 deg (E 75 GPa)
    at 19.2-20.1 deg elevation; every state is stable, no rope goes slack, the
    backward sweep reproduces the forward one, and the in-between states clear
    the 3D tank. Adds winch command tables, figure, README section 8 and project
    index updates.
    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
    [coordwinch_E40_winch_table.csv, coordwinch_E75_winch_table.csv]
2026-11-10 Add winch position error and rope stretch sensitivity study
    Offsets each of the 12 winch lengths by +/-0.5 and +/-1 mm at seven poses of
    the coordinated held-elevation sweep (full nonlinear model, 8 cells per
    module, both rod moduli), builds the sensitivity matrix, predicts combined
    random errors (checked with the full model) and tests rope EA +/-10%.
    Holding +/-1 deg open-loop needs about +/-0.2-0.5 mm on every winch, dominated
    by the four tip ropes; rope EA error is minor. All cases stay stable, but
    1 N pretension ropes go slack beyond ~0.15 mm error, so head-angle feedback
    and a higher pretension are recommended.
    Claude-Session: htt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
2026-11-10 Mark STEP-derived U4+M2 package incomplete
    [M_module_96.scad, U_module_96.scad, final_u4m2_assembly.scad]
2026-11-10 Correct STEP geometry completeness assessment
    [U_module_96.scad, final_u4m2_assembly.scad]
2026-11-11 Add backbone screening data
    [layout_screening.csv]
2026-11-11 Document independent backbone rod layout
2026-11-11 Show proposed separate backbone rod retention points
    [U4M2_backbone_assembly.scad]
2026-11-11 Add backbone anchor fit coupon SCAD
    [09_backbone_anchor_coupon.scad]
2026-11-11 Add moving prototype BOM and build steps
2026-11-11 Export model input data sheet for the U4+M2 NiTi-backbone model
    export_model_data.py builds the planar and spatial model objects for the
    no-rod, E 40 GPa and E 75 GPa cases and writes every input they use:
    geometry (continuous 96 mm modules, no pin gap), per-module mass, EA, EI
    and torsion, rod properties, payload, tendon and winch model, installation
    and tank data, numerics and acceptance criteria. Outputs model_data.json,
    module_properties.csv and a readable MODEL_DATA.md.
    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
    [module_properties.csv]
2026-11-11 Mark full_length prototype files as not matching the simulated design
    The moving_prototype/full_length files use 84 mm shells with 12 mm pin joints
    and two separate backbone rods with a free joint. The design and all
    simulations use continuous 96 mm modules with a full-length 1.8 mm NiTi rod
    in each M module. Adds an ignore notice to every document, a header comment
    to every SCAD and Python file, NOT_THE_SIMULATED_DESIGN.md, and a README
    note. No geometry or code behaviour is changed.
    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
    [00_full_assembly.scad, 00_full_assembly_standalone.scad, 01_U1_base.scad, 02_U2.scad, 03_U3.scad, 04_U4.scad, 05_M1.scad, 06_M2_tip.scad]
2026-11-11 Re-run the round-trip cycle with 3 N pretension and a stable startup
    Same model parameters (continuous 96 mm modules, full-length 1.8 mm NiTi rod,
    E 40 GPa, 500 g head). New rope-length commands: startup_sweep.py raises the
    head from natural sag to 20 deg through stable held states with every rope
    >= 3 N, and the minimum-force yaw sweep is regenerated with a 3 N floor from
    the startup end state. length_cycle.py gains optional --source/--startup/--out
    (default behaviour unchanged); summarize_cycle_run.py reports other folders.
    Nominal cycle: 0 of 1069 samples fail (was 56 of 1033), rope EA -20% also
    passes; E75, 550 g and 1.5 m free-rope cases fail only on open-loop
    calibration. A 5 N floor i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
    [E75.csv, free1500mm.csv, nominal.csv, payload550g.csv, ropeEA80pct.csv]
2026-11-11 Add 11 November daily report and refresh README
    Report_2026_11_11.pdf summarises today's work: review of the round-trip study
    and design limitations, the model data sheet, marking of the full_length
    prototype files, and the round-trip cycle re-run with a 3 N pretension floor
    and a stable startup. Generated from saved results by
    reports/build_report_2026_11_11.py. README links the report and the model
    data sheet, adds the round-trip result to the status table, updates the
    pretension decision to 3 N and adds the closed-loop round trip as next step.
    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
2026-11-11 Move current design limitations to the top of the README
    The 'Current design limitations (11 November 2026)' section, with its update
    note and priorities, now follows the project introduction. Content is
    unchanged.
    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
2026-11-12 U4+M2 Closed-Loop Round-Trip Simulation
    Output feedback uses ideal simulated measurements of head yaw/elevation and all 12 rope tensions. Controller gains come only from the nominal E40, 500 g, 1 m model; plant perturbations are not supplied to the gain calculation. The plant is a quasi-static equilibrium solver, not a dynamic or hardware model.
    [E75.csv, free1500mm.csv, nominal.csv, payload550g.csv, ropeEA80pct.csv]
2026-11-12 Complete repository reorganization and restore full README
    [00_full_assembly.scad, 00_full_assembly_standalone.scad, 01_U1_base.scad, 02_U2.scad, 03_U3.scad, 04_U4.scad, 05_M1.scad, 06_M2_tip.scad]
2026-11-12 Detail latest results and separate prototype documentation
2026-11-12 Add STEP-derived M end-disk coupon
    [M_end_disk_coupon.scad]
2026-11-12 Move M end-disk coupon into the reorganized CAD preview folder
    The STEP-derived M end-disk coupon was added under the pre-reorganization
    path ASRC_kevin/moving_prototype/final_u4m2/, where it cannot find
    Medium_Stiffness_96.stl (moved to cad/previews/u4m2/). Move it beside the
    STL, document it in the preview README and the path migration table, and
    refresh model_data.json source paths to the new locations. ASRC_kevin/ no
    longer contains tracked files.
    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
    [M_end_disk_coupon.scad, path_migration.csv]
2026-11-12 Add closed-loop round trip v2: operating pretension and refined path
    closed_loop_v2.py keeps the model, 3 N stable-startup reference, nominal gains
    and five plant cases of closed_loop_cycle.py, and changes the control sequence:
    a 3 N tension target in the correction QP (settle at >= 2.5 N), tension-aware
    pre-correction before each feedforward command from measured tensions and
    nominal gains, and transitions subdivided to <= 0.25 mm rope steps and
    <= 4.5 mm node movement with every intermediate state solved and checked.
    Every recorded state of all five cases stays at >= 2.62 N (v1: down to
    0.57 N, 1321-1896 states below 2.5 N); largest node move 2.5-4.5 mm (v1: up
    to 6.8 mm); no unstable, ge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
    [E75.csv, free1500mm.csv, nominal.csv, payload550g.csv, ropeEA80pct.csv]
2026-11-12 Closed loop v3 inputs: exact 20 deg reference, mid-move correction (in progress)
    min_force_sweep.py gains --elev-tol; the 3 N yaw sweep is regenerated with
    every 8-cell pose at 20.0 deg (the 0 and 5 deg poses had been accepted at
    16-17 deg). New open-loop reference length_cycle_results_pre3_tol1 (nominal:
    all 1072 samples pass, elevation error <= 0.18 deg) and nominal gains for it.
    closed_loop_v2.py gains --ref/--gains/--prepare-gains and optional correction
    during feedforward moves (--mid-tol), kept only when the measured error
    decreases. The first mid-move attempt without that rule (overcorrection at
    160-175 deg yaw with a 550 g head) is kept as a diagnostic. Final v3 case
    results follow i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
    [E75.csv, free1500mm.csv, nominal.csv, payload550g.csv, ropeEA80pct.csv]
2026-11-12 Closed loop v3 results: exact 20 deg reference with guarded mid-move correction
    Five cases with the regenerated 20 deg reference and correction during
    feedforward moves kept only when the measured error decreases. Nominal, E75,
    1.5 m free rope and rope EA -20% pass every check in every recorded state
    (max angle error during motion 0.18-0.61 deg, tension >= 2.81 N, peak
    17.7-22.5 N). The 550 g case still has 202 recorded states above 1 deg at
    159-175 deg yaw (max 3.79 deg). Comparison v1/v2/v3 and figure included.
    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
    [E75.csv, free1500mm.csv, nominal.csv, payload550g.csv, ropeEA80pct.csv]
2026-11-12 Document closed loop v3: exact 20 deg reference and mid-move correction
    Adds the 550 g fixed-reference-only run and the write-up (study README
    section 13, project README, limitations, roadmap, simulation index). With the
    exact 20 deg reference, nominal, E75, 1.5 m free rope and rope EA -20% pass
    every check in every recorded state; the 550 g head keeps transient angle
    error at 155-175 deg yaw (115 states above 1 deg, max 3.1 deg) because the
    nominal gains have the wrong sign there. Correction during moves does not
    help and is not recommended; next is an online gain update.
    Claude-Session: https://claude.ai/code/session_01Cdn83Min84YRs9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
    [payload550g.csv]
2026-11-12 Add 12 November daily report and refresh README
    Report_2026_11_12.pdf summarises today's work: project check after the
    reorganisation, closed loop v2 (3 N operating tension, tension-aware arrival,
    refined path) and v3 (exact 20 deg reference; four of five cases pass every
    check in every recorded state; 550 g large-yaw transient remains), generated
    from saved results by reports/builders/build_report_2026_11_12.py. README and
    the reports index link it.
    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
2026-11-13 Add solver-aligned 500g CAD reference and conformance audit
    [module_properties.csv, simulation_reference.blend, simulation_reference.scad, tendon_coordinates.csv]
2026-11-13 Normalize reference CSV line endings
    [module_properties.csv, tendon_coordinates.csv]
2026-11-13 Radial rope lanes: lane model, re-run pipeline, lane-routed 3D modules and rope-chord check
    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
    [M5_lane_anchorB.stl, M6_lane_anchorC.stl, U4_lane_anchorA.stl, U_lane_pass.stl, U_leaf_springs.stl, lane_assembly.scad, nominal.csv]
2026-11-13 Lane closed-loop results, rope-routing limits and README/limitations updates
    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
    [E75.csv, free1500mm.csv, nominal.csv, payload550g.csv, ropeEA80pct.csv]
2026-11-13 Lane modules: solid end disks, keep only functional holes
    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
    [M5_lane_anchorB.stl, M6_lane_anchorC.stl, U4_lane_anchorA.stl, U_lane_pass.stl]
2026-11-13 Lane modules README: U centre hole filled
    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
2026-11-13 Move the rope-lane simulation to simulations/u4m2/lanes_20261113
    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
    [E75.csv, free1500mm.csv, nominal.csv, payload550g.csv, ropeEA80pct.csv]
2026-11-13 Lane front: build guide, base interface, head adapter, dowel/spring pockets, assembly check
    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
    [M5_lane_anchorB.stl, M6_lane_anchorC.stl, U4_lane_anchorA.stl, U_lane_pass.stl, base_interface.stl, head_adapter.stl, lane_assembly.scad]
2026-11-13 Install CAD kernel for geometry test
2026-11-13 Pin compatible OpenCascade Python bindings
2026-11-14 Add guided rope spans to U4+M2 rod model
2026-11-14 Validate guided cable model derivatives in CI
2026-11-14 Use transverse local-frame cable offsets
2026-11-14 Add experimental M-module rope guide concept
    [internal_rope_guide.scad]
2026-11-14 Add experimental guides to assembly preview
    [lane_assembly.scad]
2026-11-14 Align guide arms and lengthen rod sleeve
    [internal_rope_guide.scad]
2026-11-14 Trim guide spider arms to clear M body
    [internal_rope_guide.scad]
2026-11-14 Stagger guides away from M body intersections
    [internal_rope_guide.scad]
2026-11-14 Route guide arms around inner M flexure webs
    [internal_rope_guide.scad]
2026-11-14 Add compliant clips around M flexure webs
    [internal_rope_guide.scad]
2026-11-14 Increase flexure-web clip clearance
    [internal_rope_guide.scad]
2026-11-14 Place guide array at clear M-body stations
    [internal_rope_guide.scad]
2026-11-14 Align M5 and M6 assembly guide locations
    [lane_assembly.scad]
2026-11-14 Add rope guide prototype fit-test instructions
2026-11-14 Validate guided 500 g motion and record CAD contact failures
    [M5_lane_anchorB.stl, M5_preview_cutaway.stl, M5_z+12_caps.stl, M5_z+12_guide.stl, M5_z+12_wire_envelope.stl, M5_z+24_caps.stl, M5_z+24_guide.stl, M5_z+24_wire_envelope.stl]
